MrPerfekt/Maya/Doc/Bachelorarbeit10/img/tikz/hbridgeSchematic.tex

\begin{circuitikz}
\draw
(0,0) to[battery,l=$V_{\text{}}$] ++(0,4)
++(0,0) -- ++(2,0) coordinate (LT)
%%%  H-bridge 1st leg
(LT) ++(2,-1) node [pnp,scale=1,name=igbt1] {}
++(0,-2) node [npn,scale=1,name=igbt3] {}
(igbt1.E) |- (LT)
(igbt1.C) -- (igbt3.C)
(igbt3.E) |- (0,0)
%%% H-bridge 2nd leg
(LT) ++(7,-1) node [pnp,scale=1,name=igbt2, xscale=-1] {}
++(0,-2) node [npn,scale=1,name=igbt4, xscale=-1] {}
(igbt2.E) |- (LT)
(igbt2.C) -- (igbt4.C)
(igbt4.E) |- (0,0)
%%% Output
(LT) ++(2,-2) node[circ] {} to[short,-o] ++(1.3,0) node[anchor=north] {A}
(LT) ++(7,-2) node[circ] {} to[short,-o] ++(-1.3,0) node[anchor=north] {B}
(LT) ++(3.3,-2) to [L,scale=1,name=l1] ++(2.4,0)
%%% Motor Control
(2,-0.5) rectangle (11,-1.5)
(3,-0.5) |- (igbt1.B)
(3.2,-0.5) |- (igbt3.B)
(10.2,-0.5) |- (igbt2.B)
(10,-0.5) |- (igbt4.B)
%%% Diodes
(LT) ++(2.8,-4) node[circ] {} to [Do,scale=1,name=diode0] ++(0,2) node[circ] {} to [Do,scale=1,name=diode1] ++(0,2) node[circ] {}
(LT) ++(6.2,-4) node[circ] {} to [Do,scale=1,name=diode2] ++(0,2) node[circ] {} to [Do,scale=1,name=diode2] ++(0,2) node[circ] {}
;
\node (note1) at (6,-1) {Motor Control};
\end{circuitikz}
