MrPerfekt/Maya/Doc/Bachelorarbeit10/img/tikz/schmittTriggerSchematic.tex

\center
\begin{circuitikz}
\draw (0,0) node[op amp] (opamp) {};
\draw (-4,-0.49) node[anchor=east]{In} to[resistor,o-] (-2,-0.49) -- (opamp.+) (-2.2,-0.49);
\draw (-1.5,-0.49) -- (-1.5, -2) to[resistor] (1.5,-2) -- (1.5,0);
\draw (-2,0.49) node[anchor=east]{Gnd} to[short, o-] (opamp.-) (-2.2,0.49);
\draw (1,0) to[short, -o] (2,0) -- (opamp.out) (2.1,0) node[anchor=west] {Out};
\end{circuitikz}
