MrPerfekt/Maya/Doc/Bachelorarbeit10/img/tikz/FotodiodesMeshPlotSingle.tex

%\begin{comment}
\begin{tikzpicture}[scale=1]
\begin{axis}[xlabel=x,ylabel=y]
\addplot3 [surf, mesh/ordering=y varies, restrict expr to domain={z >= 5}{1:1}] table[x index=0, y index=1, z index=4, col sep=tab] {img/DiodePositionPlot/DiodePositionPlot02.txt};
\end{axis}
\end{tikzpicture}
\begin{tikzpicture}[scale=1]
\begin{axis}[xlabel=x,ylabel=y]
\addplot3 [surf, mesh/ordering=y varies, restrict expr to domain={z >= 5}{1:1}] table[x index=0, y index=1, z index=4, col sep=tab] {img/DiodePositionPlot/DiodePositionPlot03.txt};
\end{axis}
\end{tikzpicture}
%\end{comment}
%\input{img/tikz/FotodiodesMeshPlotSingleBad}
%\input{img/tikz/FotodiodesMeshPlotSingleGood}
