MrPerfekt/Maya/Doc/Bachelorarbeit10/img/tikz/opamp.tex

\center
\begin{circuitikz}
\draw (0,0) node[op amp] (opamp) {};
\draw (-2,-0.49) to[short, o-] (opamp.+) (-2.2,-0.49) node[anchor=east] {Vin+};
\draw (-2,0.49) to[short, o-] (opamp.-) (-2.2,0.49) node[anchor=east] {Vin-};
\draw (-0.08,1.5) to[short, o-] (opamp.up) (-0.08,1.6) node[anchor=south] {+};
\draw (-0.08,-1.5) to[short, o-] (opamp.down) (-0.08,-1.6) node[anchor=north] {-};
\draw (1,0) to[short, -o] (2,0) -- (opamp.out) (2.1,0) node[anchor=west] {out};
\end{circuitikz}
