MrPerfekt/Maya/Doc/Bachelorarbeit10/img/tikz/tia.tex

\begin{circuitikz}[scale=1]
	\draw(5,.5)
	node [op amp] (opamp) {}
	%node A at ($(opamp.+)+(-0.4,0)$)
	%(0,0) node [left] {$U_{we}$}
	%to [R, l=$R_d$, o-*] (2,0)
	%to [R, l=$R_d$, *-*] (opamp.+)
	%to [C, l_=$C_{d2}$, *-] ($(opamp.+)+(0,-2)$) node [ground] {}
	(opamp.+) -| (3,-0.3) node [ground] {}
	(3,0) to [pDo, *-*] (3,1)
	%(opamp.+) [pDo] (opamp.-)
	(opamp.out) |- (5.5,2) to [R, l_=$R$, -] (3,2) |- ($(opamp.-)$)
	(5.5,2) to [short, *-] (5.5,3.2) to [C, l_=$C$, -] (3,3.2) to [short, -*] (3,2)
	(opamp.out) to [short, *-o] (7,.5) node [right] {$U_{out}$};
\end{circuitikz}
