MrPerfekt/Maya/Doc/Folien/Notes.odt

Sehr geehrte Damen und Herren.

Es freut mich, Ihnen meine Bachelor Arbeit präsentieren zu dürfen.

Das Ziel dieser Arbeit war, ein neuer Prototyp für das Mikrocomputer Labor.

Wie die meisten Prototypen musste auch dieser, etwas anspruchsvolles, spannendes und für die Studierenden motivierendes werden.

Die Vorgabe für diesen Prototypen war, das eine Laserablenkeinheit vorhanden ist.

Das Ziel welches anvisiert werden muss, soll beweglich sein und detektieren können ob es getroffen worden ist.

Die erste Überlegung war ein Pendel mit Fotodioden.

Auf dem Pendel ist eine Encoder-Scheibe montiert, welche von Lichtschranken abgegriffen wird.

Damit ist auch der Winkel des Pendels und der Fotodioden bekannt.

Mit verschiedenen Prototypen entwickelte sich das ursprüngliche Pendel zu einer Scheibe.

Die beiden zentralen Objekte sind die Vier-Quadranten-Fotodioden zur Detektion des Lasers, diese ist auf unten auf der Scheibe eingezeichnet und der Laserablenkeinheit.

Auch diese besitzt wieder eine Encoder-Scheibe.

Dies ist nötig, damit der Drehwinkel der Quadranten-Fotodiode bekannt ist.

Theoretisch ist auch eine Steuerung möglich, welche nur mit den Werten des Drehencoders gespeist wird.

Dafür stellen allerding die Fertigungabweichungen der Spiegelhalterungen eine zu große Unbekannte dar, welche nur unzureichend ermittelt werden kann.

Für die Positionierung der Spiegel werden Getriebe-Schrittmotoren benötigt, welche eine Schrittweite von einem Zehntel Grad besitzen.

Die Laserablenkeinheit ist aufgebaut aus zwei Schrittmotoren, einen für jede Achse, auf welchen ein Spiegel montiert ist.

Zur Überprüfung, ob die Zielposition des Lasers in einem ungefährlichen Bereich ist, sind auch Positionsmarken auf den Spiegel angebracht.

Ein Ungefährlicher Bereich ist jede Position auf der Rückplatte.

Diese Positionsmarken werden von Lichtschranken überprüft und im Fall einer ungültigen Position wird der Laser sofort abgeschaltet.

Der Prinzipielle Hardware-Aufbau dieses Prototypen unterteilt sich in die Sensoren und Aktuatoren, das Arduino Entwicklungsboard mit einem SAM3X von Atmel und das Nucleo Board mit dem STM32F3 von ST.

Die Aufgabe des SAM ist es, die Hardware zu verwalten und die Kommunikation mit dem STM.

Auf dem STM wird der Code der Laborteilnehmer ausgeführt.

Damit eventuelle Fehler in den Signalen der Laborteilnehmer erkannt und unterbunden werden können ist der STM nur mit dem SAM verbunden.

Der SAM Controller überprüft alle Steuerbefehle und gibt diese an die Hardware weiter.

Als Sensoren stehen die Lichtschranken der Schrittmotoren, ein Rotationsencoder für den Drehwinkel der Scheibe, und Fotodioden zur Verfügung.

Als Aktuatoren stehen der Antriebsmotor der Scheibe zur Verfügung, für welchem nur die Geschwindigkeit gesetzt werden kann und die beiden Schrittmotoren der Spiegelablenkeinheit.

Die Aufgabe der Laborteilnehmer ist es, die Schrittmotoren zu steuern.

Als Eingabewerte stehen dafür nur die Werte der Photodioden und das Quadratursignal des Rotationsencoder zur Verfügung.

Bei dem Quadratursignal muss zusätzlich eine Zusatzmarke erkannt werden, welche einen Justierpunkt angibt.

Zusätzlich muss eine komplett asynchrone Ansteuerung der Schrittmotoren implementiert werden.

Die Steuersignale werden von dem SAM nur durchgeschleift.

In Summe ist dies eine sehr herausfordernde Aufgabenstellung.

Nun möchte ich das Interessanteste Thema dieser Arbeit etwas näher erläutern - die Regelung der Spiegelablenkeinheit.

Der Regler ist ein 3-Punktregler und arbeitet mit den von den Fotodioden gemessenen Intensitäten.

In diesem 3-Dimenionalen Bild sehen sie den Verlauf des Ausgangssignals einer Fotodiode, wenn diese mit dem Laser abgetastet wird.

Der Abstand zweier Punkte ist ein Halbschritt des Schrittmotors und die Höhe gibt den Wert der Eingangsdaten an welcher auf 1000 Normiert ist.

In diesem Bild ist sehr deutlich sichtbar, dass die Fotodiode bereits in der Sättigung ist.

Mit Eingangsdaten, welche sättigen können, ist natürlich keine Regelung implementierbar.

Werden nun allerdings alle 4 Dioden in einem Bild dargestellt, sieht man, dass kein Bereich existiert, bei dem alle 4 Dioden sättigen.

Dadurch ist wieder eine Regelung möglich und man würde wichtige Informationen verlieren, wenn die Verstärkung reduziert werden würde.

Nun müssen diese Eingangsdaten so aufbereitet werden, dass diese von der Regelung verwendet werden können.

Schließlich werden nur 2 Eingangswerte benötigt und nicht 4.

2 Deshalb, weil wir für jede Achse einen Regler benötigen.

Eine gute Möglichkeit, die Daten für den ersten Regler zu verarbeiten ist es die Maximalwerte der linken und Rechten Dioden voneinander zu subtrahieren.

Dies ist in Folgendem Bild dargestellt.

Hier gibt jeder Punkt an, ob der Laser zu weit links oder zu weit rechts gewesen ist.

Die roten und die blauen Punkte erfordern nun eine Interaktion des Reglers.

Wenn nun die Interaktionen des Reglers berechnet worden sind, müssen diese noch Koordinatentransformiert werden.

Die Koordinatentransformation basiert auf den Eingangsdaten des Rotationsencoders.

Dabei werden die Ausgangssignale so gedreht, dass dieser mit dem Aktuellen Winkel der Dioden übereinstimmt.

Die Abweichung zu dem Korrekten Winkel ist dabei relativ unkritisch.

Wichtig ist dabei dass dieser nicht mehr als +/- 45° abweicht, da dadurch der Horizontale und der Vertikale Regler vertauscht werden würde.

Dies ist in diesem Bild dargestellt.

In diesem 3D-Modell sehen Sie nun die Endversion des Prototypen.

Nun möchte ich Ihnen den Prototypen demonstrieren.

Ich hoffe, dass ich Ihnen einen Einblick in meine Arbeit geben konnte und dass es Ihnen gefallen hat.

Sollten bei dieser Präsentation noch offene Fragen geblieben sein, werde ich diese gerne Beantworten.

Danke für Ihre Aufmerksamkeit.

Freud mich Präsentieren

Ziel Prototyp Labor

Prototypen spannend, anspruchsvoll motivierend

Vorgabe Laserablenkeinheit

Ziel beweglich, detektieren

Pendel Fotodioden

Encoder-Scheibe Lichtschranken

Winkel Pendels

Scheibe

4-Diode Laserablenkeinheit

Encoder-Scheibe

Drehwinkel 4-Diode

Steuerung Drehencoders

Spiegelhalterungen Unbekannte dar

Spiegel Getriebe-Schrittmotoren 1/10 Grad

Laserablenkeinheit Schrittmotoren Achse Spiegel

Ungefährlichen Positionsmarken

Rückplatte

Positionsmarken Lichtschranken Laser abgeschalten

Hardware-Aufbau Sensoren Aktuatoren, Arduino SAM3X Atmel, Nucleo Board STM32F3 ST

SAM Hardware Kommunikation

STM Laborteilnehmer

Fehler Signalen Laborteilnehmer STM SAM

SAM überprüft

Sensoren Lichtschranken

Aktuatoren Antriebsmotor Schrittmotoren

Interessanteste Thema Regelung

3-Punktregler Fotodioden

abgetastet

Halbschritt 1000

Sättigung

Keine implementierbar

Alle Bereich Position sättigen

Informationen Verstärkung

Aufbereitet verwendet

2 benötigt 4

Achse Regler

Möglichkeit Maximalwerte subtrahieren

dargestellt

Punkt links rechts

Roten Blau Interaktion

Punkte Interaktion

Wahl Schwellwerte

Hoch => maximale Radius => Laserpunkt verloren.

Niedrig => stabile klein

Problem Größenordnung Zielbereichs Spiegelablenkeinheit

Bereich verkleinert stabilen Zielpunkt

3D Endversion

Demonstrieren

Einblick gefallen

offene Fragen gerne Beantworten

Aufmerksamkeit
