MrPerfekt/Maya/Doc/Bachelorarbeit10/img/tikz/fsmStepperVollschritt.tex

\begin{tikzpicture}[->,>=stealth',shorten >=1pt,auto,node distance=3cm,
thick,main node/.style={circle,fill=blue!20,draw,font=\sffamily\Large\bfseries}]

\node[main node] (1) {1 1};
\node[main node] (2) [below left of=1] {-1 1};
\node[main node] (3) [below right of=2] {-1 -1};
\node[main node] (4) [below right of=1] {1 -1};

\path[every node/.style={font=\sffamily\small}]
(1) edge 				node [left] 	{F} (4)
(1) edge [bend right] 	node[left] 	{B} (2)
(2) edge 				node [right] 	{F} (1)
(2) edge [bend right] 	node[left] 	{B} (3)
(3) edge 				node [right]	{F} (2)
(3) edge [bend right] 	node[right] 	{B} (4)
(4) edge 				node [left]	{F} (3)
(4) edge [bend right] 	node[right] 	{B} (1);
\end{tikzpicture}
