MrPerfekt/Maya/Doc/Bachelorarbeit10/img/tikz/schmittTriggerDiagram.tex

\pgfmathsetmacro{\pos}{0.2}
\pgfmathsetmacro{\sinFactor}{0.2}
\begin{tikzpicture}
	\begin{scope}[xscale=3, yscale=3]
	 	%Draw grid
		%\draw [color=gray!50]  [step=1] (0,0) grid (15,3);
		%Draw axles
		\draw[->,thick] (0,0) -- (5,0) node[right] {$x$};
		\draw[->,thick] (0,0) -- (0,1.5) node[above] {$y$};
		\draw (0,0)[color=green,line width=1.5pt] plot [const plot] coordinates{(0,0) (0+\pos,0) (0+\pos,1) (1+\pos,1) (1+\pos,0) (2+\pos,0) (2+\pos,1) (3+\pos,1) (3+\pos,0) (4+\pos,0) (4+\pos,1) (4.5,1)};
		%Draw Sin
		\draw (0,0)[color=blue] plot[domain=0:4.5,samples=200] (\x ,{ sin(\x*pi*115 / 2) / 2+0.5 });
		\draw(0,0)[-,thick,color=red] (0,{sin(\pos*pi*115 / 2) / 2+0.5}) --+(4.5,0);
		\draw(0,0)[-,thick,color=red] (0,{-sin(\pos*pi*115 / 2) / 2+0.5}) --+(4.5,0);
		%\draw[gray,->] (-0.3,0) -- (pi+0.3,0);
	\end{scope}
\end{tikzpicture}
