MrPerfekt/Maya/Doc/Folien/Folien.pdf

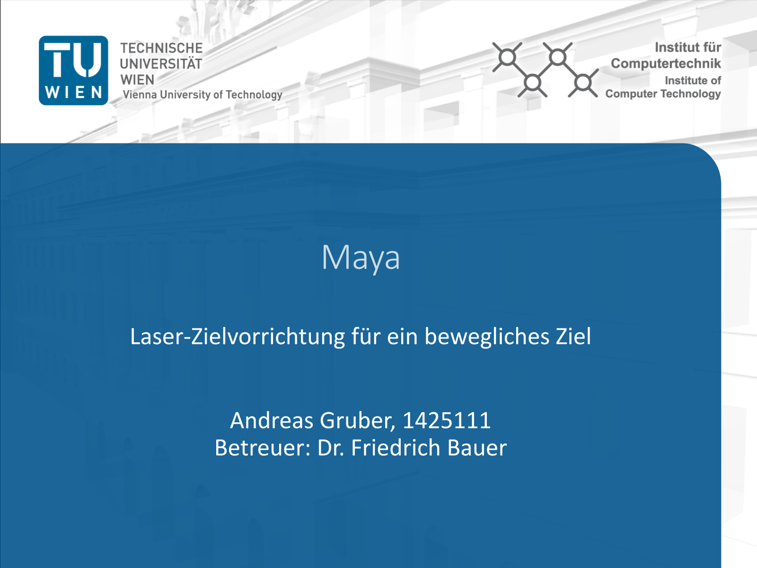
[picture p34: page 1]

Institute of
Computer Technology | /9

# Maya

# Laser-Zielvorrichtung für ein bewegliches Ziel

# Andreas Gruber, 1425111 Betreuer: Dr. Friedrich Bauer

# Aufgabenstellung

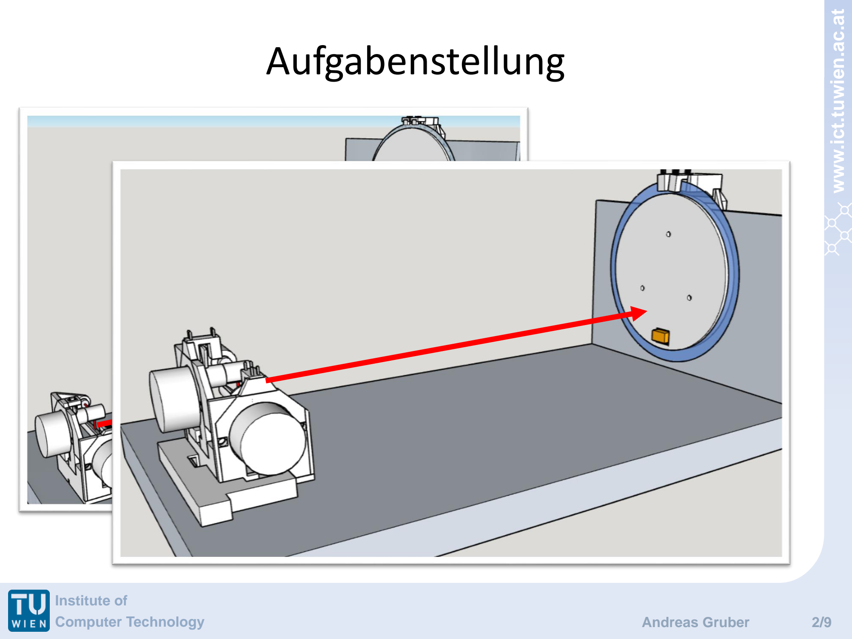
[picture p35: page 2]

## www.ict.tuwien.ac.at

Andreas Gruber | 2

## www.ict.tuwien.ac.at

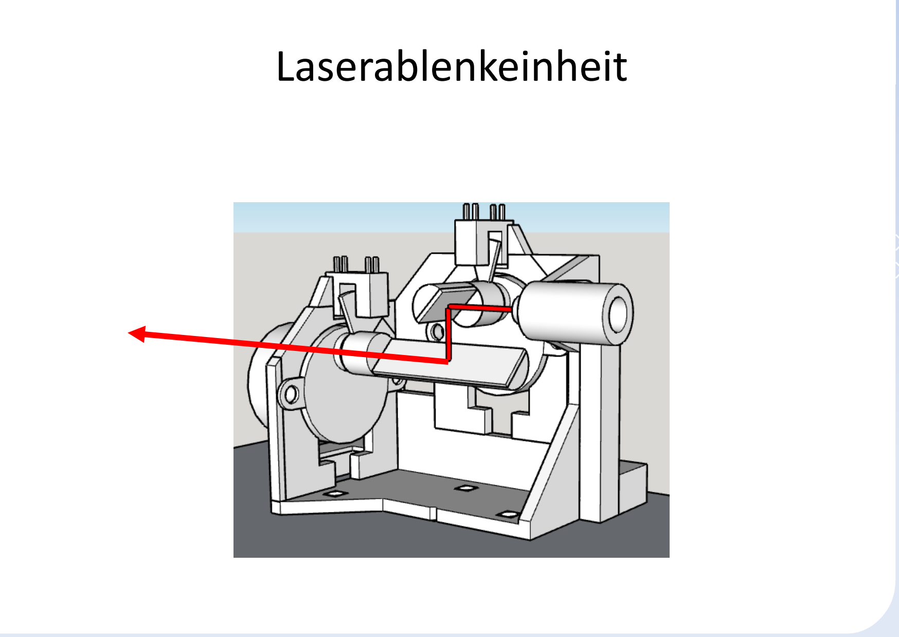
[picture p36: figure]
Laserablenkeinheit

Andreas Gruber | 3

## www.ict.tuwien.ac.at

# Hardware-Aufbau

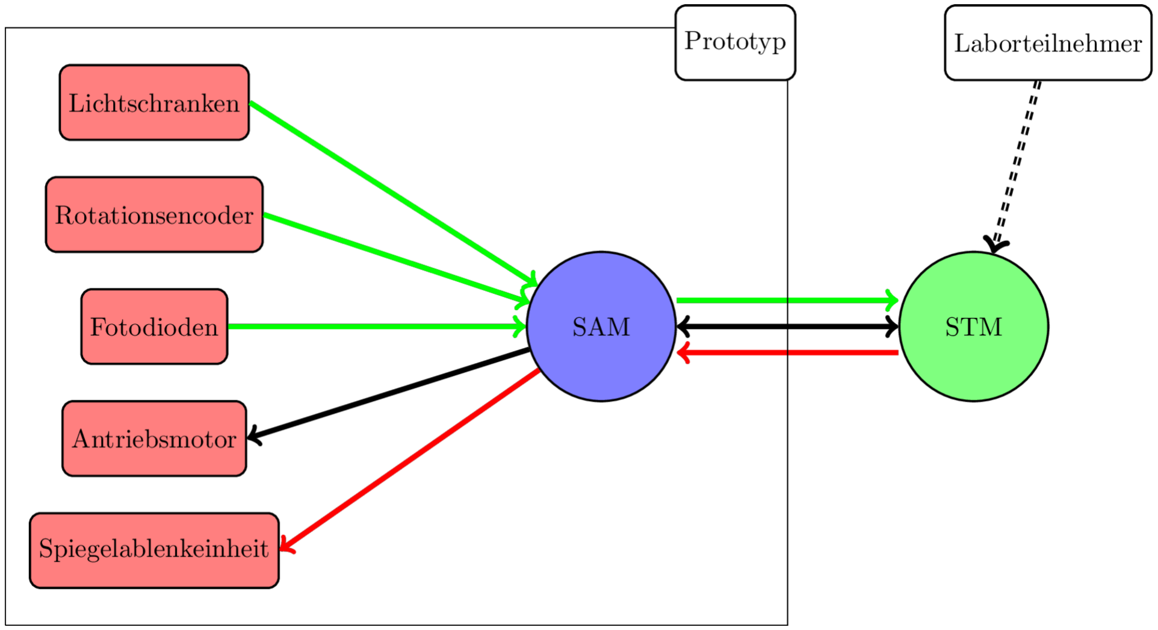
[picture p37: figure]

Andreas Gruber | 4

## www.ict.tuwien.ac.at

# Ausgabe einer Fotodiode

# Intensität (norm. auf 1000) vs. Halbschritte

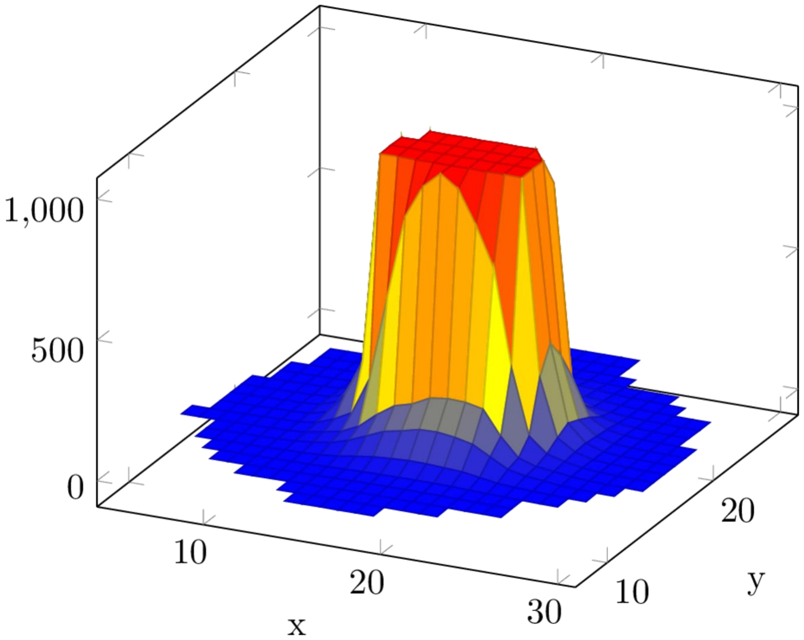
[picture p38: figure]

Andreas Gruber | 5

## www.ict.tuwien.ac.at

# Ausgabe aller Fotodioden

# Intensität (norm. auf 1000) vs. Halbschritte

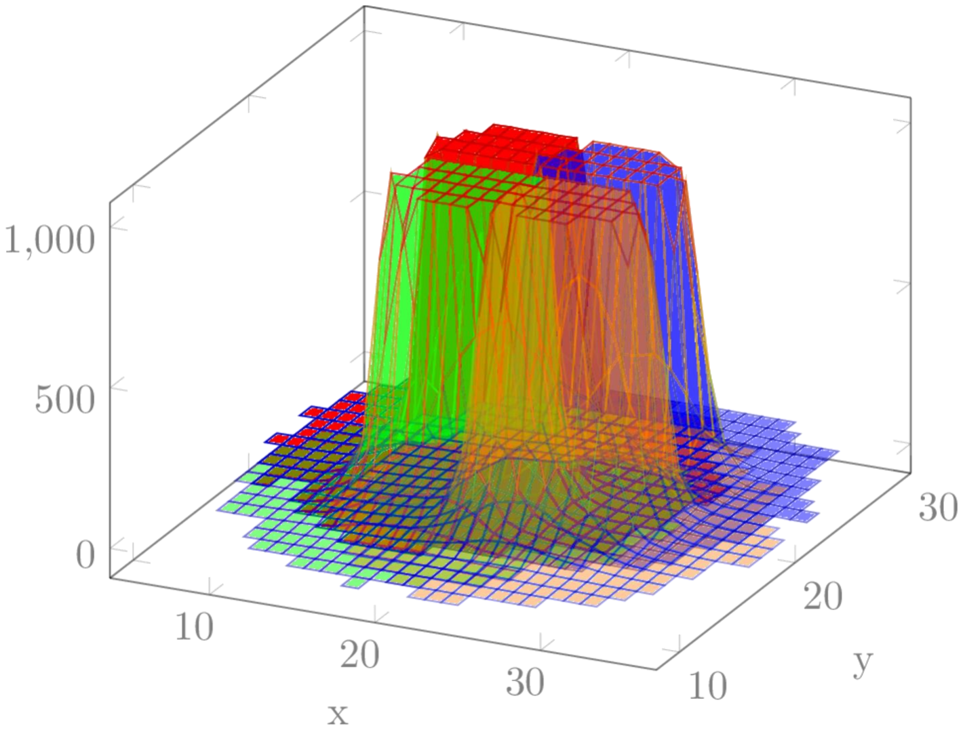
[picture p39: figure]

Andreas Gruber | 6

## www.ict.tuwien.ac.at

# Eingangsdaten des Dreipunktreglers

# Intensität (norm. auf 1000) vs. Halbschritte

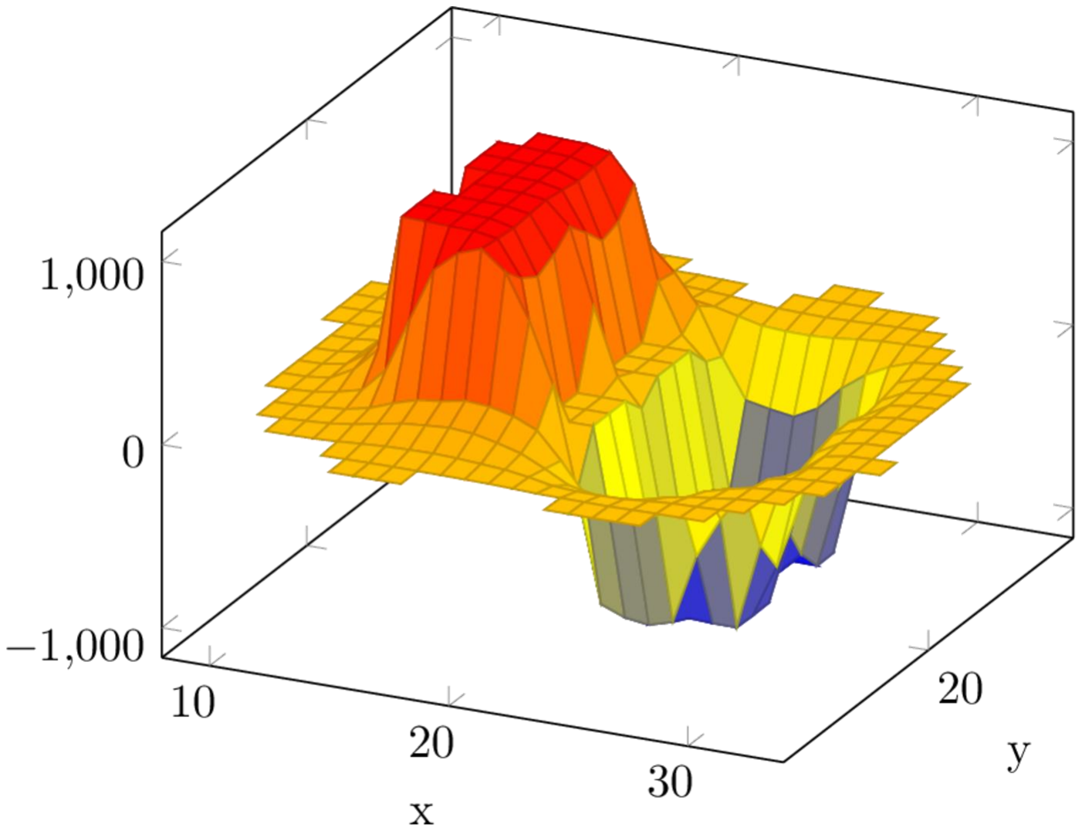
[picture p40: figure]

Andreas Gruber | 7

# Koordinatentransformation

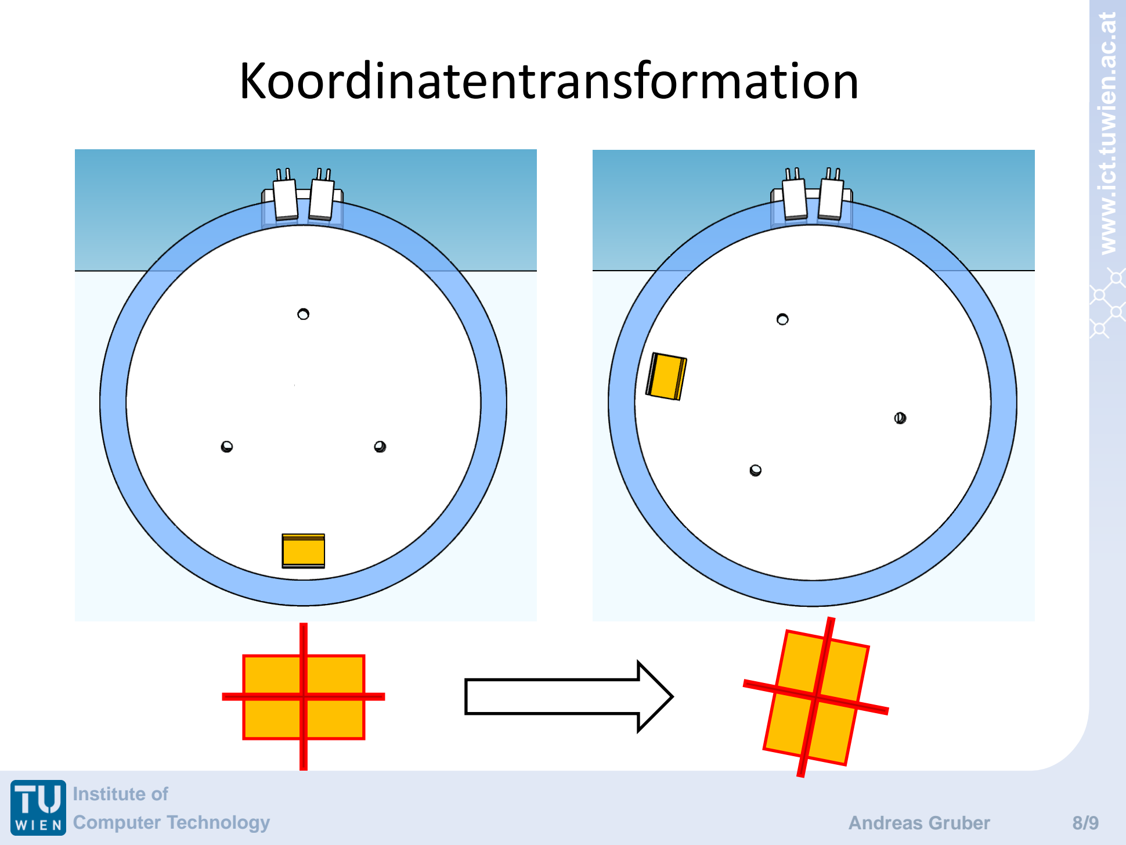
[picture p41: page 8]

## www.ict.tuwien.ac.at

Andreas Gruber | 8

# Finale Version

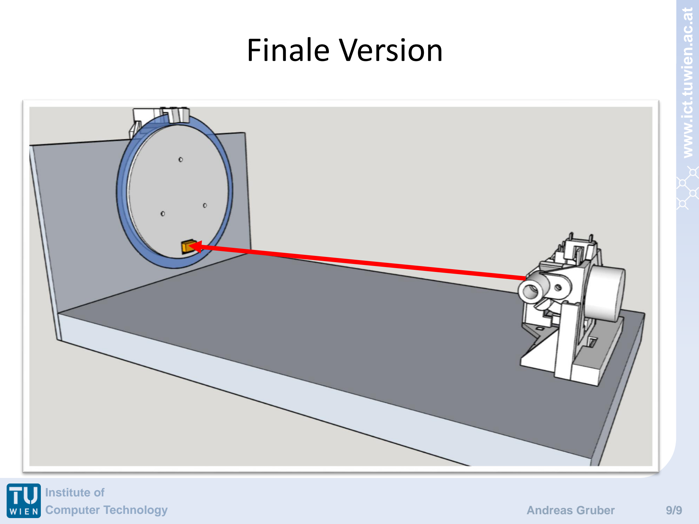
[picture p42: page 9]

## www.ict.tuwien.ac.at

Andreas Gruber | 9

## www.ict.tuwien.ac.at

# Demo

Andreas Gruber | 10

## www.ict.tuwien.ac.at

# Vielen Dank für Ihre Aufmerksamkeit!

Andreas Gruber | 11
