MrPerfekt/Maya/Doc/Bachelorarbeit10/FotodiodesMeshPlotAddAllStandalone.png

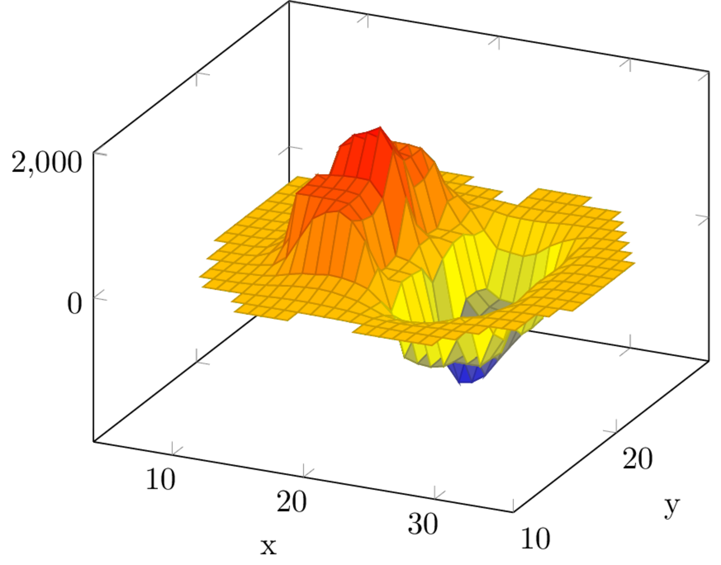
Doc/Bachelorarbeit10/FotodiodesMeshPlotAddAllStandalone.png
