MrPerfekt/Maya/Doc/Bachelorarbeit10/FotodiodesMeshPlotMaxControllerStandalone.png

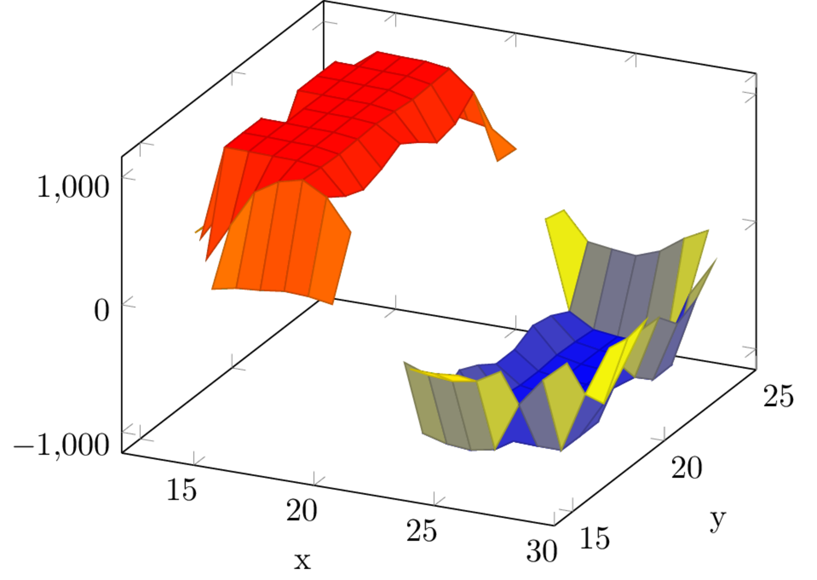
Doc/Bachelorarbeit10/FotodiodesMeshPlotMaxControllerStandalone.png
