MrPerfekt/Maya/Doc/Bachelorarbeit10/img/Eagle/TIA00.png

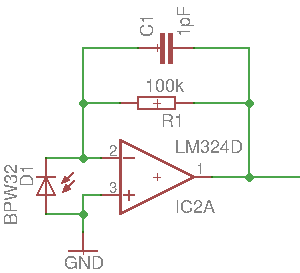
Doc/Bachelorarbeit10/img/Eagle/TIA00.png
