MrPerfekt/Maya/Doc/Bachelorarbeit10/img/Eagle/TIA02.png

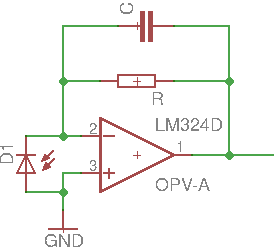
Doc/Bachelorarbeit10/img/Eagle/TIA02.png
