MrPerfekt/Maya/Doc/Bachelorarbeit10/img/Images/20160326_142137.jpg

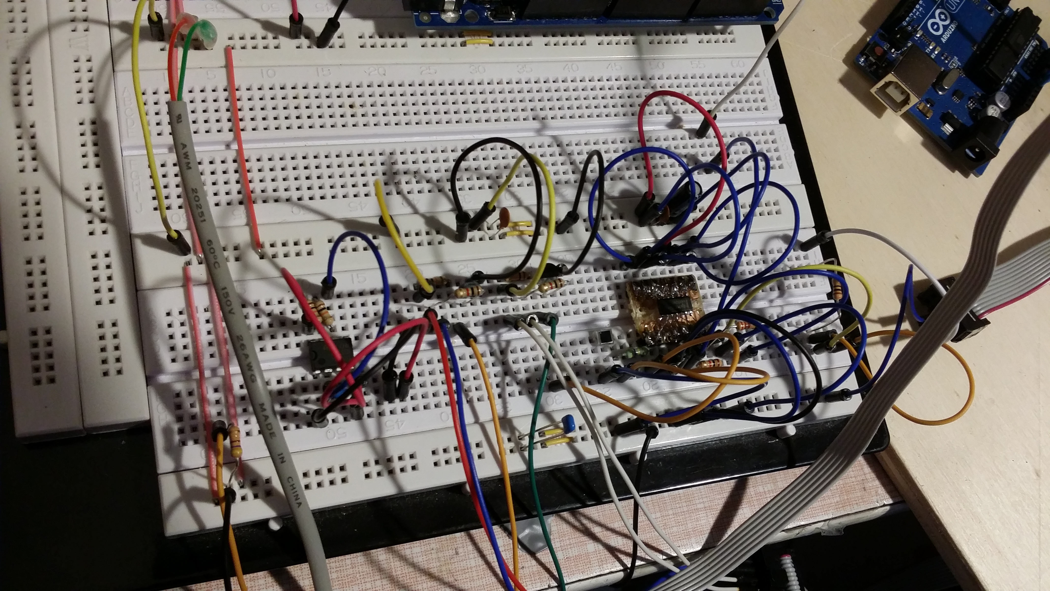
Doc/Bachelorarbeit10/img/Images/20160326_142137.jpg
