MrPerfekt/Maya/Doc/Bachelorarbeit10/img/Images/20160326_142140.jpg

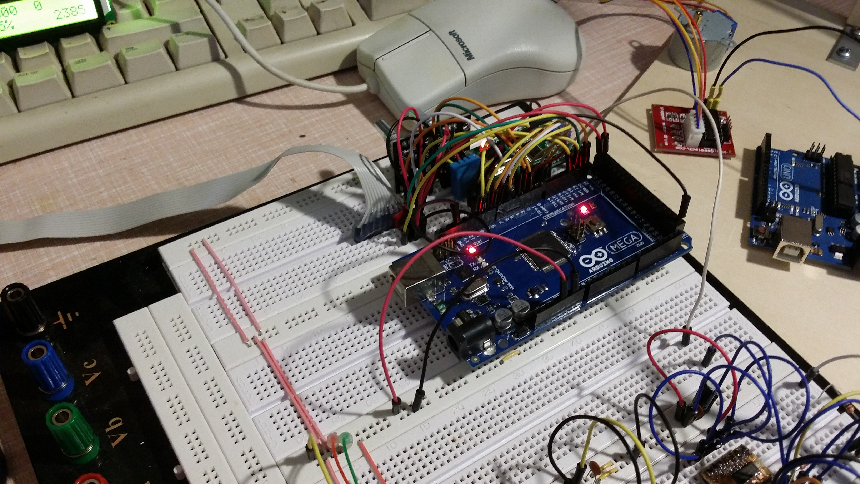
Doc/Bachelorarbeit10/img/Images/20160326_142140.jpg
