MrPerfekt/Maya/Doc/Bachelorarbeit10/img/Images/20160326_144615.jpg

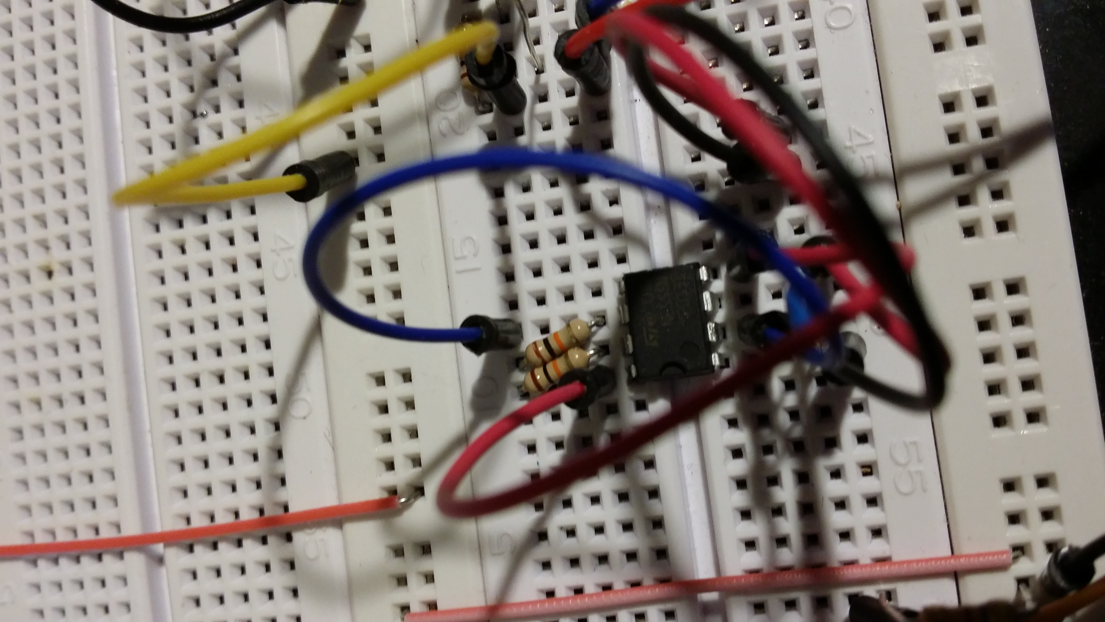
Doc/Bachelorarbeit10/img/Images/20160326_144615.jpg
