MrPerfekt/Maya/Doc/Bachelorarbeit10/img/Images/20160402_081752.jpg

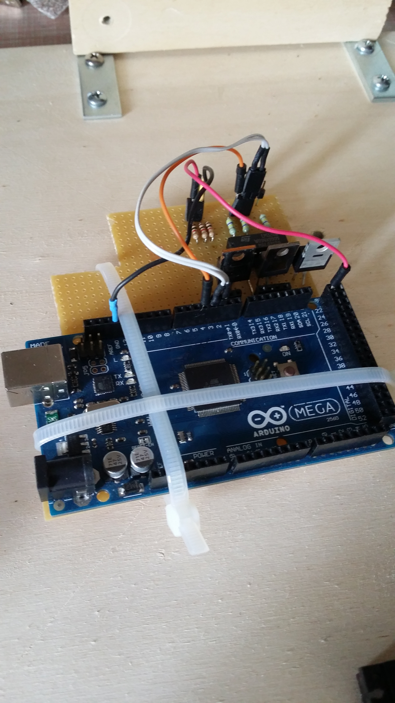
Doc/Bachelorarbeit10/img/Images/20160402_081752.jpg
