MrPerfekt/Maya/Doc/Bachelorarbeit10/img/Images/20160402_134538.jpg

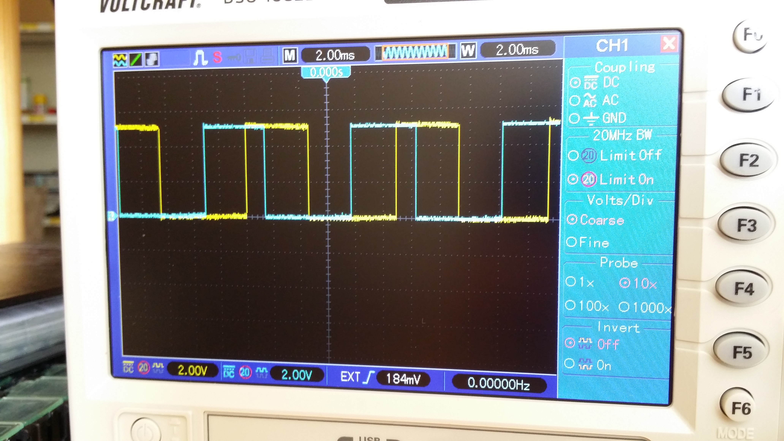
Doc/Bachelorarbeit10/img/Images/20160402_134538.jpg
