MrPerfekt/Maya/Doc/Bachelorarbeit10/img/Images/20160402_145206.jpg

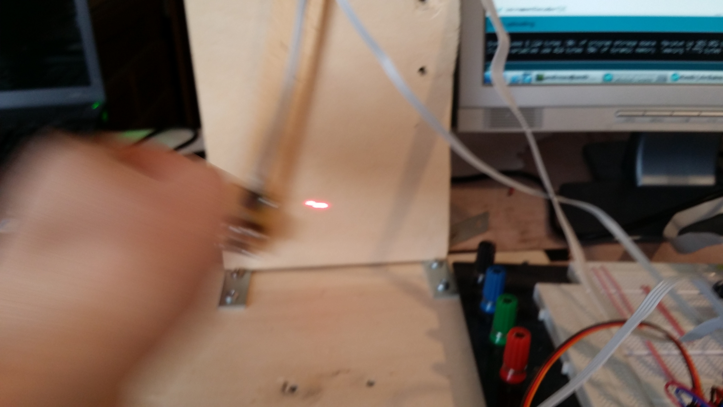
Doc/Bachelorarbeit10/img/Images/20160402_145206.jpg
