MrPerfekt/Maya/Doc/Bachelorarbeit10/img/Images/20160423_182816.jpg

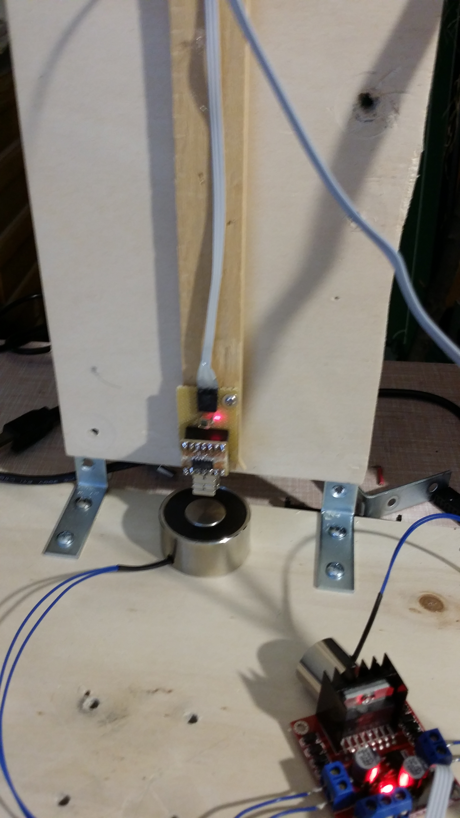
Doc/Bachelorarbeit10/img/Images/20160423_182816.jpg
