MrPerfekt/Maya/Doc/Bachelorarbeit10/img/Images/20160423_190528.jpg

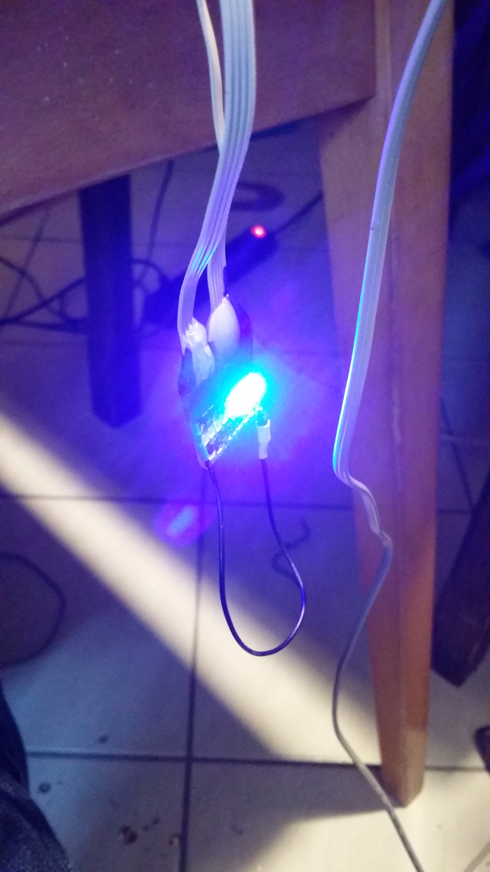
Doc/Bachelorarbeit10/img/Images/20160423_190528.jpg
