MrPerfekt/Maya/Doc/Bachelorarbeit10/img/Images/20160423_233413.jpg

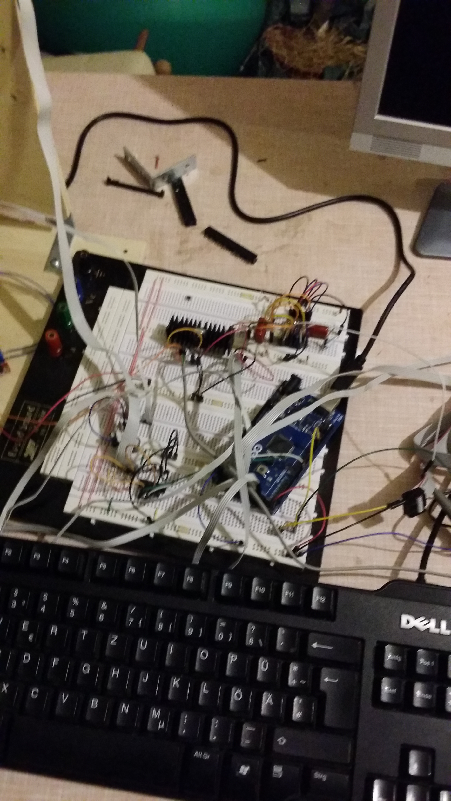
Doc/Bachelorarbeit10/img/Images/20160423_233413.jpg
