MrPerfekt/Maya/Doc/Bachelorarbeit10/img/Images/20160423_233416.jpg

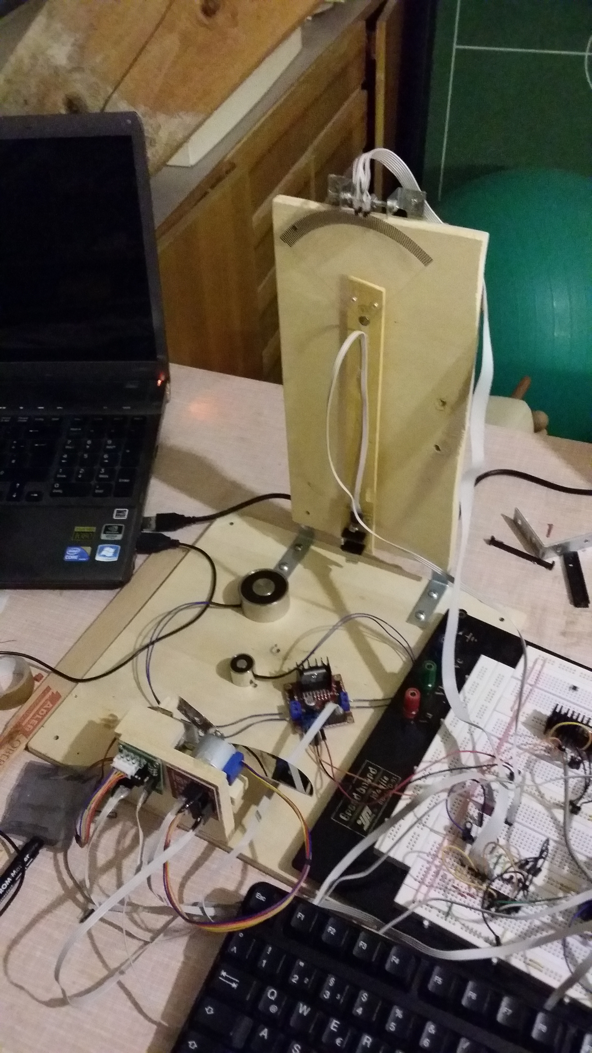
Doc/Bachelorarbeit10/img/Images/20160423_233416.jpg
