MrPerfekt/Maya/Doc/Bachelorarbeit10/img/Images/20160424_133001.jpg

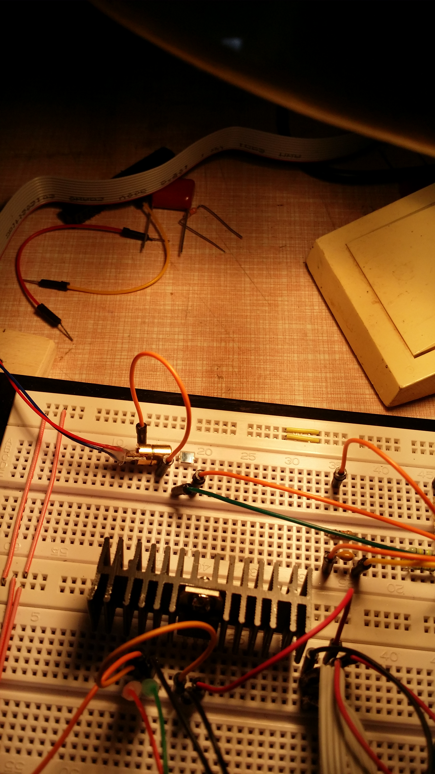
Doc/Bachelorarbeit10/img/Images/20160424_133001.jpg
