MrPerfekt/Maya/Doc/Bachelorarbeit10/img/Images/20160506_072428.jpg

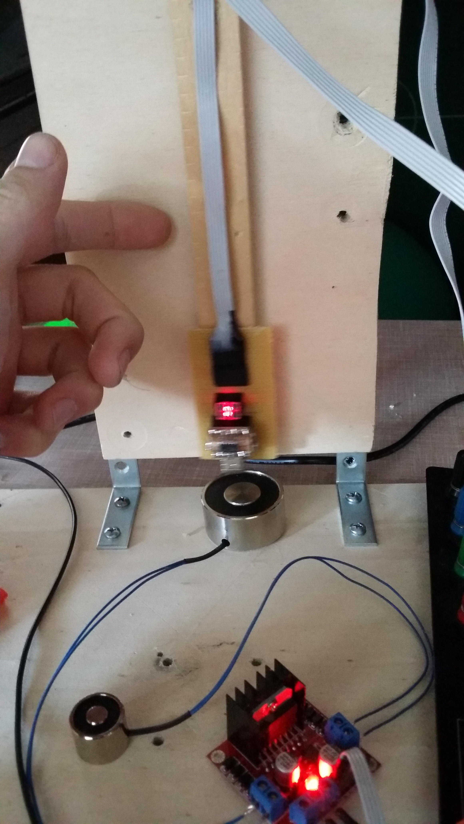
Doc/Bachelorarbeit10/img/Images/20160506_072428.jpg
