MrPerfekt/Maya/Doc/Bachelorarbeit10/img/Images/20160506_073121 (1).jpg

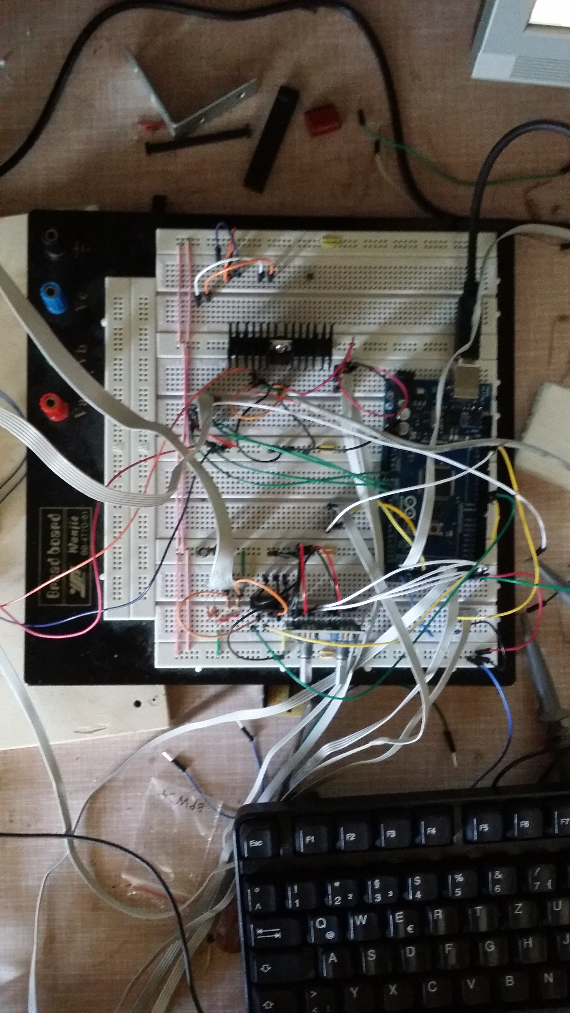
Doc/Bachelorarbeit10/img/Images/20160506_073121 (1).jpg
