MrPerfekt/Maya/Doc/Bachelorarbeit10/img/Images/20160506_073135.jpg

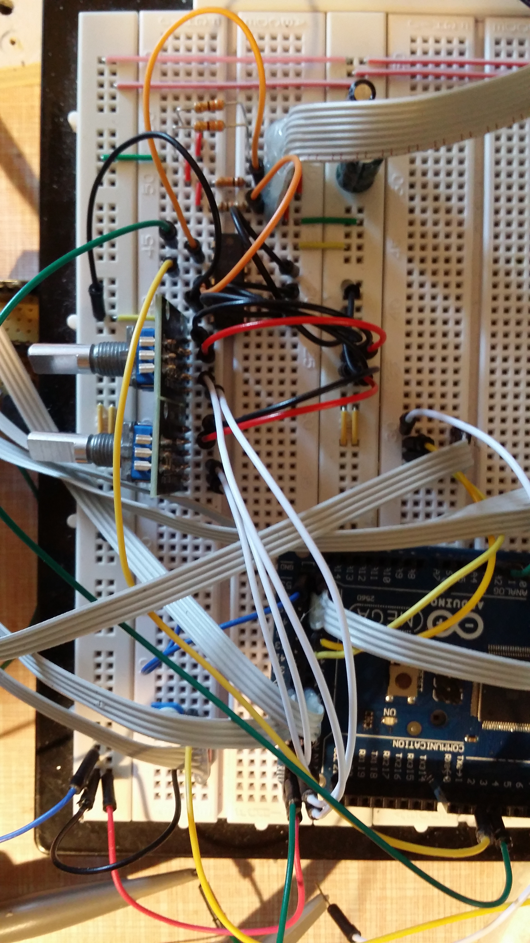
Doc/Bachelorarbeit10/img/Images/20160506_073135.jpg
