MrPerfekt/Maya/Doc/Bachelorarbeit10/img/Images/20160507_151211.jpg

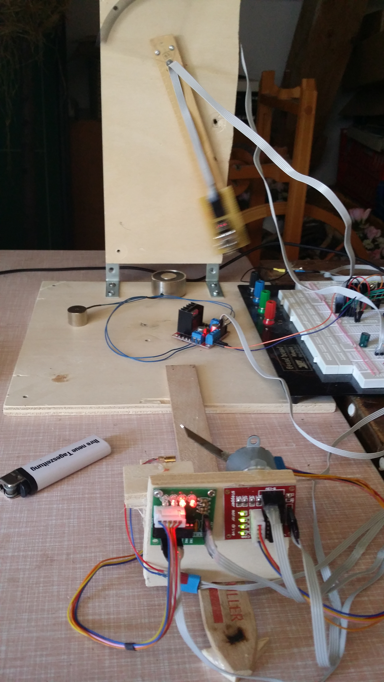
Doc/Bachelorarbeit10/img/Images/20160507_151211.jpg
