MrPerfekt/Maya/Doc/Bachelorarbeit10/img/Images/20160507_152133.jpg

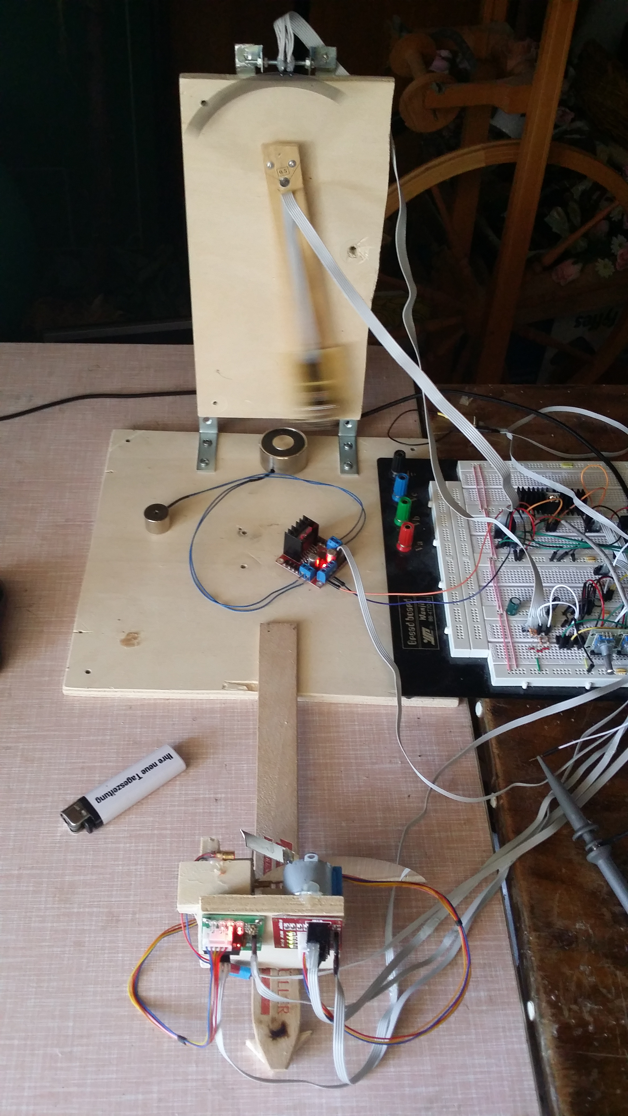
Doc/Bachelorarbeit10/img/Images/20160507_152133.jpg
