MrPerfekt/Maya/Doc/Bachelorarbeit10/img/Images/20160520_165632(0).jpg

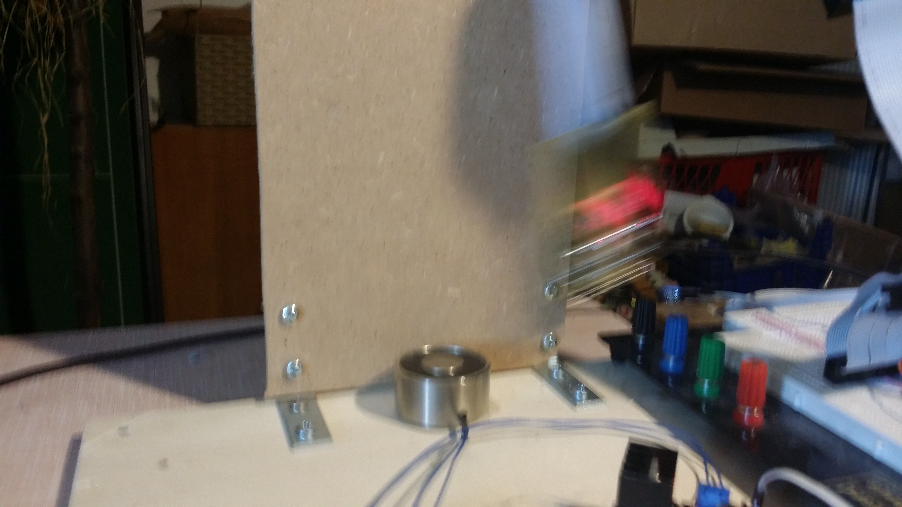
Doc/Bachelorarbeit10/img/Images/20160520_165632(0).jpg
