MrPerfekt/Maya/Doc/Bachelorarbeit10/img/Images/20160522_073745.jpg

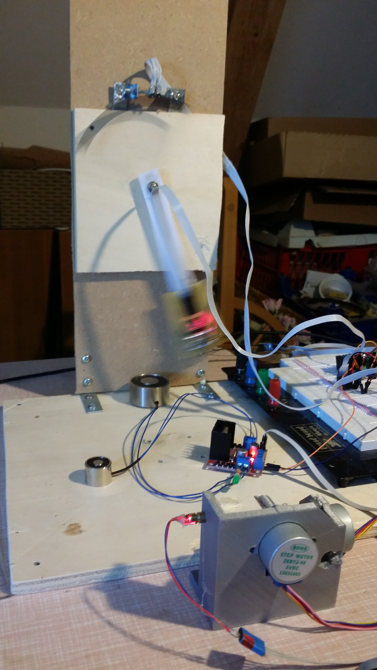
Doc/Bachelorarbeit10/img/Images/20160522_073745.jpg
