MrPerfekt/Maya/Doc/Bachelorarbeit10/img/Images/20170116_180935.jpg

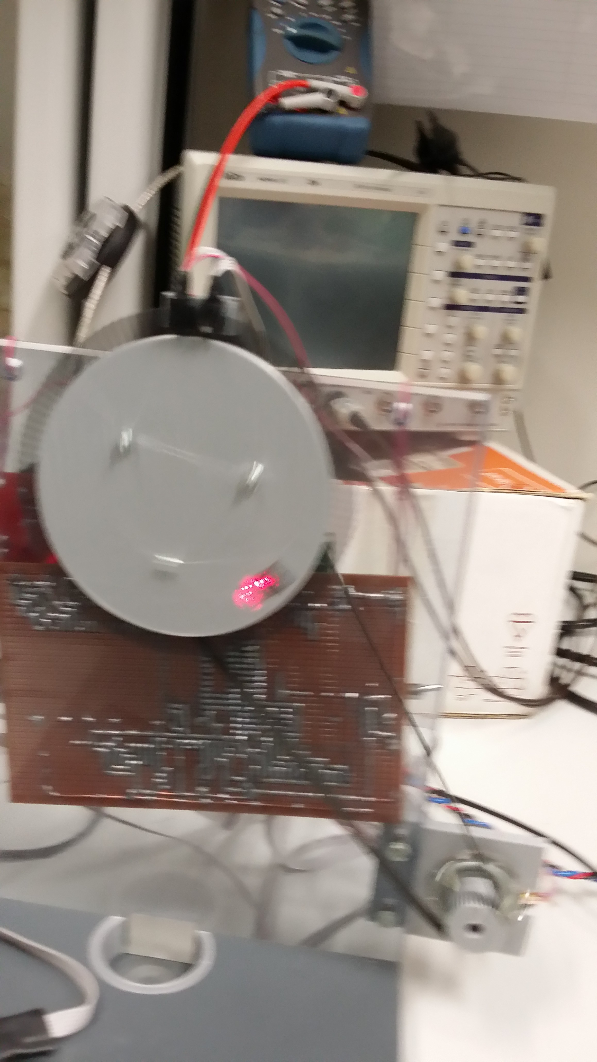
Doc/Bachelorarbeit10/img/Images/20170116_180935.jpg
