MrPerfekt/Maya/Doc/Bachelorarbeit10/img/Images/20170116_181656.jpg

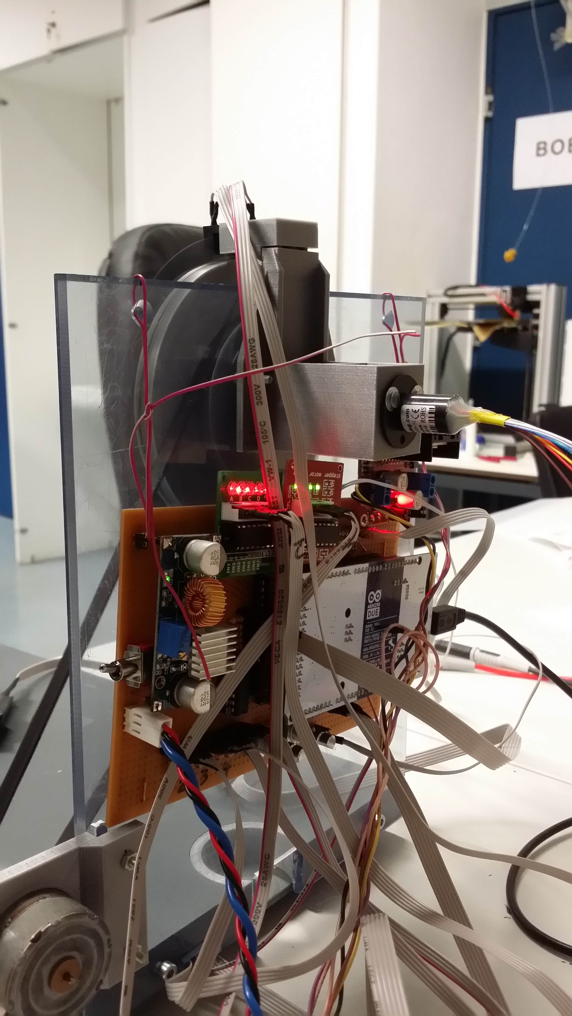
Doc/Bachelorarbeit10/img/Images/20170116_181656.jpg
