MrPerfekt/Maya/Doc/Bachelorarbeit10/img/Images/20170116_181659.jpg

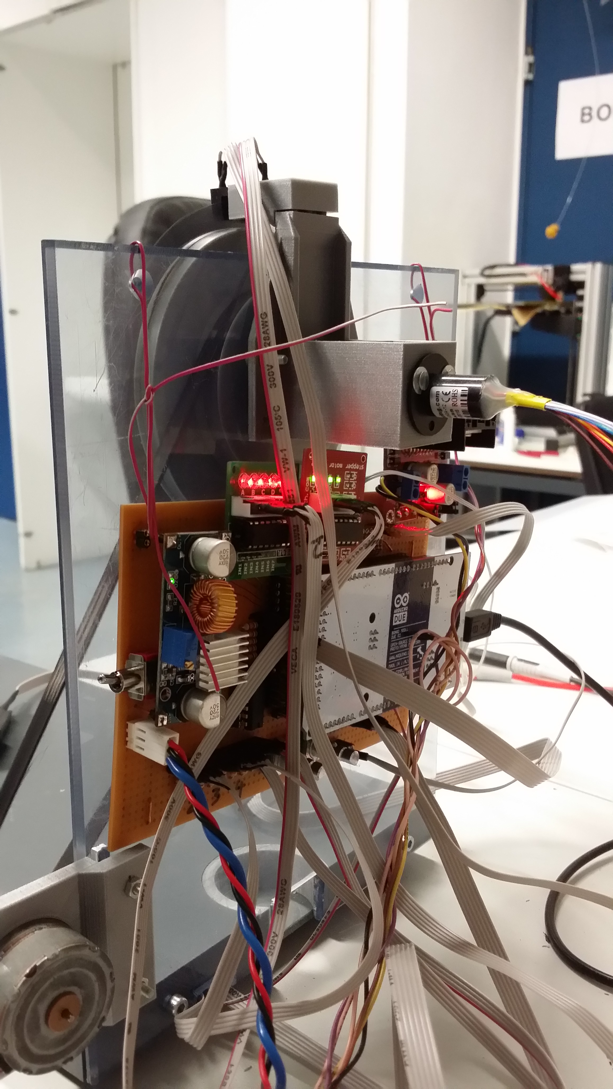
Doc/Bachelorarbeit10/img/Images/20170116_181659.jpg
