MrPerfekt/Maya/Doc/Bachelorarbeit10/img/Images/IMG_20160319_072830.jpg

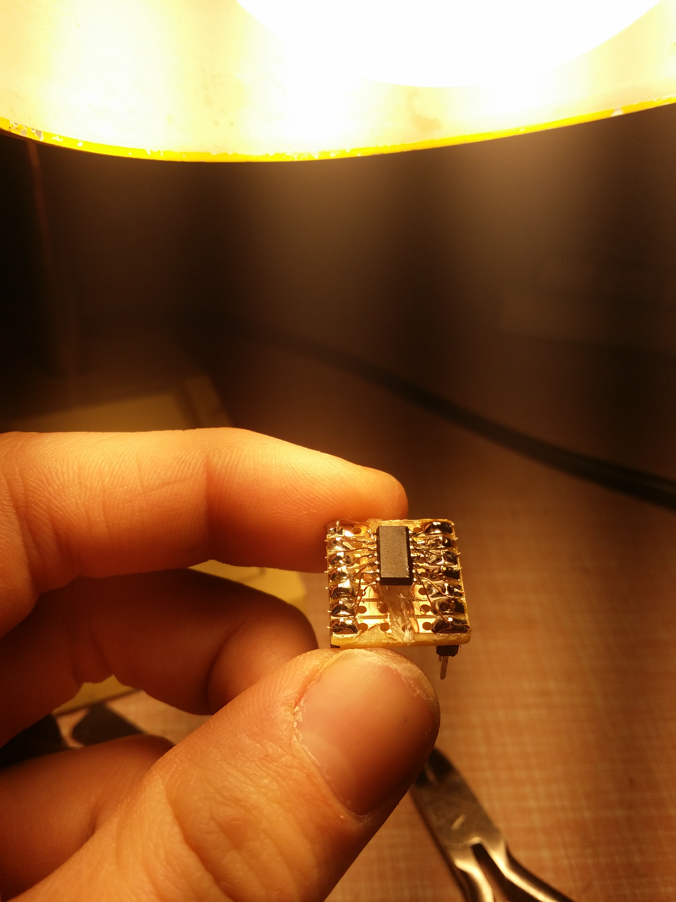
Doc/Bachelorarbeit10/img/Images/IMG_20160319_072830.jpg
