MrPerfekt/Maya/Doc/Bachelorarbeit10/img/PicturesPlots/Encoder/Normal/COPY/CONVERT/SCRN0116_Cutted.jpg

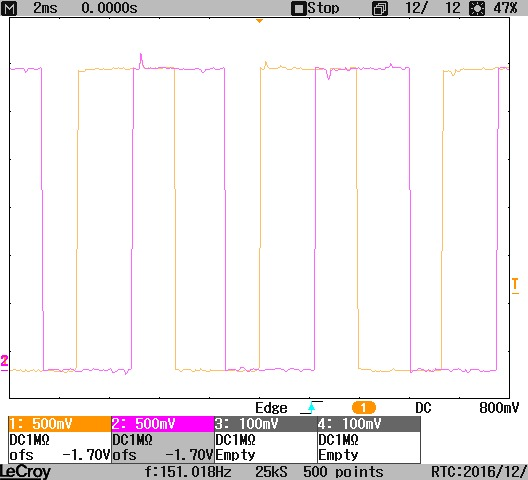
Doc/Bachelorarbeit10/img/PicturesPlots/Encoder/Normal/COPY/CONVERT/SCRN0116_Cutted.jpg
