MrPerfekt/Maya/Doc/Bachelorarbeit10/img/PicturesPlots/Encoder/Normal/COPY/CONVERT/SCRN0116_StrongCutted.jpg

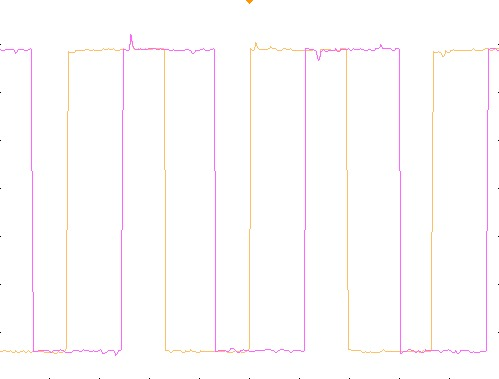
Doc/Bachelorarbeit10/img/PicturesPlots/Encoder/Normal/COPY/CONVERT/SCRN0116_StrongCutted.jpg
