MrPerfekt/Maya/Doc/Bachelorarbeit10/img/PicturesPlots/Encoder/Normal/COPY/CONVERT/SCRN0117_StrongCutted.jpg

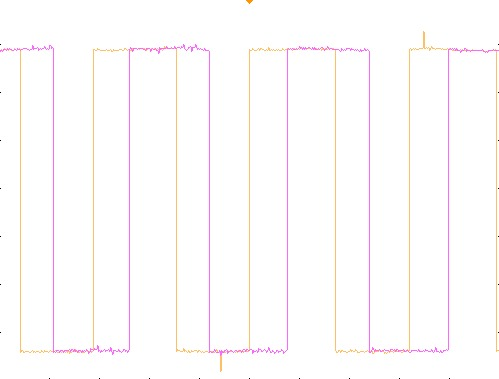
Doc/Bachelorarbeit10/img/PicturesPlots/Encoder/Normal/COPY/CONVERT/SCRN0117_StrongCutted.jpg
