MrPerfekt/Maya/Doc/Bachelorarbeit10/img/PicturesPlots/Encoder/Normal/COPY/CONVERT/SCRN0119_Cutted.jpg

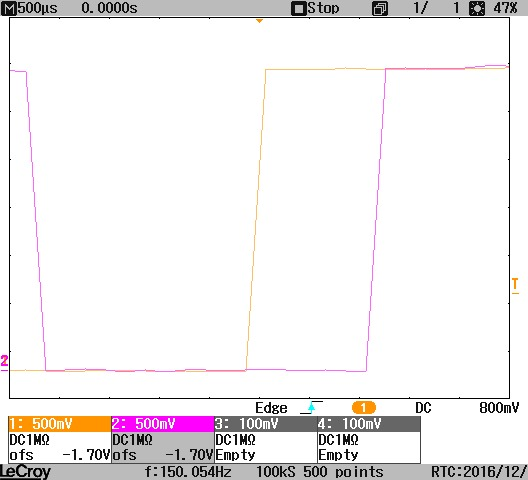
Doc/Bachelorarbeit10/img/PicturesPlots/Encoder/Normal/COPY/CONVERT/SCRN0119_Cutted.jpg
