MrPerfekt/Maya/Doc/Bachelorarbeit10/img/PicturesPlots/Encoder/Normal/COPY/SCRN0116.BMP

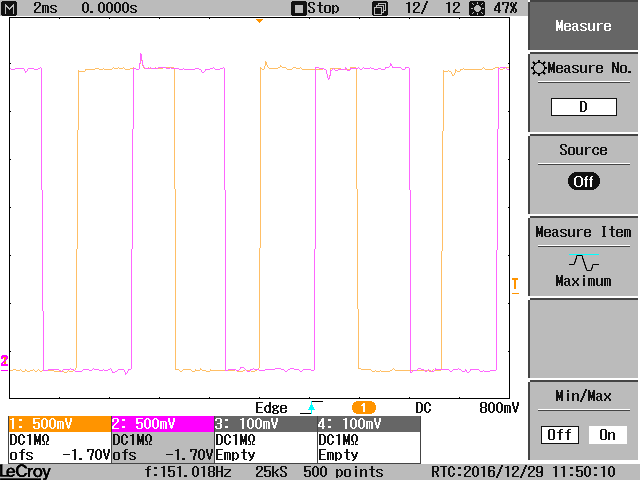
Doc/Bachelorarbeit10/img/PicturesPlots/Encoder/Normal/COPY/SCRN0116.BMP
