MrPerfekt/Maya/Doc/Bachelorarbeit10/img/PicturesPlots/Encoder/Normal/COPY/SCRN0118.BMP

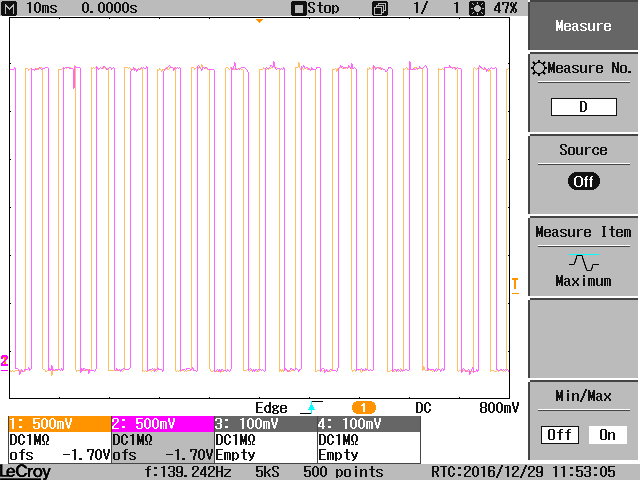
Doc/Bachelorarbeit10/img/PicturesPlots/Encoder/Normal/COPY/SCRN0118.BMP
