MrPerfekt/Maya/Doc/Bachelorarbeit10/img/PicturesPlots/Encoder/Normal/COPY/SCRN0121.BMP

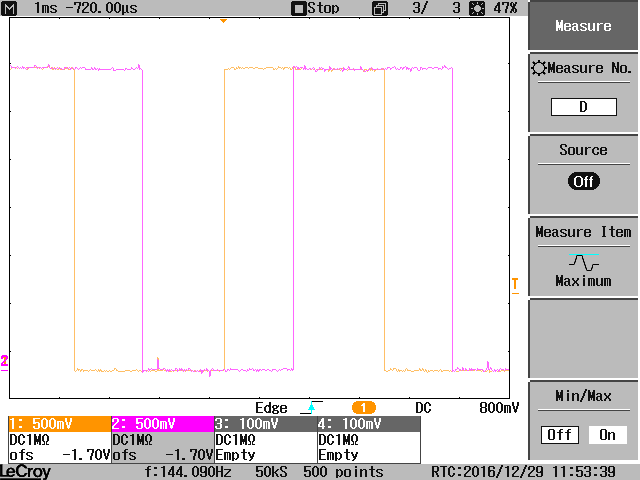
Doc/Bachelorarbeit10/img/PicturesPlots/Encoder/Normal/COPY/SCRN0121.BMP
