MrPerfekt/Maya/Doc/Bachelorarbeit10/img/PicturesPlots/Fotodiodes/LaserMaximal/Fallend/COPY/CONVERT/SCRN0142_StrongCutted.jpg

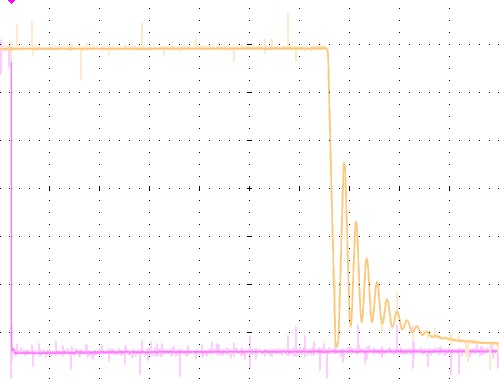
Doc/Bachelorarbeit10/img/PicturesPlots/Fotodiodes/LaserMaximal/Fallend/COPY/CONVERT/SCRN0142_StrongCutted.jpg
