MrPerfekt/Maya/Doc/Bachelorarbeit10/img/PicturesPlots/Fotodiodes/LaserMaximal/Fallend/COPY/CONVERT/SCRN0143_Cutted.jpg

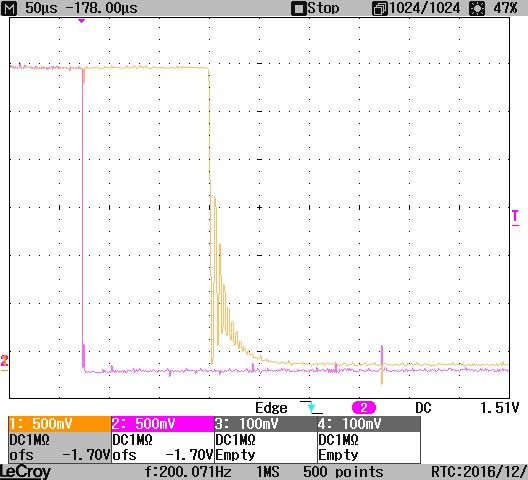
Doc/Bachelorarbeit10/img/PicturesPlots/Fotodiodes/LaserMaximal/Fallend/COPY/CONVERT/SCRN0143_Cutted.jpg
