MrPerfekt/Maya/Doc/Bachelorarbeit10/img/PicturesPlots/Fotodiodes/LaserMaximal/Fallend/WrongSettings/COPY/CONVERT/SCRN0092_Cutted.jpg

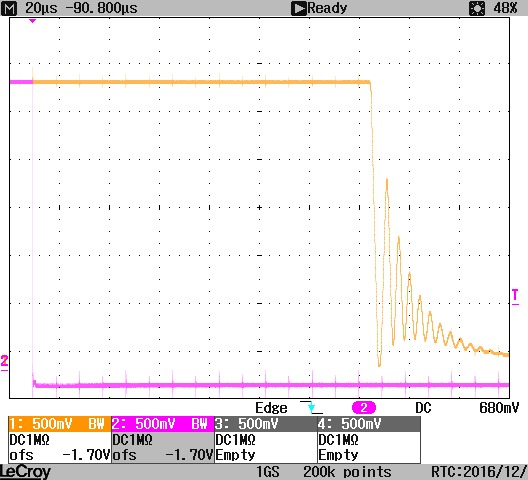
Doc/Bachelorarbeit10/img/PicturesPlots/Fotodiodes/LaserMaximal/Fallend/WrongSettings/COPY/CONVERT/SCRN0092_Cutted.jpg
