MrPerfekt/Maya/Doc/Bachelorarbeit10/img/PicturesPlots/Fotodiodes/LaserMaximal/Fallend/WrongSettings/COPY/CONVERT/SCRN0092_StrongCutted.jpg

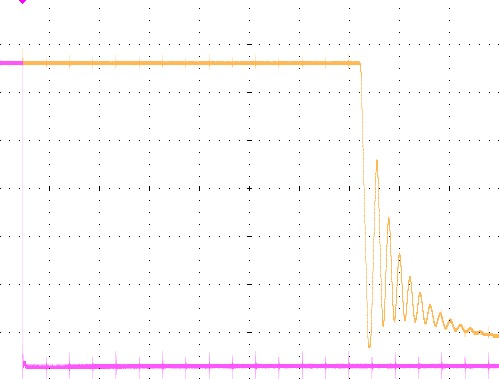
Doc/Bachelorarbeit10/img/PicturesPlots/Fotodiodes/LaserMaximal/Fallend/WrongSettings/COPY/CONVERT/SCRN0092_StrongCutted.jpg
