MrPerfekt/Maya/Doc/Bachelorarbeit10/img/PicturesPlots/Fotodiodes/LaserMaximal/Fallend/WrongSettings/COPY/CONVERT/SCRN0093_Cutted.jpg

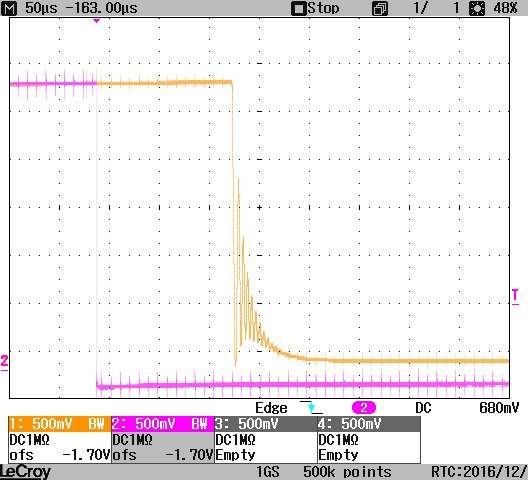
Doc/Bachelorarbeit10/img/PicturesPlots/Fotodiodes/LaserMaximal/Fallend/WrongSettings/COPY/CONVERT/SCRN0093_Cutted.jpg
