MrPerfekt/Maya/Doc/Bachelorarbeit10/img/PicturesPlots/Fotodiodes/LaserMaximal/Uebersicht/COPY/CONVERT/SCRN0141_Cutted.jpg

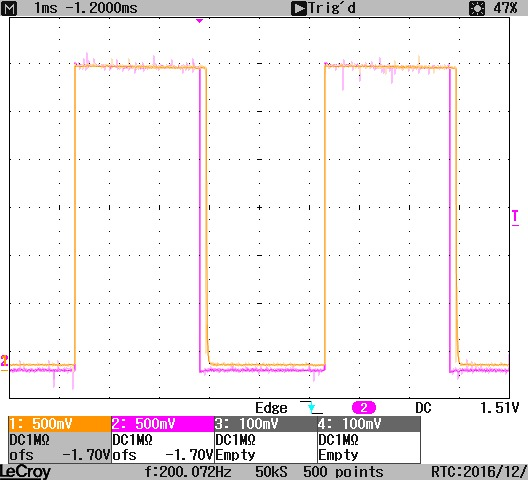
Doc/Bachelorarbeit10/img/PicturesPlots/Fotodiodes/LaserMaximal/Uebersicht/COPY/CONVERT/SCRN0141_Cutted.jpg
