MrPerfekt/Maya/Doc/Bachelorarbeit10/img/PicturesPlots/Fotodiodes/LaserMaximal/Uebersicht/COPY/CONVERT/SCRN0141_StrongCutted.jpg

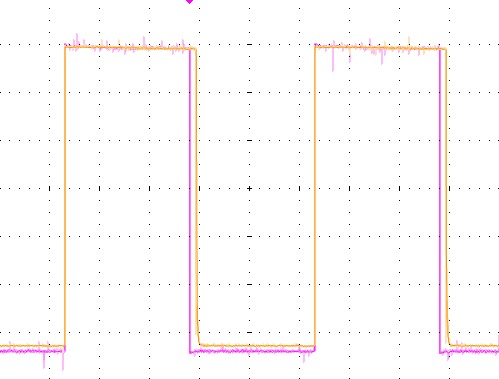
Doc/Bachelorarbeit10/img/PicturesPlots/Fotodiodes/LaserMaximal/Uebersicht/COPY/CONVERT/SCRN0141_StrongCutted.jpg
