MrPerfekt/Maya/Doc/Bachelorarbeit10/img/PicturesPlots/Fotodiodes/LaserMaximal/Uebersicht/COPY/SCRN0141.BMP

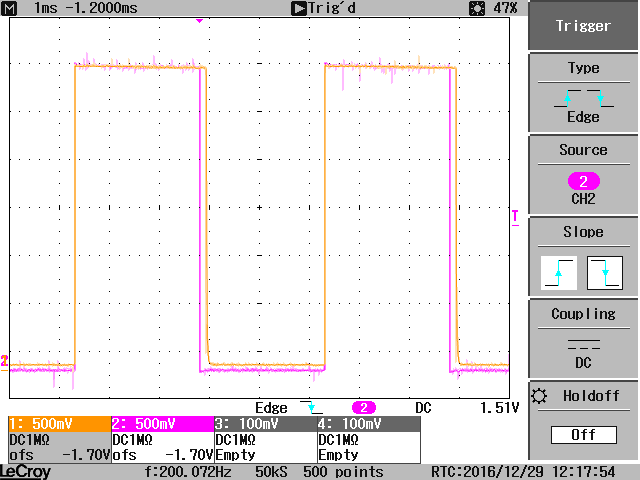
Doc/Bachelorarbeit10/img/PicturesPlots/Fotodiodes/LaserMaximal/Uebersicht/COPY/SCRN0141.BMP
