MrPerfekt/Maya/Doc/Bachelorarbeit10/img/PicturesPlots/Fotodiodes/LaserMaximal/Uebersicht/WrongSettings/COPY/CONVERT/SCRN0103_StrongCutted.jpg

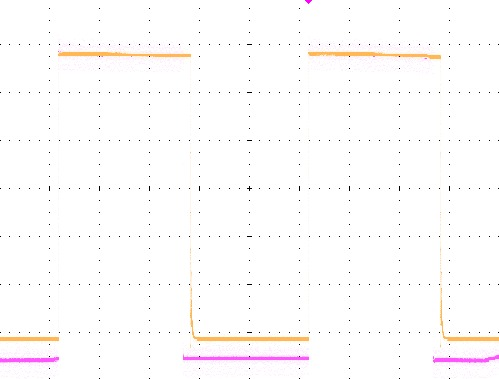
Doc/Bachelorarbeit10/img/PicturesPlots/Fotodiodes/LaserMaximal/Uebersicht/WrongSettings/COPY/CONVERT/SCRN0103_StrongCutted.jpg
