MrPerfekt/Maya/Doc/Bachelorarbeit10/img/PicturesPlots/Fotodiodes/LaserSchwach/Fallend/COPY/CONVERT/SCRN0134_Original.jpg

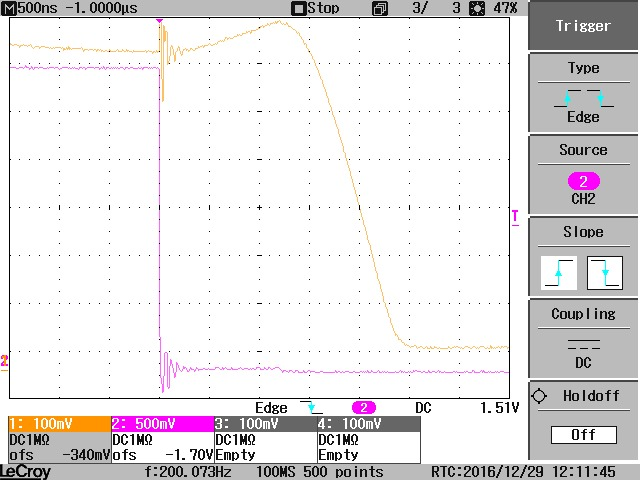
Doc/Bachelorarbeit10/img/PicturesPlots/Fotodiodes/LaserSchwach/Fallend/COPY/CONVERT/SCRN0134_Original.jpg
