MrPerfekt/Maya/Doc/Bachelorarbeit10/img/PicturesPlots/Fotodiodes/LaserSchwach/Fallend/COPY/SCRN0135.BMP

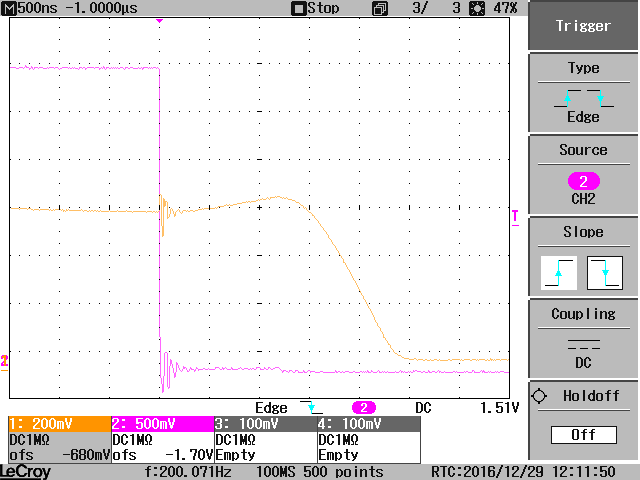
Doc/Bachelorarbeit10/img/PicturesPlots/Fotodiodes/LaserSchwach/Fallend/COPY/SCRN0135.BMP
