MrPerfekt/Maya/Doc/Bachelorarbeit10/img/PicturesPlots/Fotodiodes/LaserSchwach/Fallend/WrongSettings/COPY/CONVERT/SCRN0101_Cutted.jpg

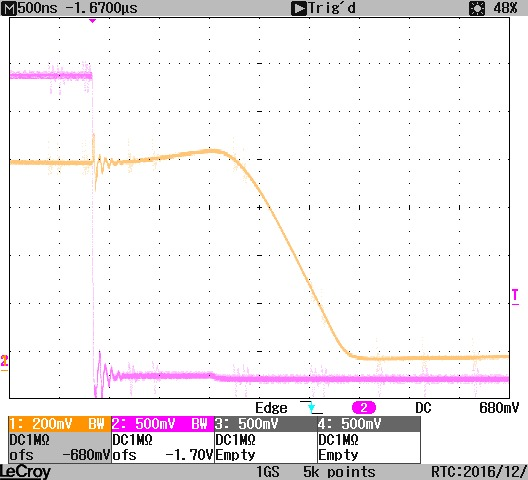
Doc/Bachelorarbeit10/img/PicturesPlots/Fotodiodes/LaserSchwach/Fallend/WrongSettings/COPY/CONVERT/SCRN0101_Cutted.jpg
