MrPerfekt/Maya/Doc/Bachelorarbeit10/img/PicturesPlots/Fotodiodes/LaserSchwach/Steigend/COPY/CONVERT/SCRN0130_Original.jpg

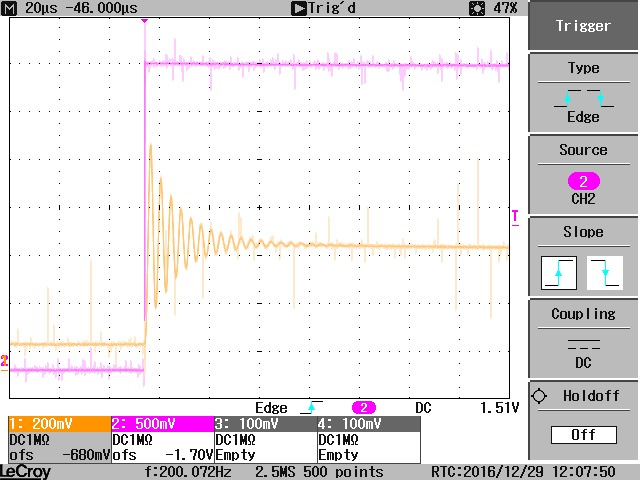
Doc/Bachelorarbeit10/img/PicturesPlots/Fotodiodes/LaserSchwach/Steigend/COPY/CONVERT/SCRN0130_Original.jpg
