MrPerfekt/Maya/Doc/Bachelorarbeit10/img/PicturesPlots/Fotodiodes/LaserSchwach/Steigend/COPY/CONVERT/SCRN0130_StrongCutted.jpg

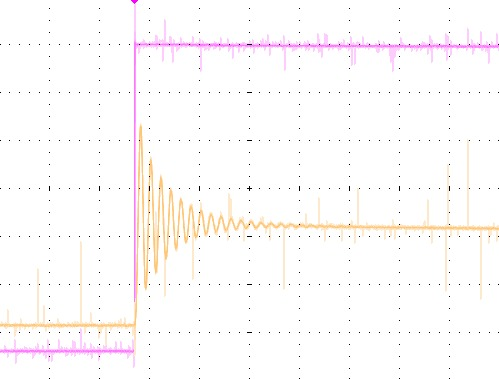
Doc/Bachelorarbeit10/img/PicturesPlots/Fotodiodes/LaserSchwach/Steigend/COPY/CONVERT/SCRN0130_StrongCutted.jpg
