MrPerfekt/Maya/Doc/Bachelorarbeit10/img/PicturesPlots/Fotodiodes/LaserSchwach/Steigend/WrongSettings00/COPY/CONVERT/SCRN0102_Original.jpg

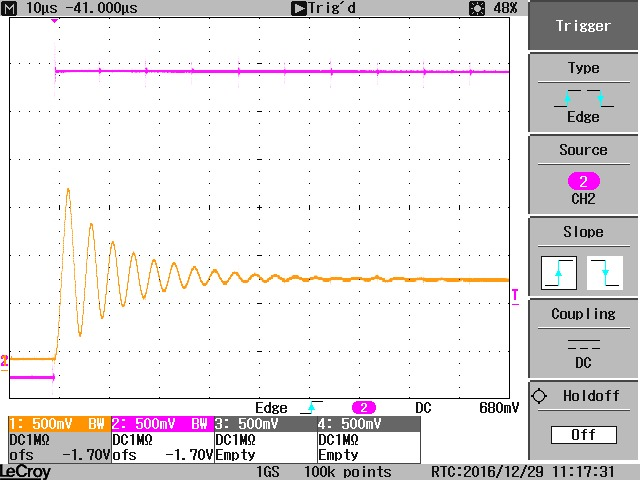
Doc/Bachelorarbeit10/img/PicturesPlots/Fotodiodes/LaserSchwach/Steigend/WrongSettings00/COPY/CONVERT/SCRN0102_Original.jpg
