MrPerfekt/Maya/Doc/Bachelorarbeit10/img/PicturesPlots/Fotodiodes/LaserSchwach/Steigend/WrongSettings00/COPY/CONVERT/SCRN0102_StrongCutted.jpg

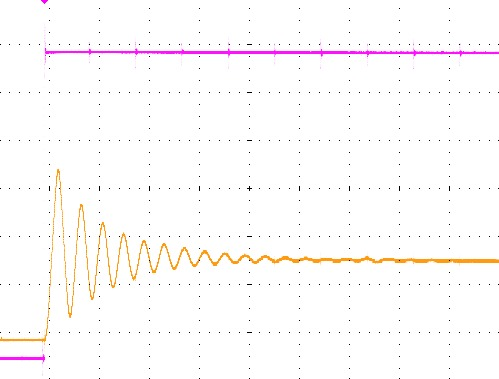
Doc/Bachelorarbeit10/img/PicturesPlots/Fotodiodes/LaserSchwach/Steigend/WrongSettings00/COPY/CONVERT/SCRN0102_StrongCutted.jpg
