MrPerfekt/Maya/Doc/Bachelorarbeit10/img/PicturesPlots/Fotodiodes/LaserSchwach/Steigend/WrongSettings01/COPY/CONVERT/SCRN0128_Cutted.jpg

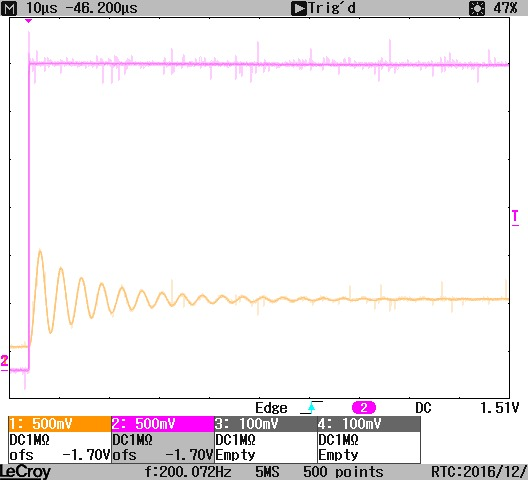
Doc/Bachelorarbeit10/img/PicturesPlots/Fotodiodes/LaserSchwach/Steigend/WrongSettings01/COPY/CONVERT/SCRN0128_Cutted.jpg
