MrPerfekt/Maya/Doc/Bachelorarbeit10/img/PicturesPlots/Fotodiodes/LaserSchwach/Uebersicht/COPY/CONVERT/SCRN0136_Original.jpg

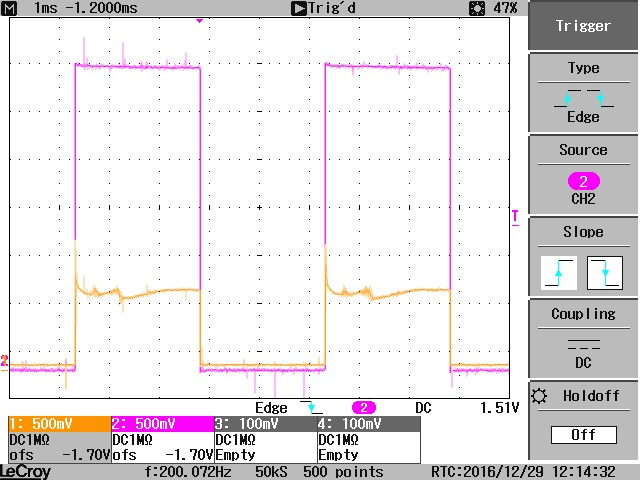
Doc/Bachelorarbeit10/img/PicturesPlots/Fotodiodes/LaserSchwach/Uebersicht/COPY/CONVERT/SCRN0136_Original.jpg
