MrPerfekt/Maya/Doc/Bachelorarbeit10/img/PicturesPlots/Fotodiodes/LaserSchwach/Uebersicht/COPY/CONVERT/SCRN0139_Cutted.jpg

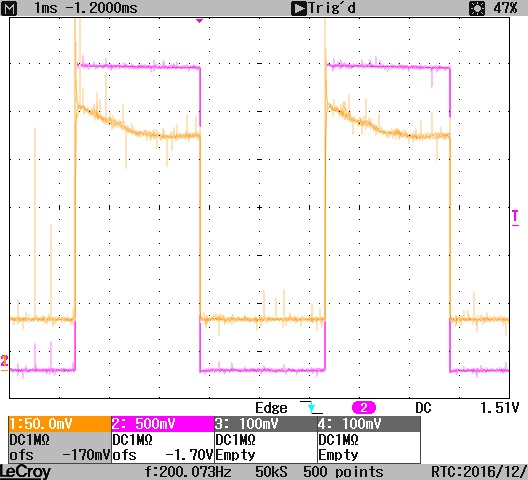
Doc/Bachelorarbeit10/img/PicturesPlots/Fotodiodes/LaserSchwach/Uebersicht/COPY/CONVERT/SCRN0139_Cutted.jpg
