MrPerfekt/Maya/Doc/Bachelorarbeit10/img/PicturesPlots/Fotodiodes/LaserSchwach/Uebersicht/WrongSettings/COPY/CONVERT/SCRN0100_Cutted.jpg

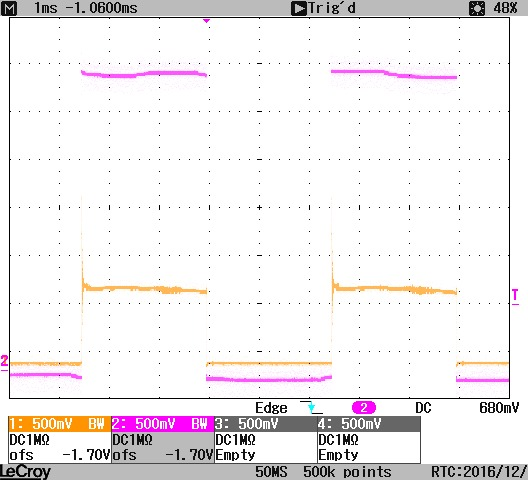
Doc/Bachelorarbeit10/img/PicturesPlots/Fotodiodes/LaserSchwach/Uebersicht/WrongSettings/COPY/CONVERT/SCRN0100_Cutted.jpg
