MrPerfekt/Maya/Doc/Bachelorarbeit10/img/PicturesPlots/Fotodiodes/LaserSchwach/Uebersicht/WrongSettings/COPY/CONVERT/SCRN0100_Original.jpg

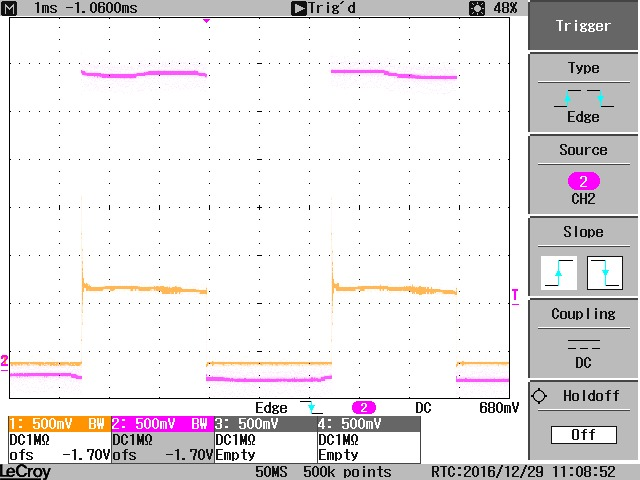
Doc/Bachelorarbeit10/img/PicturesPlots/Fotodiodes/LaserSchwach/Uebersicht/WrongSettings/COPY/CONVERT/SCRN0100_Original.jpg
