MrPerfekt/Maya/Doc/Bachelorarbeit10/img/PicturesPlots/Fotodiodes/LaserSchwach/Uebersicht/WrongSettings/COPY/CONVERT/SCRN0100_StrongCutted.jpg

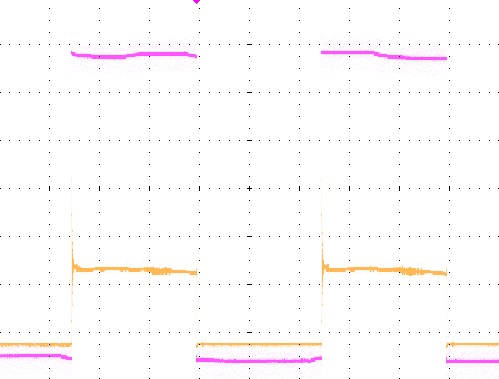
Doc/Bachelorarbeit10/img/PicturesPlots/Fotodiodes/LaserSchwach/Uebersicht/WrongSettings/COPY/CONVERT/SCRN0100_StrongCutted.jpg
