MrPerfekt/Maya/Doc/Bachelorarbeit10/img/PicturesPlots/Regler/COPY/CONVERT/SCRN0104_Cutted.jpg

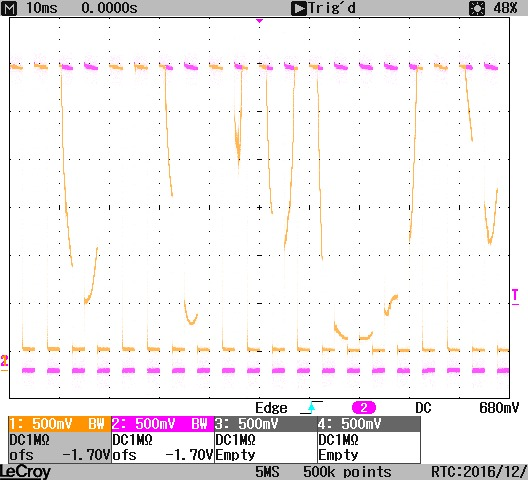
Doc/Bachelorarbeit10/img/PicturesPlots/Regler/COPY/CONVERT/SCRN0104_Cutted.jpg
