MrPerfekt/Maya/Doc/Bachelorarbeit10/img/PicturesPlots/Regler/COPY/SCRN0104.BMP

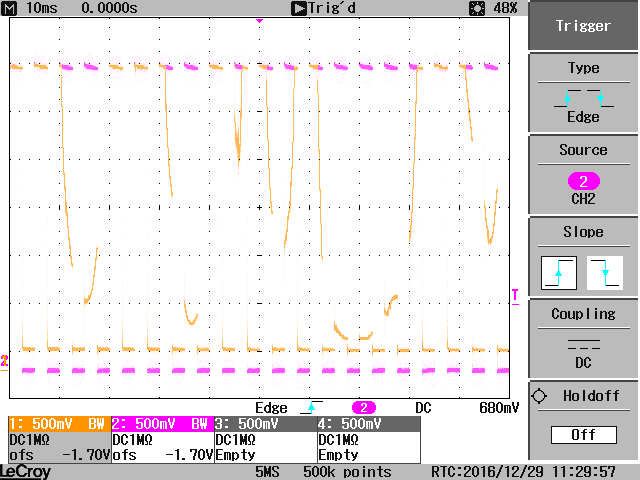
Doc/Bachelorarbeit10/img/PicturesPlots/Regler/COPY/SCRN0104.BMP
