MrPerfekt/Maya/Doc/Bachelorarbeit10/img/PicturesPlots/SchmittTrigger/COPY/CONVERT/SCRN0122_StrongCutted.jpg

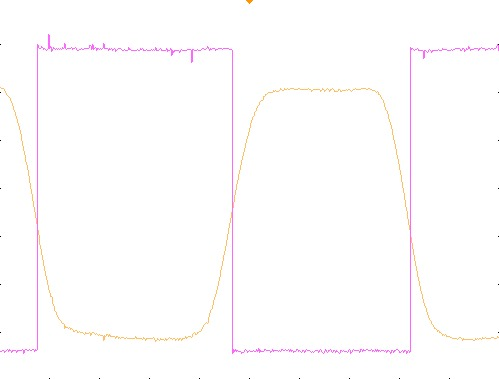
Doc/Bachelorarbeit10/img/PicturesPlots/SchmittTrigger/COPY/CONVERT/SCRN0122_StrongCutted.jpg
