MrPerfekt/Maya/Doc/Bachelorarbeit10/img/PicturesPlots/SchmittTrigger/COPY/SCRN0126.BMP

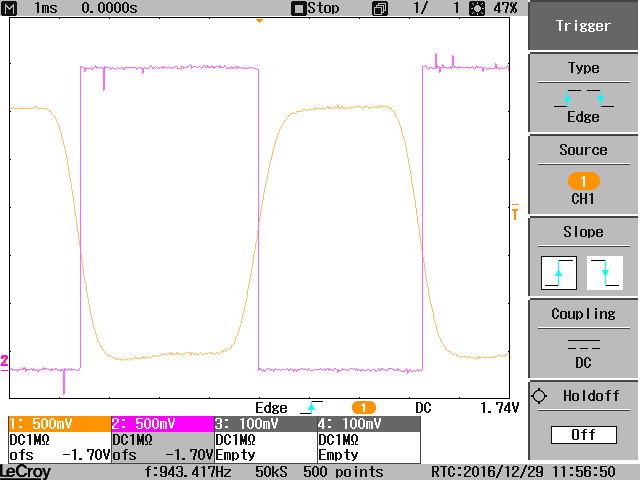
Doc/Bachelorarbeit10/img/PicturesPlots/SchmittTrigger/COPY/SCRN0126.BMP
