MrPerfekt/Maya/Doc/Bachelorarbeit10/img/PicturesPlots/SchmittTrigger/WrongSettings/COPY/CONVERT/SCRN0106_Original.jpg

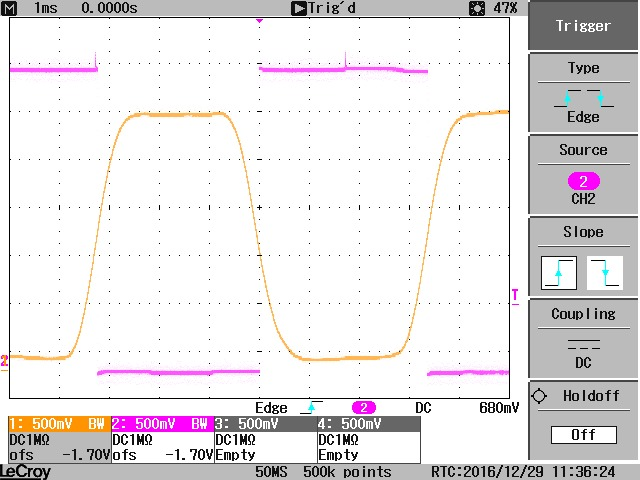
Doc/Bachelorarbeit10/img/PicturesPlots/SchmittTrigger/WrongSettings/COPY/CONVERT/SCRN0106_Original.jpg
