MrPerfekt/Maya/Doc/Bachelorarbeit10/img/PicturesPlots/SchmittTrigger/WrongSettings/COPY/CONVERT/SCRN0106_StrongCutted.jpg

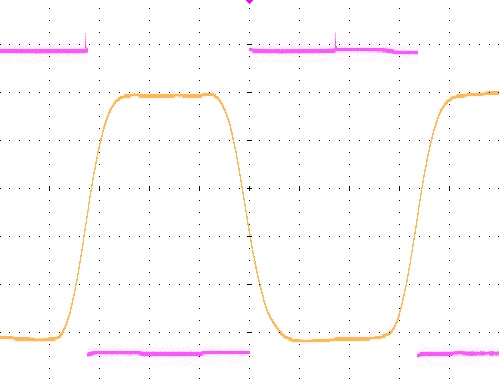
Doc/Bachelorarbeit10/img/PicturesPlots/SchmittTrigger/WrongSettings/COPY/CONVERT/SCRN0106_StrongCutted.jpg
