MrPerfekt/Maya/Doc/Bachelorarbeit10/img/PicturesPlots/SchmittTrigger/WrongSettings/COPY/CONVERT/SCRN0107_Original.jpg

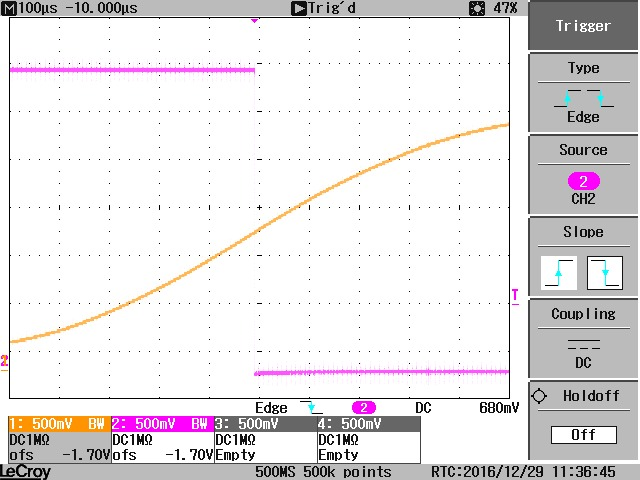
Doc/Bachelorarbeit10/img/PicturesPlots/SchmittTrigger/WrongSettings/COPY/CONVERT/SCRN0107_Original.jpg
