MrPerfekt/Maya/Doc/Bachelorarbeit10/img/PicturesPlots/Schrittmotor/Ansteuerung/COPY/CONVERT/SCRN0145_Original.jpg

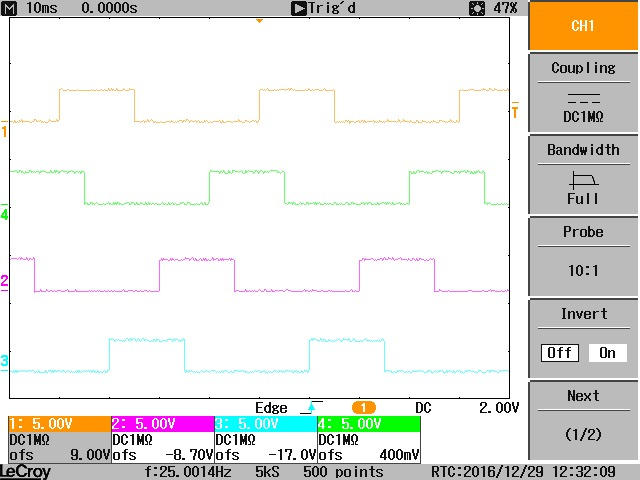
Doc/Bachelorarbeit10/img/PicturesPlots/Schrittmotor/Ansteuerung/COPY/CONVERT/SCRN0145_Original.jpg
