MrPerfekt/Maya/Doc/Bachelorarbeit10/img/PicturesPlots/Schrittmotor/Ansteuerung/COPY/CONVERT/SCRN0147_StrongCutted.jpg

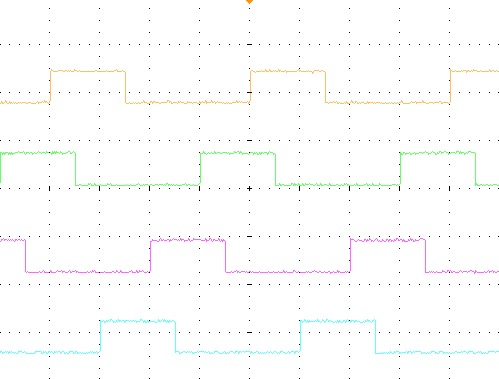
Doc/Bachelorarbeit10/img/PicturesPlots/Schrittmotor/Ansteuerung/COPY/CONVERT/SCRN0147_StrongCutted.jpg
