MrPerfekt/Maya/Doc/Bachelorarbeit10/img/PicturesPlots/Schrittmotor/Ansteuerung/COPY/CONVERT/SCRN0148_Cutted.jpg

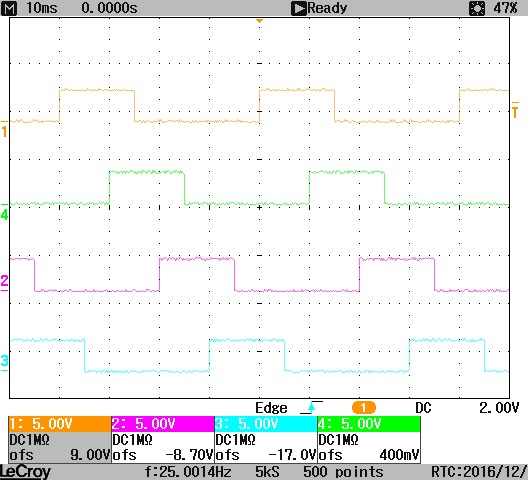
Doc/Bachelorarbeit10/img/PicturesPlots/Schrittmotor/Ansteuerung/COPY/CONVERT/SCRN0148_Cutted.jpg
