MrPerfekt/Maya/Doc/Bachelorarbeit10/img/PicturesPlots/Schrittmotor/Treiber/COPY/CONVERT/SCRN0150_Original.jpg

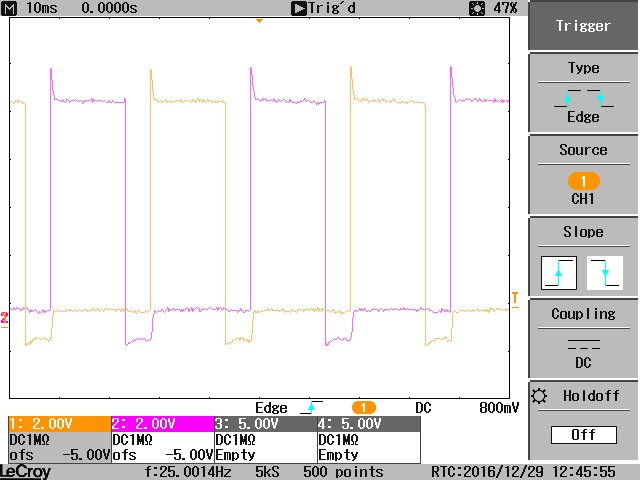
Doc/Bachelorarbeit10/img/PicturesPlots/Schrittmotor/Treiber/COPY/CONVERT/SCRN0150_Original.jpg
