MrPerfekt/Maya/Doc/Bachelorarbeit10/img/PicturesPlots/Timing/DiodesLaser/COPY/CONVERT/SCRN0160_Original.jpg

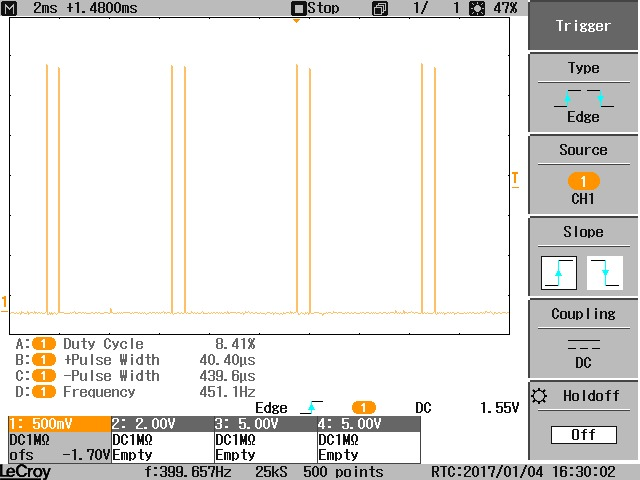
Doc/Bachelorarbeit10/img/PicturesPlots/Timing/DiodesLaser/COPY/CONVERT/SCRN0160_Original.jpg
