MrPerfekt/Maya/Doc/Bachelorarbeit10/img/PicturesPlots/Timing/DiodesLaser/COPY/CONVERT/SCRN0161_Original.jpg

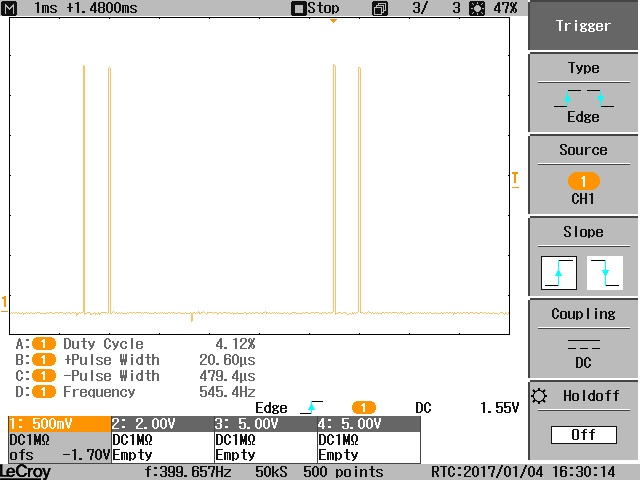
Doc/Bachelorarbeit10/img/PicturesPlots/Timing/DiodesLaser/COPY/CONVERT/SCRN0161_Original.jpg
