MrPerfekt/Maya/Doc/Bachelorarbeit10/img/PicturesPlots/Timing/DiodesLaser/COPY/CONVERT/SCRN0162_Cutted.jpg

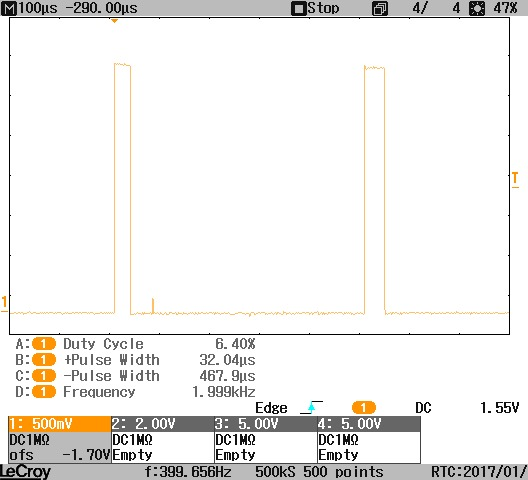
Doc/Bachelorarbeit10/img/PicturesPlots/Timing/DiodesLaser/COPY/CONVERT/SCRN0162_Cutted.jpg
