MrPerfekt/Maya/Doc/Bachelorarbeit10/img/PicturesPlots/Timing/StepperDisc/COPY/CONVERT/SCRN0157_Original.jpg

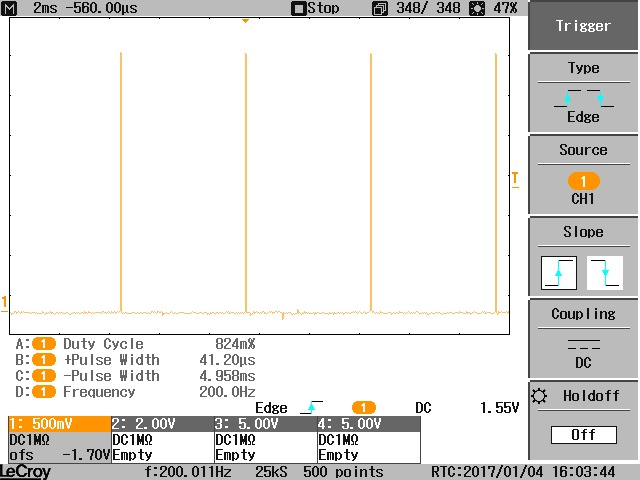
Doc/Bachelorarbeit10/img/PicturesPlots/Timing/StepperDisc/COPY/CONVERT/SCRN0157_Original.jpg
