MrPerfekt/Maya/Doc/Bachelorarbeit10/img/PicturesPlots/Timing/StepperDisc/COPY/CONVERT/SCRN0158_Original.jpg

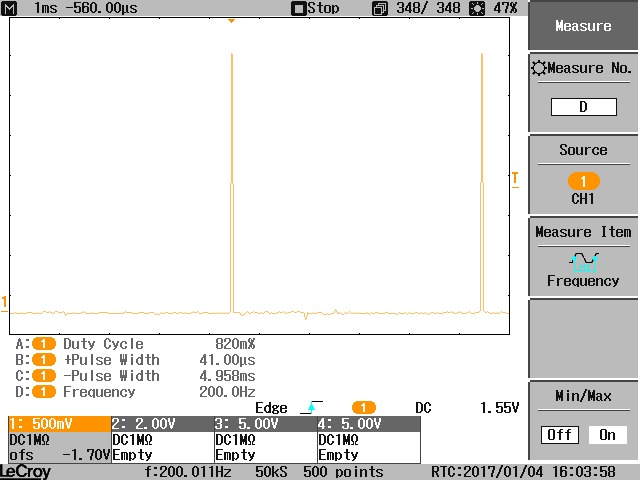
Doc/Bachelorarbeit10/img/PicturesPlots/Timing/StepperDisc/COPY/CONVERT/SCRN0158_Original.jpg
