MrPerfekt/Maya/Doc/Bachelorarbeit10/img/PicturesPlots/Timing/StepperDisc/COPY/CONVERT/SCRN0158_StrongCutted.jpg

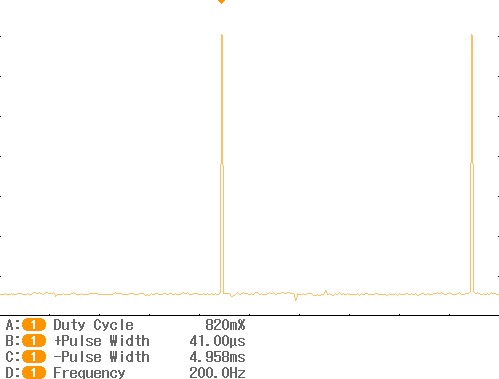
Doc/Bachelorarbeit10/img/PicturesPlots/Timing/StepperDisc/COPY/CONVERT/SCRN0158_StrongCutted.jpg
