MrPerfekt/Maya/Doc/Bachelorarbeit10/img/PicturesPlots/Timing/StepperLaserPositioner/COPY/CONVERT/SCRN0151_Original.jpg

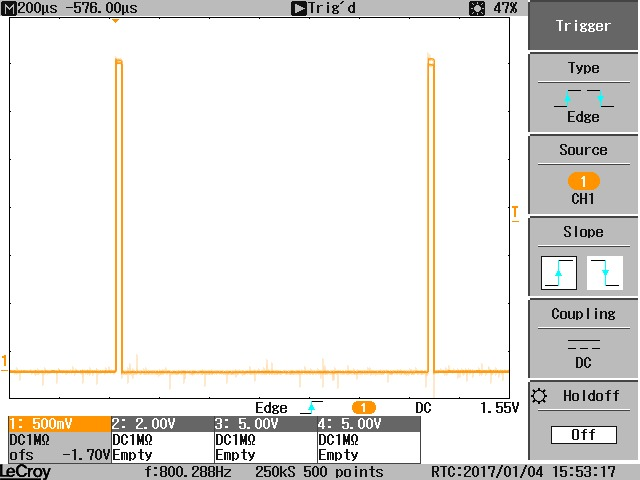
Doc/Bachelorarbeit10/img/PicturesPlots/Timing/StepperLaserPositioner/COPY/CONVERT/SCRN0151_Original.jpg
