MrPerfekt/Maya/Doc/Bachelorarbeit10/img/PicturesPlots/Timing/StepperLaserPositioner/COPY/CONVERT/SCRN0152_Cutted.jpg

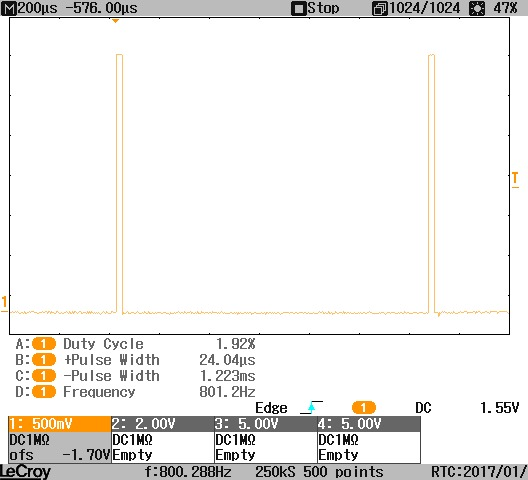
Doc/Bachelorarbeit10/img/PicturesPlots/Timing/StepperLaserPositioner/COPY/CONVERT/SCRN0152_Cutted.jpg
