MrPerfekt/Maya/Doc/Bachelorarbeit10/img/Sketchup/DiscBig01.PNG

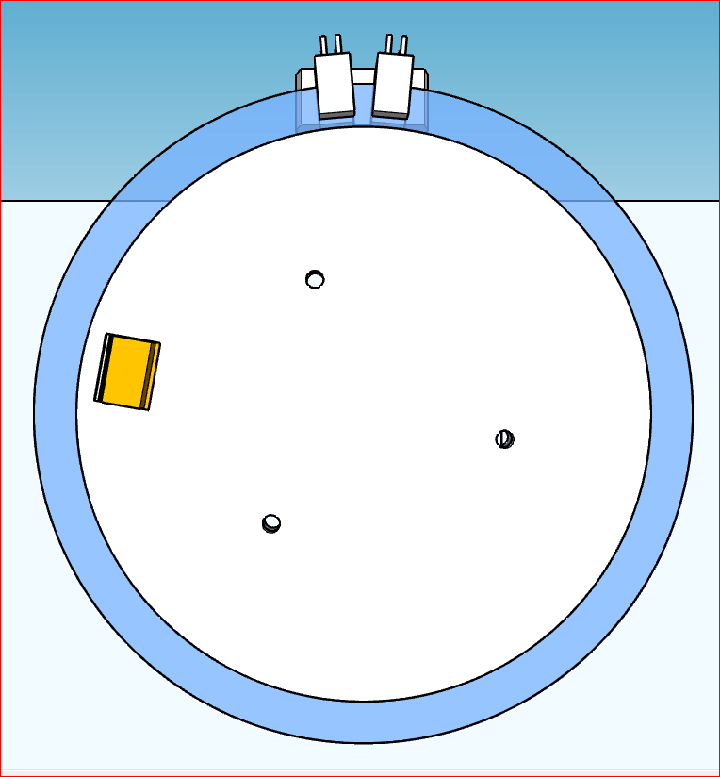
Doc/Bachelorarbeit10/img/Sketchup/DiscBig01.PNG
