MrPerfekt/Maya/Doc/Bachelorarbeit10/img/Sketchup/DiscBig02.PNG

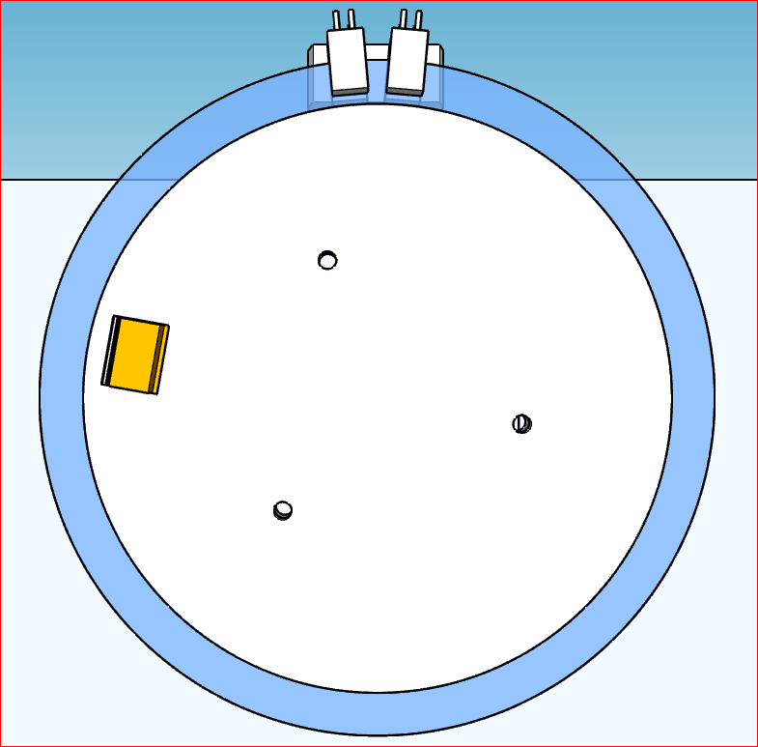
Doc/Bachelorarbeit10/img/Sketchup/DiscBig02.PNG
