MrPerfekt/Maya/Doc/Bachelorarbeit10/img/Sketchup/DiscBig04.PNG

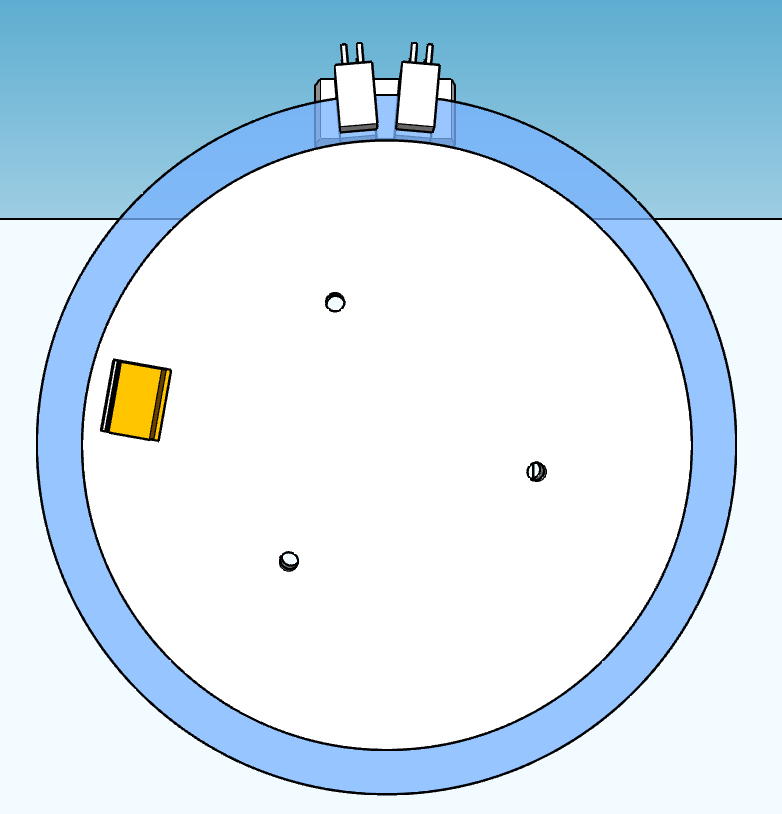
Doc/Bachelorarbeit10/img/Sketchup/DiscBig04.PNG
