MrPerfekt/Maya/Doc/Bachelorarbeit10/img/Sketchup/Lasercontroll02.PNG

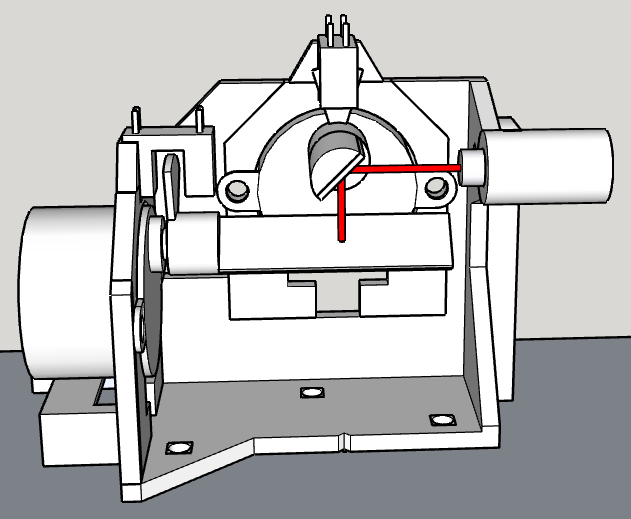
Doc/Bachelorarbeit10/img/Sketchup/Lasercontroll02.PNG
