MrPerfekt/Maya/Doc/Bachelorarbeit10/img/Sketchup/Pendel00.PNG

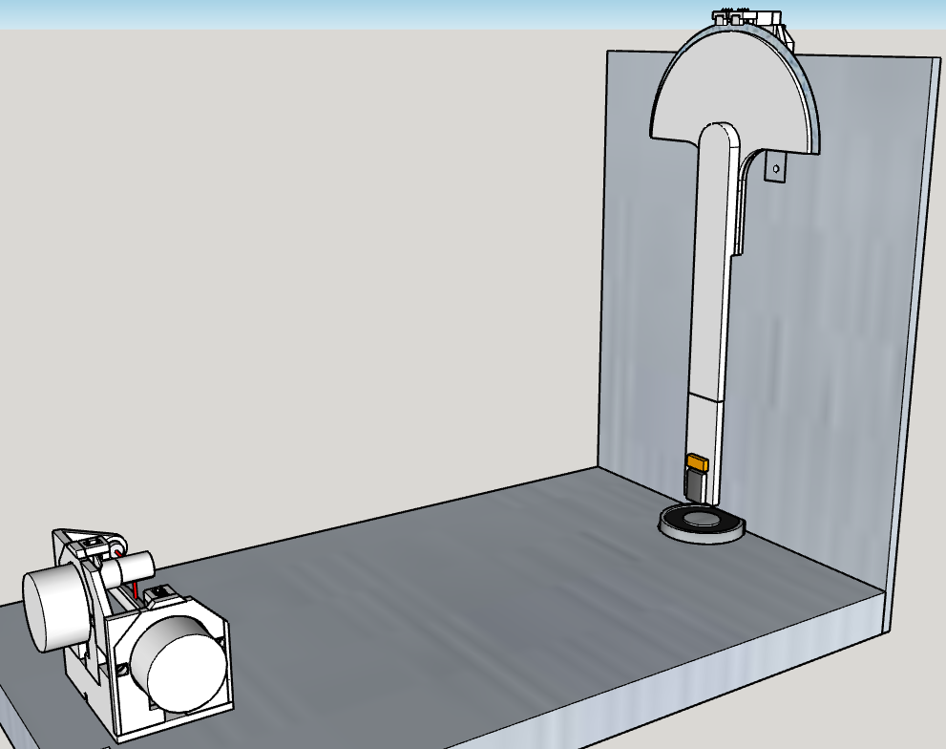
Doc/Bachelorarbeit10/img/Sketchup/Pendel00.PNG
