MrPerfekt/Maya/Doc/Bachelorarbeit10/img/Sketchup/Pendel01.PNG

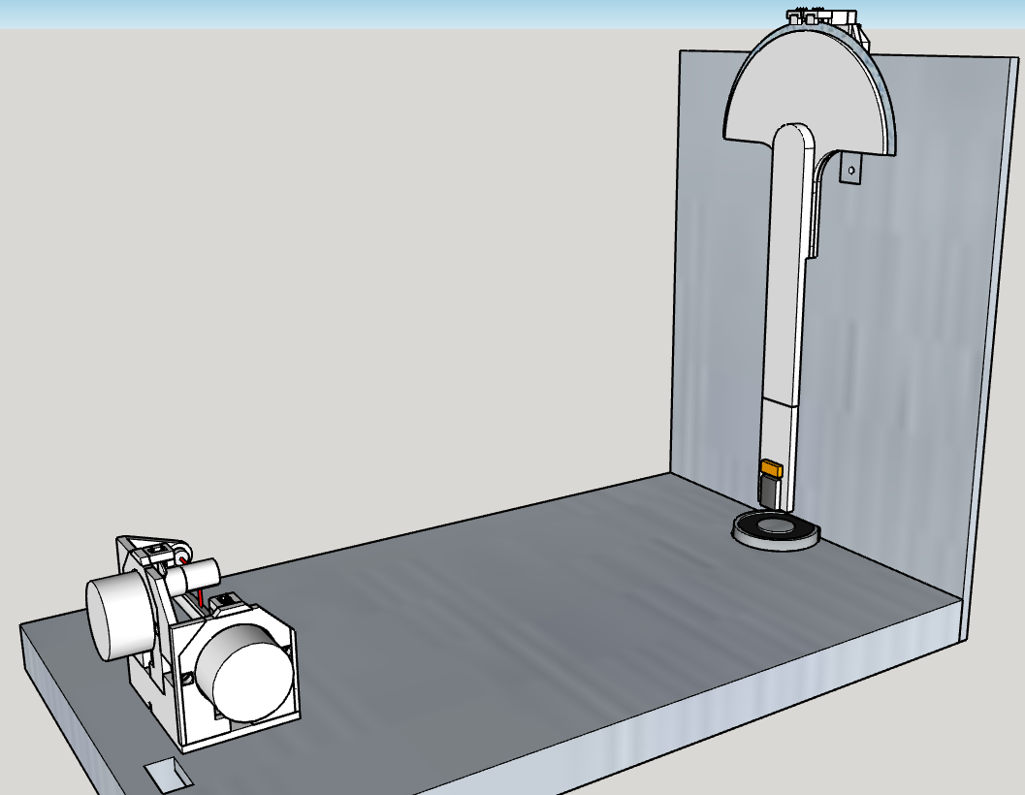
Doc/Bachelorarbeit10/img/Sketchup/Pendel01.PNG
