MrPerfekt/Maya/Doc/Bachelorarbeit10/img/Sketchup/Pendel02.PNG

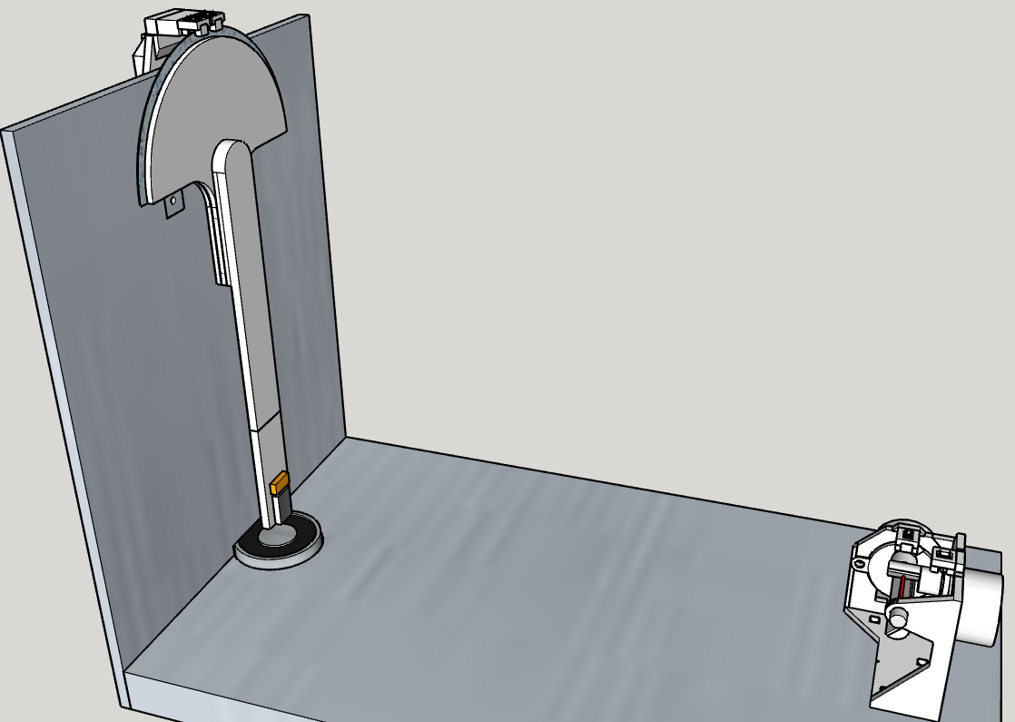
Doc/Bachelorarbeit10/img/Sketchup/Pendel02.PNG
