MrPerfekt/Maya/Doc/Bachelorarbeit10/img/Wikipedia/TIA01.png

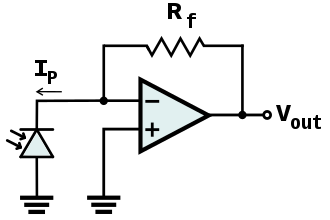
Doc/Bachelorarbeit10/img/Wikipedia/TIA01.png
