MrPerfekt/Maya/Doc/Bachelorarbeit10/img/Wikipedia/Transimpedanzverstaerker.jpg

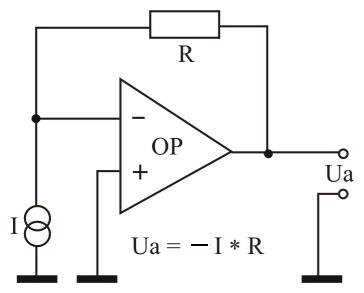
Doc/Bachelorarbeit10/img/Wikipedia/Transimpedanzverstaerker.jpg
