MrPerfekt/Maya/Doc/Folien/Disc01.PNG

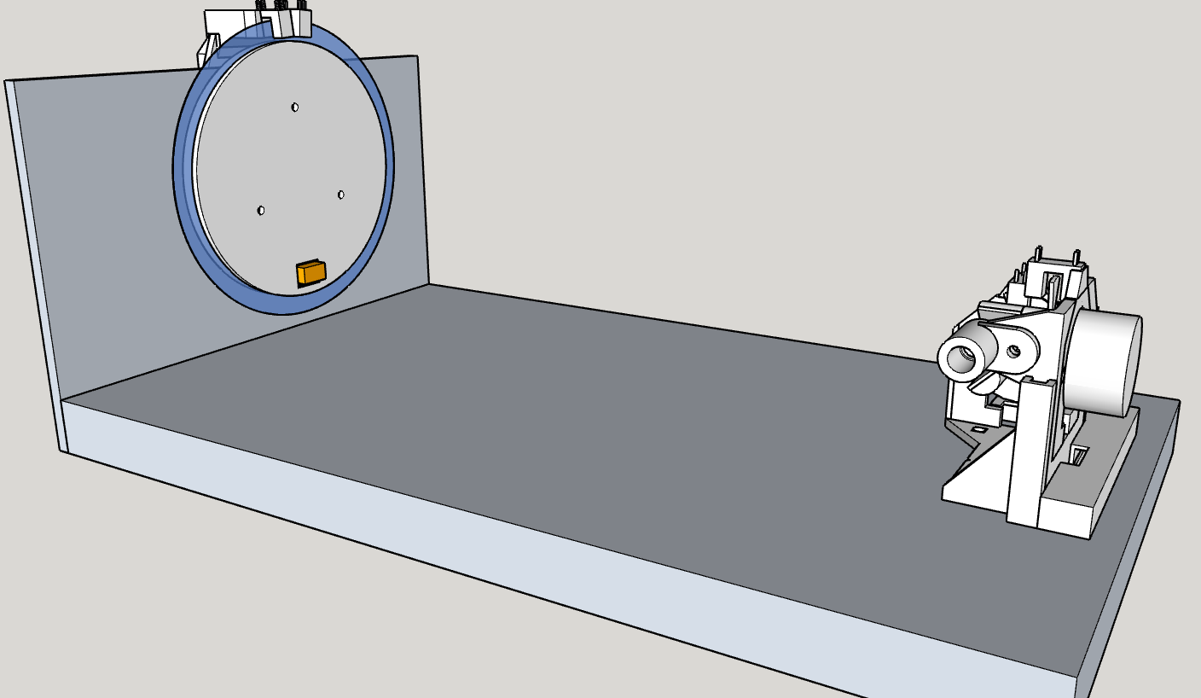
Doc/Folien/Disc01.PNG
