MrPerfekt/Maya/Doc/Folien/Disc02.PNG

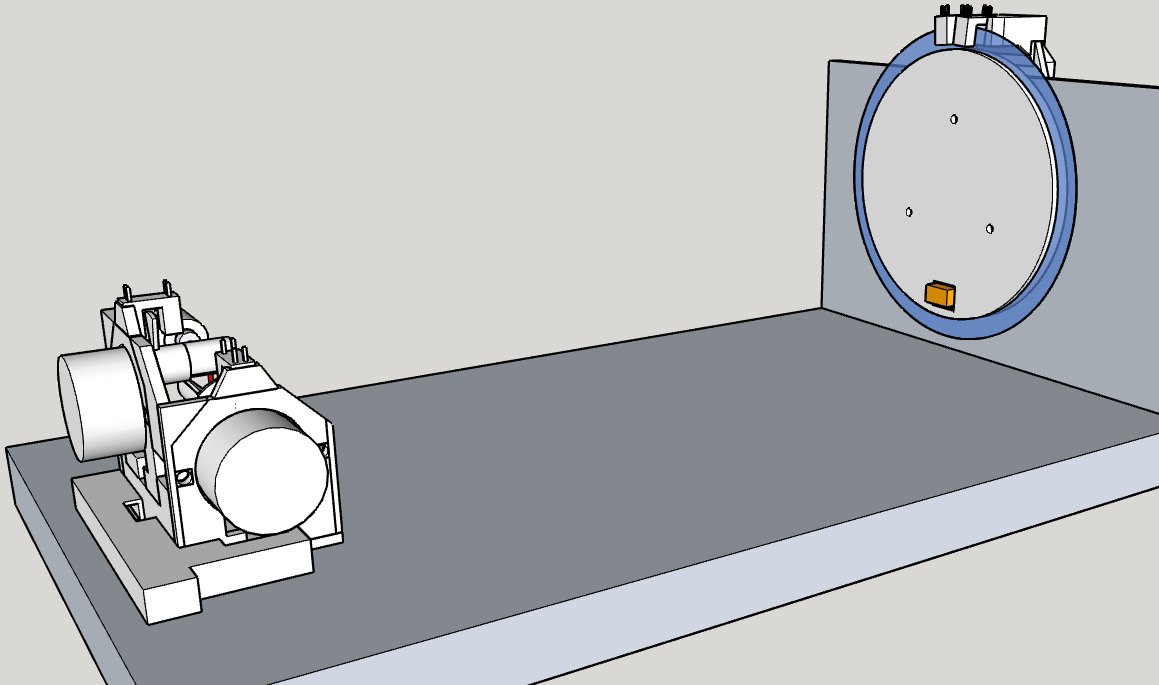
Doc/Folien/Disc02.PNG
