MrPerfekt/Maya/Doc/Folien/DiscBig00.PNG

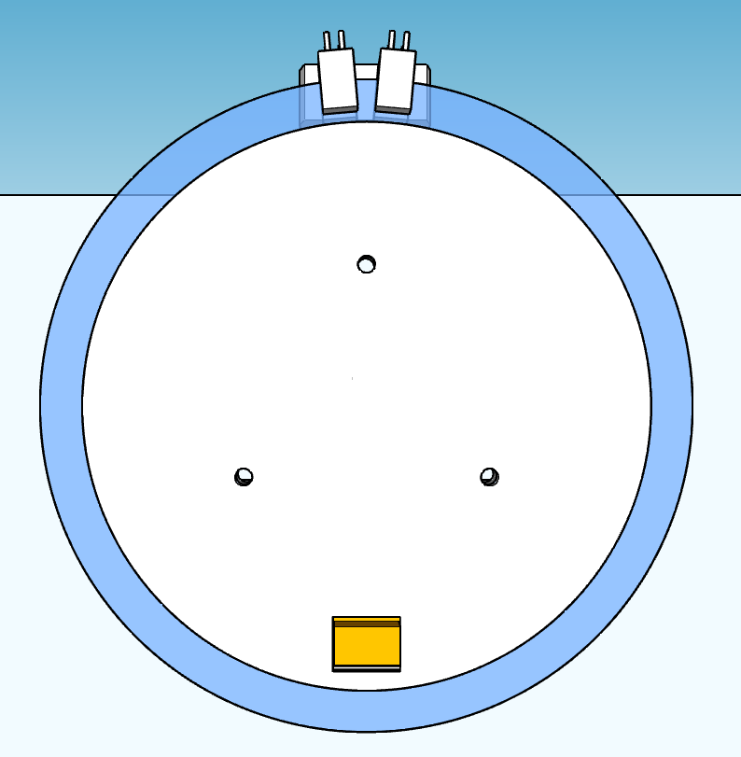
Doc/Folien/DiscBig00.PNG
