MrPerfekt/Maya/Doc/Folien/DiscBig03.PNG

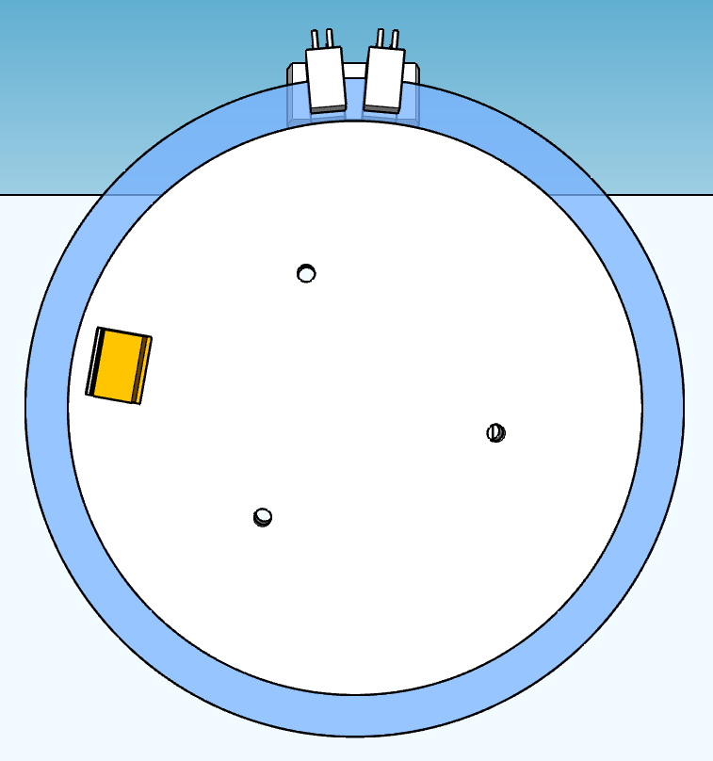
Doc/Folien/DiscBig03.PNG
