MrPerfekt/Maya/Doc/Folien/FotodiodesMeshPlotAddControllerStandalone.png

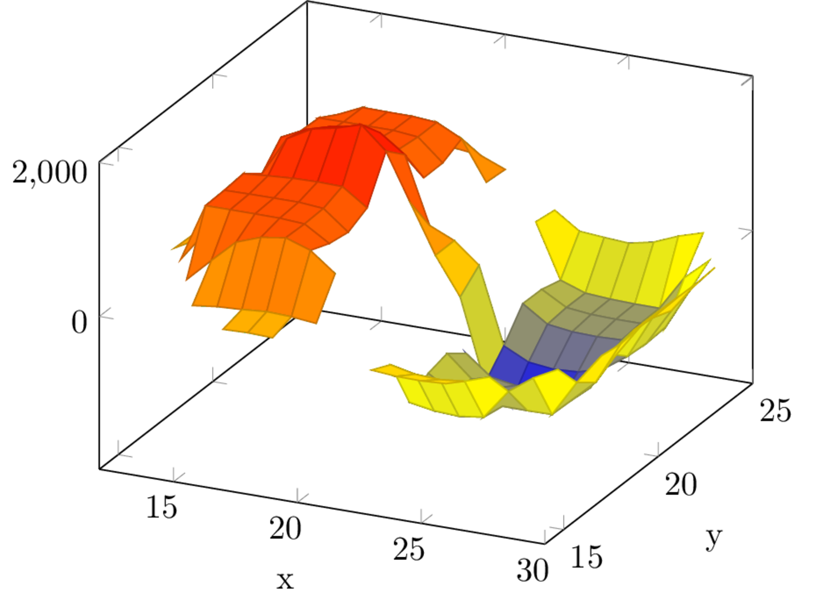
Doc/Folien/FotodiodesMeshPlotAddControllerStandalone.png
