MrPerfekt/Maya/Doc/Folien/FotodiodesMeshPlotBigStandalone.png

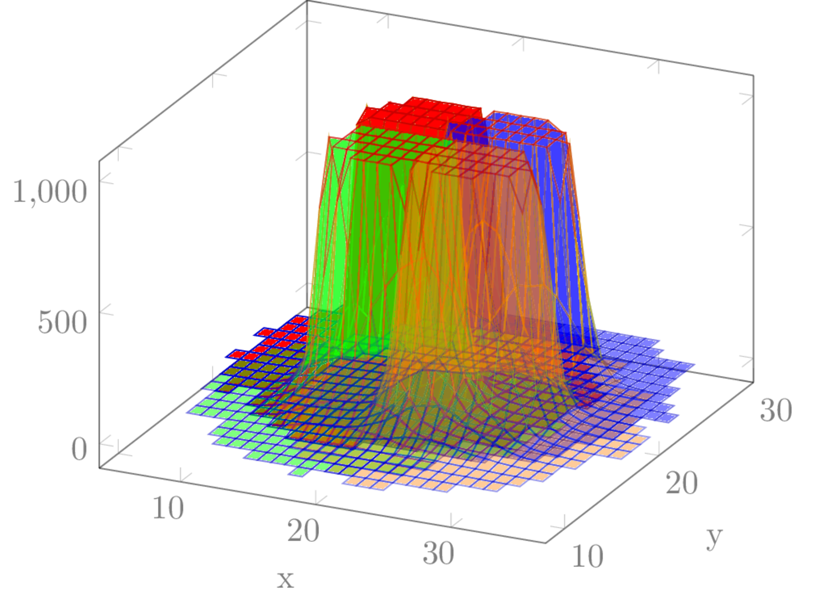
Doc/Folien/FotodiodesMeshPlotBigStandalone.png
