MrPerfekt/Maya/Doc/Folien/Lasercontroll01.PNG

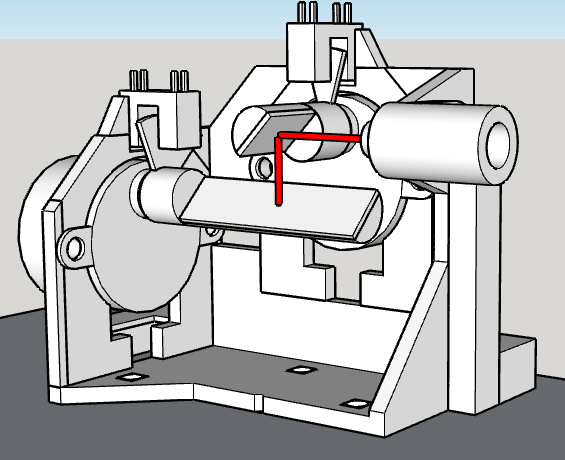
Doc/Folien/Lasercontroll01.PNG
