MrPerfekt/Maya/SketchUp/Version07/MainLightBarrierHolder62.stl

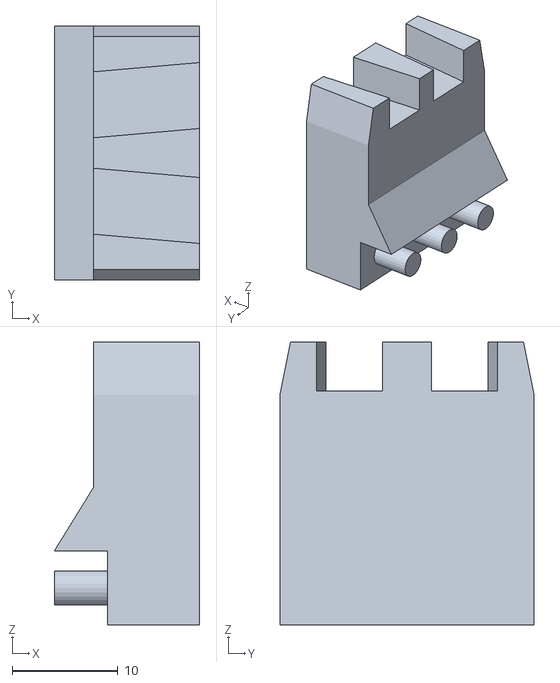
[picture p230: CAD file, 2017-01-21, an earlier design]
SketchUp/Version07/MainLightBarrierHolder62.stl
13.7 x 24.0 x 26.7
