MrPerfekt/Maya/SketchUp/Version00/Calibrater/Calibrater.amf

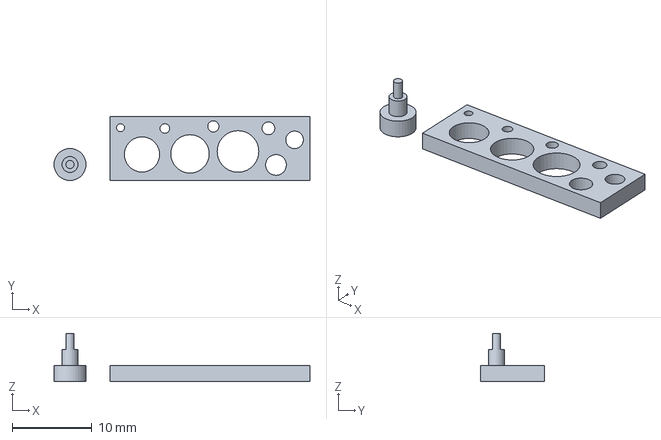
[picture p231: CAD file, 2017-01-21, an earlier design]
SketchUp/Version00/Calibrater/Calibrater.amf
32.0 x 8.00 x 6.00 mm
