MrPerfekt/Maya/SketchUp/Version08/EncoderPlateHolderBack.stl

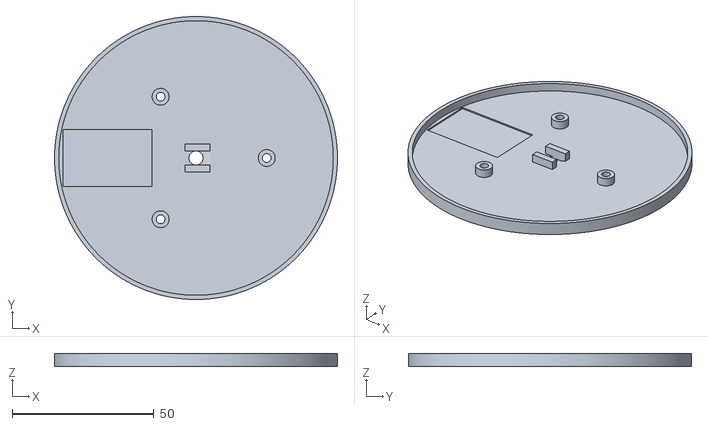
[picture p232: CAD file, 2017-01-21, an earlier design]
SketchUp/Version08/EncoderPlateHolderBack.stl
100.0 x 100.0 x 4.50
