MrPerfekt/Maya/SketchUp/Version07/rotorCapLong.stl

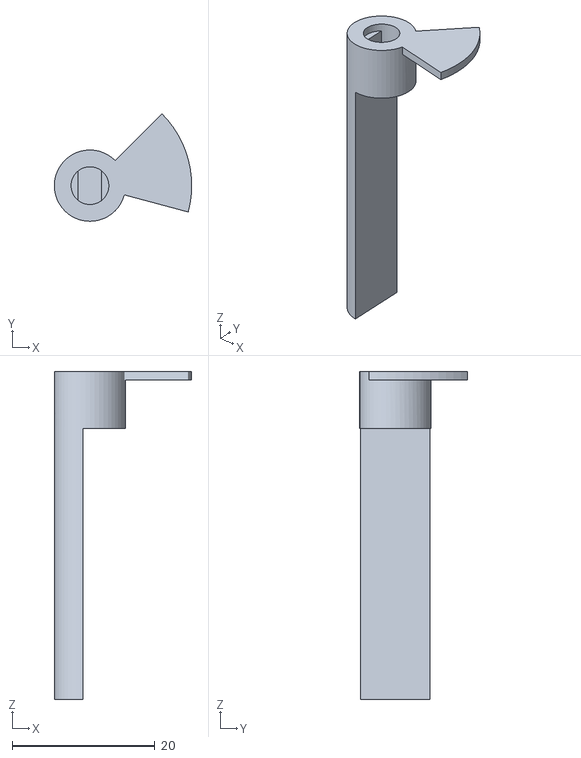
[picture p233: CAD file, 2017-01-21, an earlier design]
SketchUp/Version07/rotorCapLong.stl
19.3 x 15.1 x 46.0
