MrPerfekt/Maya/SketchUp/Version08/rotorCapShort.stl

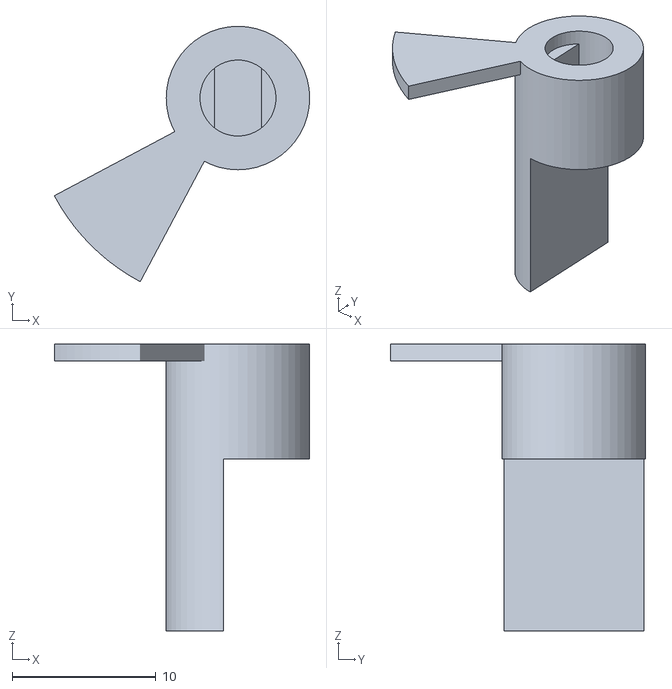
[picture p234: CAD file, 2017-01-21, an earlier design]
SketchUp/Version08/rotorCapShort.stl
17.8 x 17.8 x 20.0
