MrPerfekt/Maya/SketchUp/Version08/EncoderPlateHolderBackSmall.stl

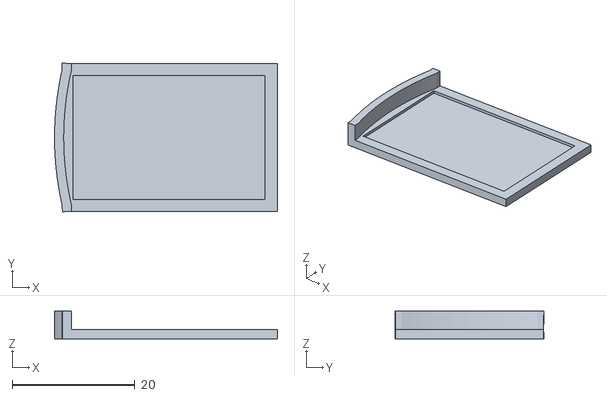
[picture p235: CAD file, 2017-01-21, an earlier design]
SketchUp/Version08/EncoderPlateHolderBackSmall.stl
36.4 x 24.3 x 4.50
