MrPerfekt/Maya/SketchUp/Version07/LaserHolder.stl

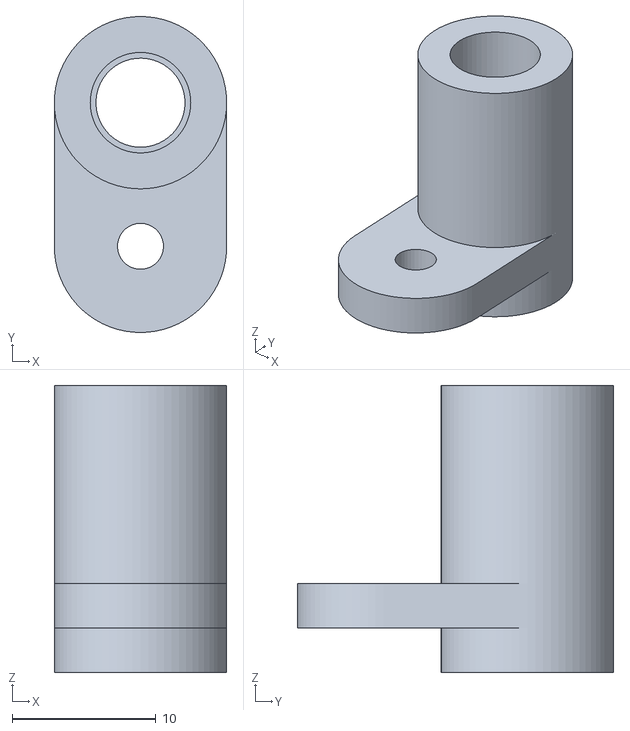
[picture p236: CAD file, 2017-01-21, an earlier design]
SketchUp/Version07/LaserHolder.stl
12.0 x 22.0 x 20.0
