MrPerfekt/Maya/SketchUp/Version08/EncoderPlateHolderFront.stl

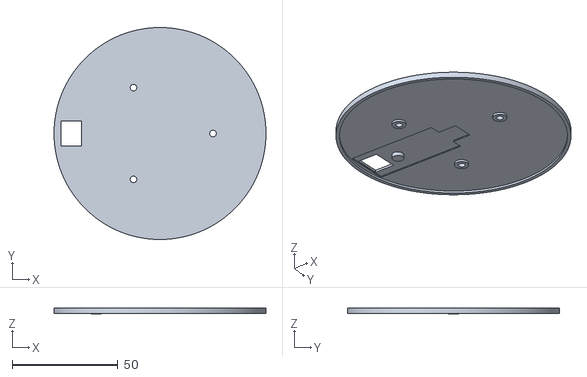
[picture p237: CAD file, 2017-01-21, an earlier design]
SketchUp/Version08/EncoderPlateHolderFront.stl
100.0 x 100.0 x 2.80
