MrPerfekt/Maya/SketchUp/Version07/Spacer.stl

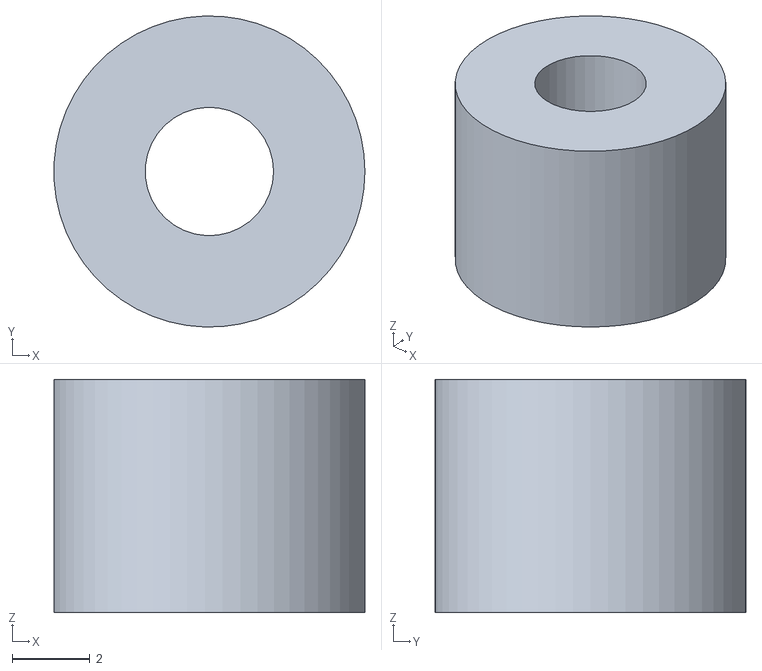
[picture p238: CAD file, 2017-01-21, an earlier design]
SketchUp/Version07/Spacer.stl
7.99 x 8.00 x 6.00
