MrPerfekt/Maya/SketchUp/Version08/EncoderPlateHolderFrontSmall.stl

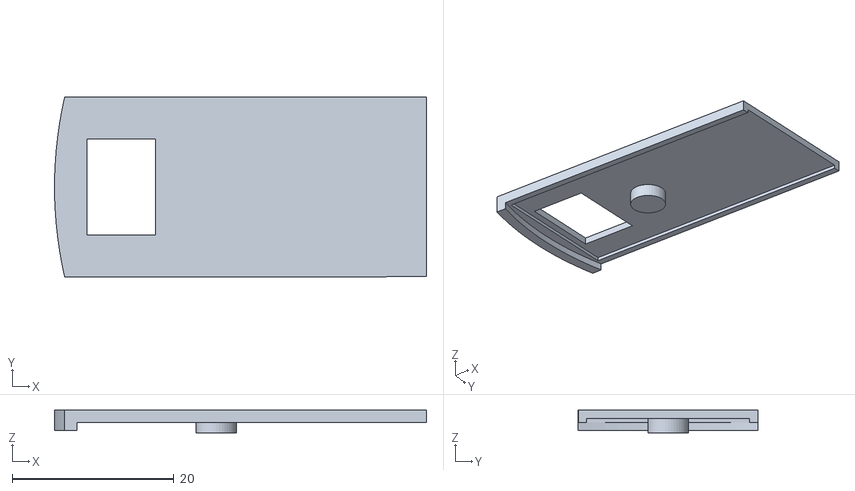
[picture p239: CAD file, 2017-01-21, an earlier design]
SketchUp/Version08/EncoderPlateHolderFrontSmall.stl
46.0 x 22.3 x 2.80
