MrPerfekt/Maya/SketchUp/Version07/MotorHolderBase.stl

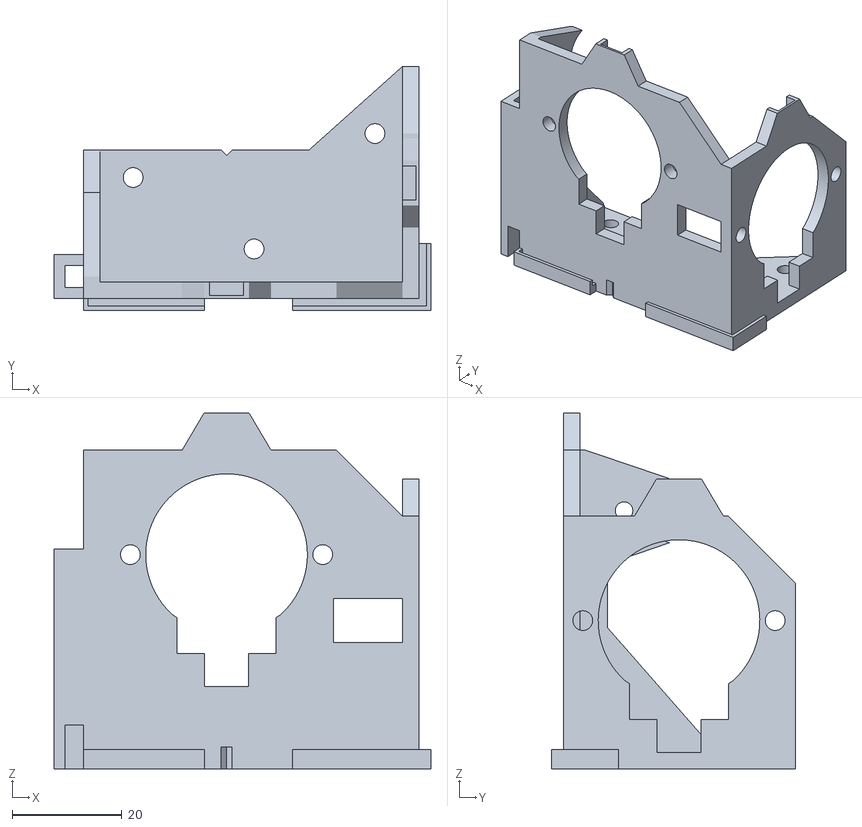
[picture p240: CAD file, 2017-01-21, an earlier design]
SketchUp/Version07/MotorHolderBase.stl
68.6 x 44.4 x 64.8
