MrPerfekt/Maya/SketchUp/Version07/Kabelkanal.stl

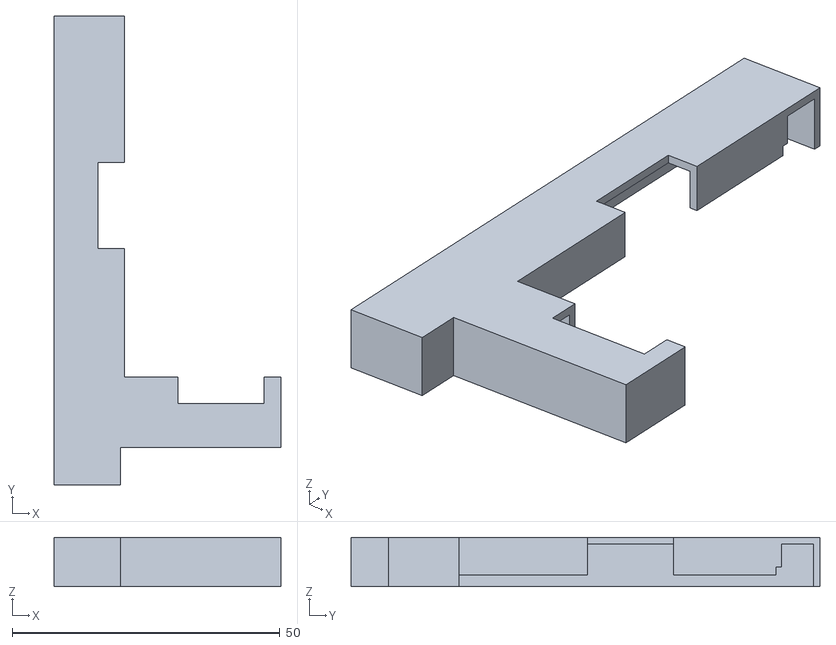
[picture p241: CAD file, 2017-01-21, an earlier design]
SketchUp/Version07/Kabelkanal.stl
42.4 x 87.6 x 9.20
