MrPerfekt/Maya/SketchUp/Version07/Huelse.stl

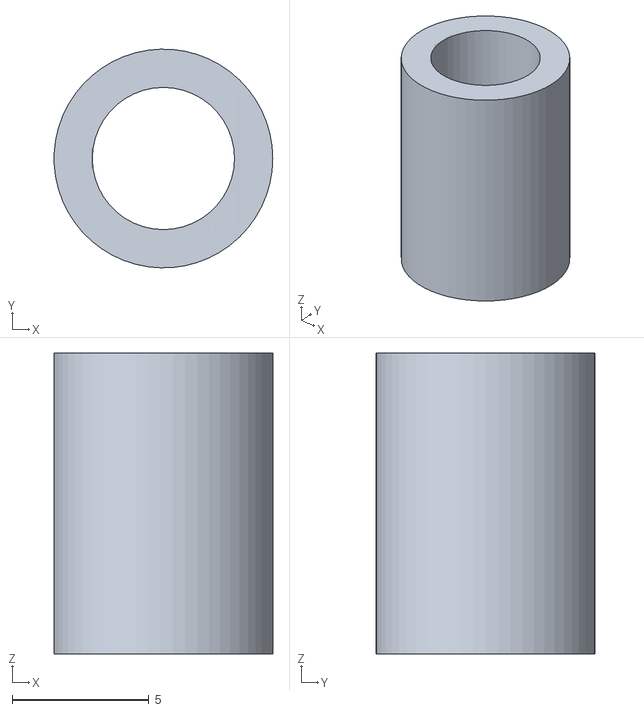
[picture p242: CAD file, 2017-01-21, an earlier design]
SketchUp/Version07/Huelse.stl
7.99 x 8.00 x 11.0
