MrPerfekt/Maya/SketchUp/Version07/rotorCapShort.stl

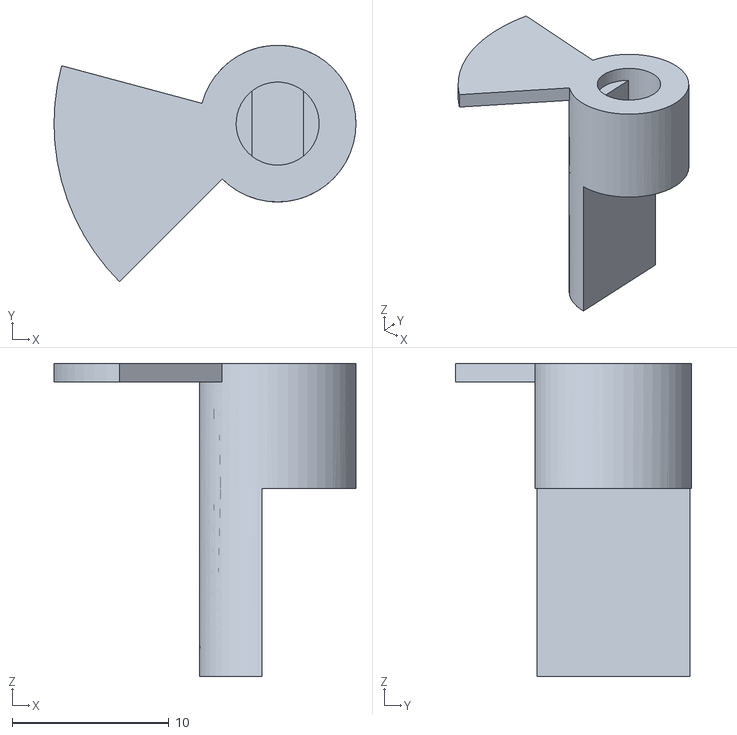
[picture p243: CAD file, 2017-01-21, an earlier design]
SketchUp/Version07/rotorCapShort.stl
19.3 x 15.1 x 20.0
