MrPerfekt/Maya/(list of files, cad)

Other CAD files:
SketchUp/Version07/MainLightBarrierHolder60.stl
SketchUp/Version07/EncoderPlateHolderBack.stl
SketchUp/Version00/BearingHolder00/BearingHolderBigEnd.skp
SketchUp/Version00/BearingHolder00/BearingHolderSmallEnd.skp
SketchUp/Version00/BearingHolder00/bearingHolder.skp
SketchUp/Version00/BearingHolder00/bearingHolderBig.skp
SketchUp/Version00/BearingHolder00/bearingHolderSmall.skp
SketchUp/Version00/Calibrater/Calibrater.skp
SketchUp/Version00/Calibrater/Calibrater_V8.skp
SketchUp/Version00/StepperHolder00/motor.skp
SketchUp/Version00/StepperHolder00/motorWithKnob.skp
SketchUp/Version00/StepperHolder00/motorWithLongCap.skp
SketchUp/Version00/StepperHolder00/motorWithLongCapAbove.skp
SketchUp/Version00/StepperHolder00/motorWithSmallCap.skp
SketchUp/Version00/StepperHolder00/motorWithSmallCapAbove.skp
SketchUp/Version00/StepperHolder00/motorWithoutKnob.skp
SketchUp/Version00/StepperHolder00/rotorCapLong.skp
SketchUp/Version00/StepperHolder00/rotorCapShort.skp
SketchUp/Version00/StepperHolder00/rotorKnobOrigin.skp
SketchUp/Version00/StepperHolder00/rotorKnobTurned.skp
SketchUp/Version00/StepperHolder00/stepperHolder.skp
SketchUp/Version00/StepperHolder00/stepperHolderWithMotors.skp
SketchUp/Version00/StepperHolder01/LightBarrierGP1S093HCZ0F.skp
SketchUp/Version00/StepperHolder01/LightBarrierHolderGP1S093HCZ0F.skp
SketchUp/Version00/StepperHolder01/LightBarrierHolderWithLightBarrierGP1S093HCZ0F.skp
SketchUp/Version00/StepperHolder01/motor.skp
SketchUp/Version00/StepperHolder01/motorWithKnob.skp
SketchUp/Version00/StepperHolder01/motorWithLongCap.skp
SketchUp/Version00/StepperHolder01/motorWithLongCapAbove.skp
SketchUp/Version00/StepperHolder01/motorWithSmallCap.skp
SketchUp/Version00/StepperHolder01/motorWithSmallCapAbove.skp
SketchUp/Version00/StepperHolder01/motorWithoutKnob.skp
SketchUp/Version00/StepperHolder01/rotorCapLong.skp
SketchUp/Version00/StepperHolder01/rotorCapShort.skp
SketchUp/Version00/StepperHolder01/rotorKnobOrigin.skp
SketchUp/Version00/StepperHolder01/rotorKnobTurned.skp
SketchUp/Version00/StepperHolder01/stepperHolder.skp
SketchUp/Version00/StepperHolder01/stepperHolderWithMotors.skp
SketchUp/Version00/StepperHolder02/LightBarrierHolderAssembled.skp
SketchUp/Version00/StepperHolder02/rotorCapLong.skp
SketchUp/Version00/StepperHolder02/rotorCapLong_V8.skp
SketchUp/Version00/StepperHolder02/rotorCapShort.skp
SketchUp/Version00/StepperHolder02/rotorCapShort_V8.skp
SketchUp/Version00/StepperHolder02/stepperHolderOptimiced.skp
SketchUp/Version00/StepperHolder02/stepperHolderOptimiced_V8.skp
SketchUp/Version00/StepperHolder02/stepperHolderWithMotorsOptimiced.skp
SketchUp/Version00/StepperHolder02/stepperHolderWithMotorsOptimiced_V8.skp
SketchUp/Version01/EncoderDiskHolder.skp
SketchUp/Version01/Pendulum.skp
SketchUp/Version01/Pendulum01.skp
SketchUp/Version01/Pendulum01_V8.skp
SketchUp/Version01/Pendulum02.skp
SketchUp/Version01/Pendulum02_V8.skp
SketchUp/Version01/Pendulum03.skp
SketchUp/Version03/BaseFrame.skp
SketchUp/Version03/BaseFrame_V8.skp
SketchUp/Version03/BearingRotaryEncoderHolder.skp
SketchUp/Version03/BearingRotaryEncoderHolder_V8.skp
SketchUp/Version03/Cantilever.skp
SketchUp/Version03/Cantilever_V8.skp
SketchUp/Version03/ConnectorMale 2.5x6.skp
SketchUp/Version03/EncoderPlateHolderBack.skp
SketchUp/Version03/EncoderPlateHolderBack_V8.skp
SketchUp/Version03/EncoderPlateHolderFront.skp
SketchUp/Version03/EncoderPlateHolderFront_V8.skp
SketchUp/Version03/LightBarrierConnectorFemale.skp
SketchUp/Version03/LightBarrierConnectorFemale_V8.skp
SketchUp/Version03/LightBarrierHolder.skp
SketchUp/Version03/LightBarrierHolderH.skp
SketchUp/Version03/LightBarrierHolderH_V8.skp
SketchUp/Version03/LightBarrierHolderV.skp
SketchUp/Version03/LightBarrierHolderV_V8.skp
SketchUp/Version03/LightBarrierHolderWithHolder.skp
SketchUp/Version03/LightBarrierHolderWithHolder_V8.skp
SketchUp/Version03/MirrorHolderSmall.skp
SketchUp/Version03/MirrorHolderSmall_V8.skp
SketchUp/Version03/Pendulum04.skp
SketchUp/Version03/Pendulum04_V8.skp
SketchUp/Version03/Pendulum05.skp
SketchUp/Version03/RotaryEncoderTopHolder.skp
SketchUp/Version03/RotaryEncoderTopHolder_V8.skp
SketchUp/Version03/SensorHolder.skp
SketchUp/Version03/SensorHolder_V8.skp
SketchUp/Version03/Test ConnectorFemale 2.5x6.skp
SketchUp/Version03/Test ConnectorFemale 2.5x6_V8.skp
SketchUp/Version03/Test ConnectorMale 2.5x6.skp
SketchUp/Version03/Test ConnectorMale 2.5x6_V8.skp
SketchUp/Version03/TestPrint.skp
SketchUp/Version03/TestPrint_V8.skp
SketchUp/Version03/rotorCapLong.skp
SketchUp/Version03/rotorCapLong_V8.skp
SketchUp/Version03/stepperHolderOptimiced.skp
SketchUp/Version03/stepperHolderOptimiced_V8.skp
SketchUp/Version04/BearingRotaryEncoderHolder.skp
SketchUp/Version04/BearingRotaryEncoderHolder_V8.skp
SketchUp/Version04/Cantilever.skp
SketchUp/Version04/Cantilever_V8.skp
SketchUp/Version04/EncoderPlateHolderBack.skp
SketchUp/Version04/EncoderPlateHolderBack_V8.skp
SketchUp/Version04/EncoderPlateHolderFront.skp
SketchUp/Version04/EncoderPlateHolderFront_V8.skp
SketchUp/Version04/LightBarrierHolder.skp
SketchUp/Version04/LightBarrierHolder_V8.skp
SketchUp/Version04/MotorHolderBase.skp
SketchUp/Version04/MotorHolderBase_V8.skp
SketchUp/Version04/Pendulum.skp
SketchUp/Version04/Pendulum_V8.skp
SketchUp/Version05/BearingRotaryEncoderHolder.skp
SketchUp/Version05/Pendulum.skp
SketchUp/Version05/Pendulum_V8.skp
SketchUp/Version06/Maya.skp
SketchUp/Version06/Maya_V8.skp
SketchUp/Version07/EncoderPlateHolderBack.skp
SketchUp/Version07/Huelse.skp
SketchUp/Version07/Huelse00.skp
SketchUp/Version07/Kabelkanal.skp
SketchUp/Version07/LaserHolder.skp
SketchUp/Version07/MainDoubleLightBarrierHolder.skp
SketchUp/Version07/MainLightBarrierHolder60.skp
SketchUp/Version07/MainLightBarrierHolder62.skp
SketchUp/Version07/MainSingleLightBarrierHolder.skp
SketchUp/Version07/Maya.skp
SketchUp/Version07/MirrorHolderSmall.skp
SketchUp/Version07/MotorHolderBase.skp
SketchUp/Version07/Motorhalter.skp
SketchUp/Version07/Spacer.skp
SketchUp/Version07/rotorCapLong.skp
SketchUp/Version07/rotorCapShort.skp
SketchUp/Version08/EncoderPlateHolderBack.skp
SketchUp/Version08/EncoderPlateHolderBackSmall.skp
SketchUp/Version08/EncoderPlateHolderFront.skp
SketchUp/Version08/EncoderPlateHolderFrontSmall.skp
SketchUp/Version08/FullRotaryEncoderDisc.skp
SketchUp/Version08/Maya.skp
SketchUp/Version08/MayaWithAdjustetRotorcapps.skp
SketchUp/Version08/rotorCapShort.skp
SketchUp/Version09/MotorMount.skp
