MrPerfekt/Maya/Doc/Bachelorarbeit10/img/PicturesPlots/Encoder/BigStep/COPY/CONVERT/SCRN0111_Cutted.jpg

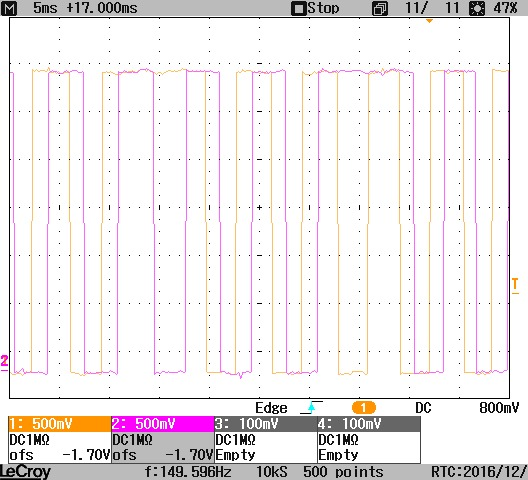
Doc/Bachelorarbeit10/img/PicturesPlots/Encoder/BigStep/COPY/CONVERT/SCRN0111_Cutted.jpg
