MrPerfekt/Maya/Doc/Bachelorarbeit10/img/PicturesPlots/Encoder/BigStep/COPY/CONVERT/SCRN0111_Original.jpg

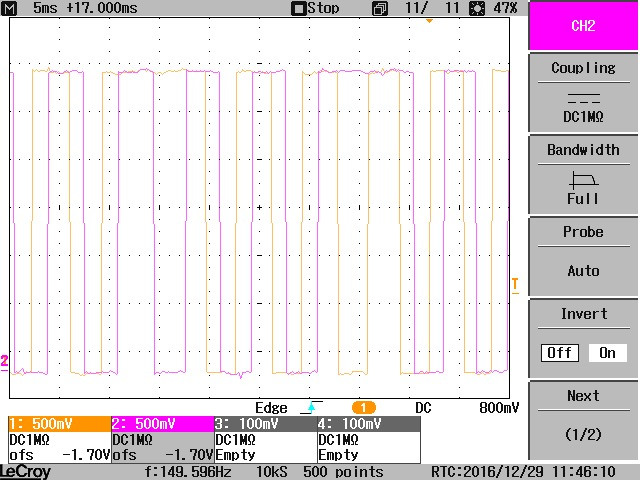
Doc/Bachelorarbeit10/img/PicturesPlots/Encoder/BigStep/COPY/CONVERT/SCRN0111_Original.jpg
