MrPerfekt/Maya/Doc/Bachelorarbeit10/img/PicturesPlots/Encoder/BigStep/COPY/SCRN0112.BMP

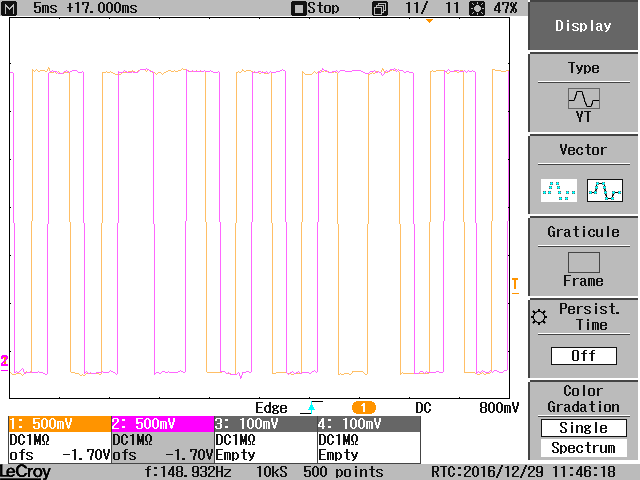
Doc/Bachelorarbeit10/img/PicturesPlots/Encoder/BigStep/COPY/SCRN0112.BMP
