MrPerfekt/Maya/Doc/Bachelorarbeit10/img/PicturesPlots/Encoder/BigStep/COPY/SCRN0114.BMP

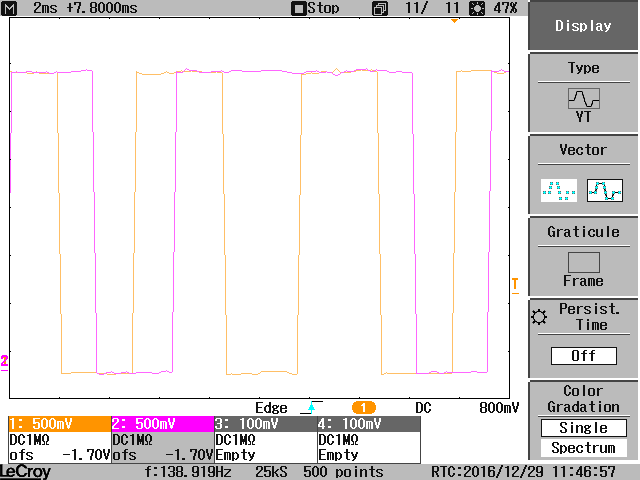
Doc/Bachelorarbeit10/img/PicturesPlots/Encoder/BigStep/COPY/SCRN0114.BMP
