MrPerfekt/Maya/eagle/pendulum00/circuitPendulumBrushes.pdf

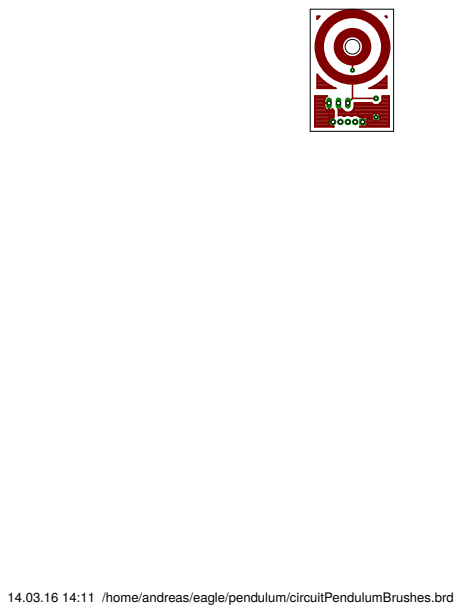
[picture p261: page 1]

14.03.16 14:11 /home/andreas/eagle/pendulum/circuitPendulumBrushes.brd
