MrPerfekt/Maya/eagle/pendulum00/circuitPendulumController.pdf

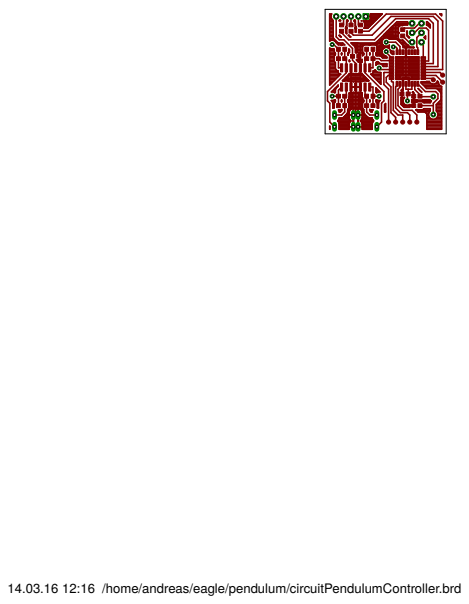
[picture p262: page 1]

14.03.16 12:16 /home/andreas/eagle/pendulum/circuitPendulumController.brd
