MrPerfekt/Maya/eagle/pendulum00/circuitPendulumController01.pdf

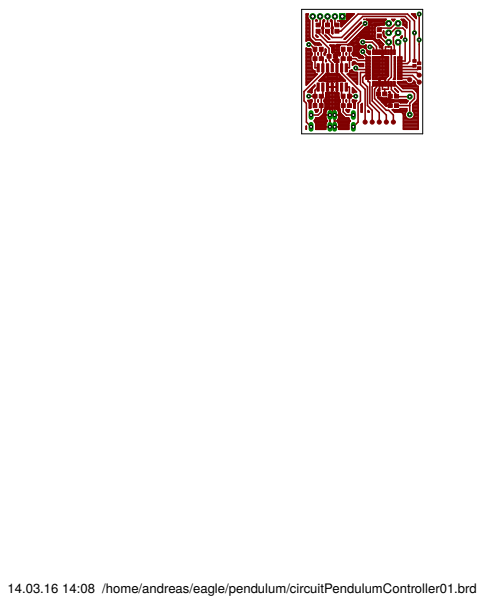
[picture p263: page 1]

14.03.16 14:08 /home/andreas/eagle/pendulum/circuitPendulumController01.brd
