MrPerfekt/Maya/eagle/pendulum00/circuitPendulumLEDs.pdf

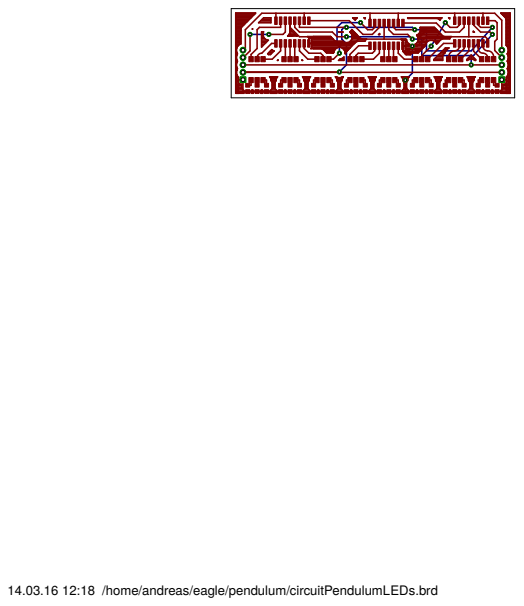
[picture p264: page 1]

14.03.16 12:18 /home/andreas/eagle/pendulum/circuitPendulumLEDs.brd
