MrPerfekt/Maya/Doc/Bachelorarbeit10/FotodiodesMeshPlotAddAllStandalone.pdf

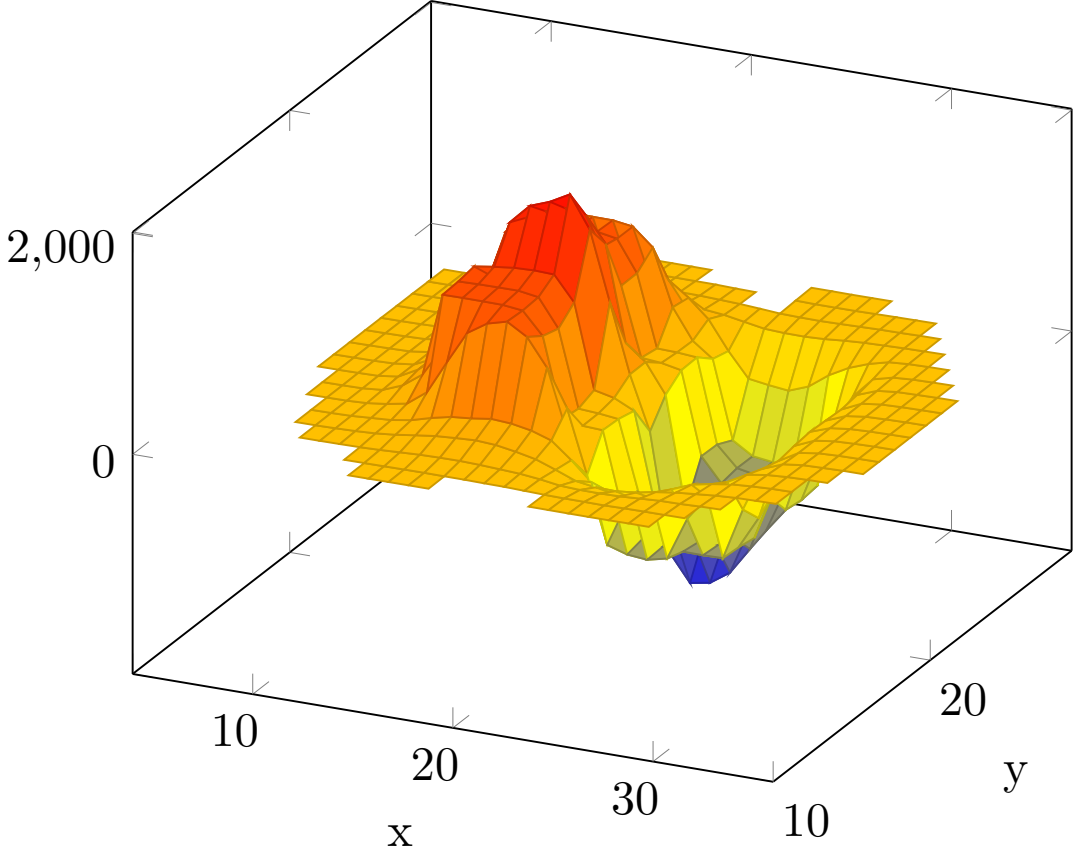
[picture p265: page 1]
