MrPerfekt/Maya/Doc/Bachelorarbeit10/FotodiodesMeshPlotAddControllerStandalone.pdf

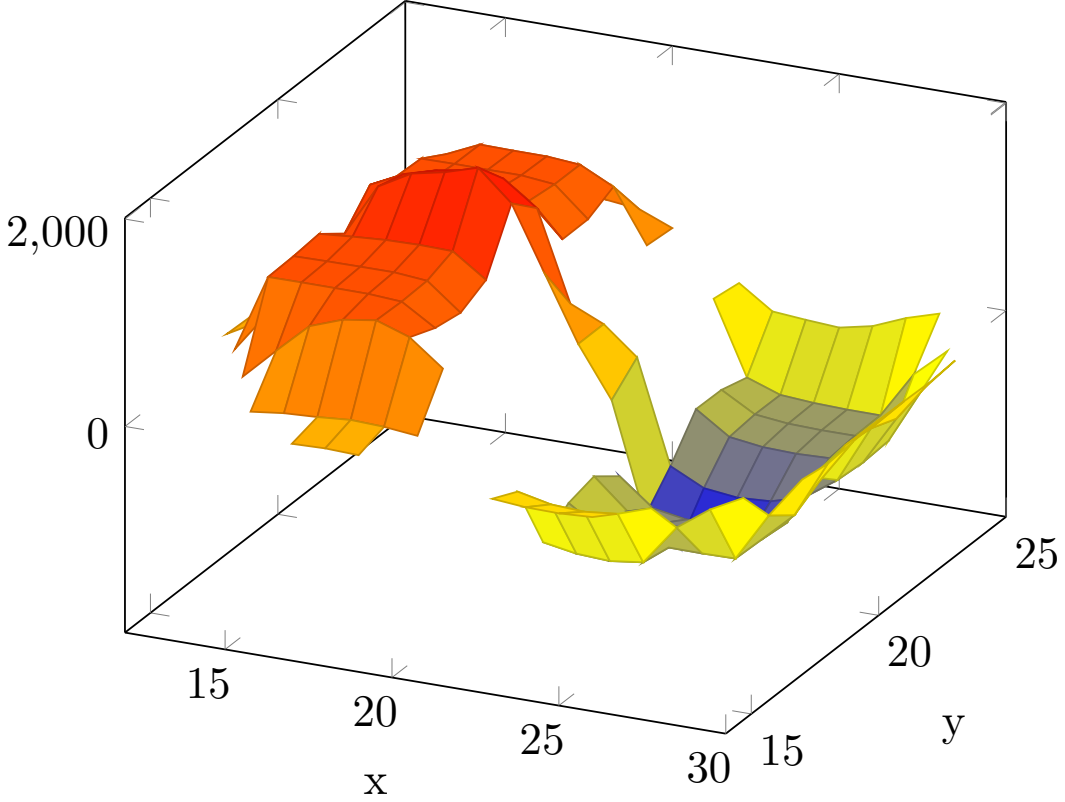
[picture p266: page 1]
