MrPerfekt/Maya/Doc/Bachelorarbeit10/FotodiodesMeshPlotBigStandalone.pdf

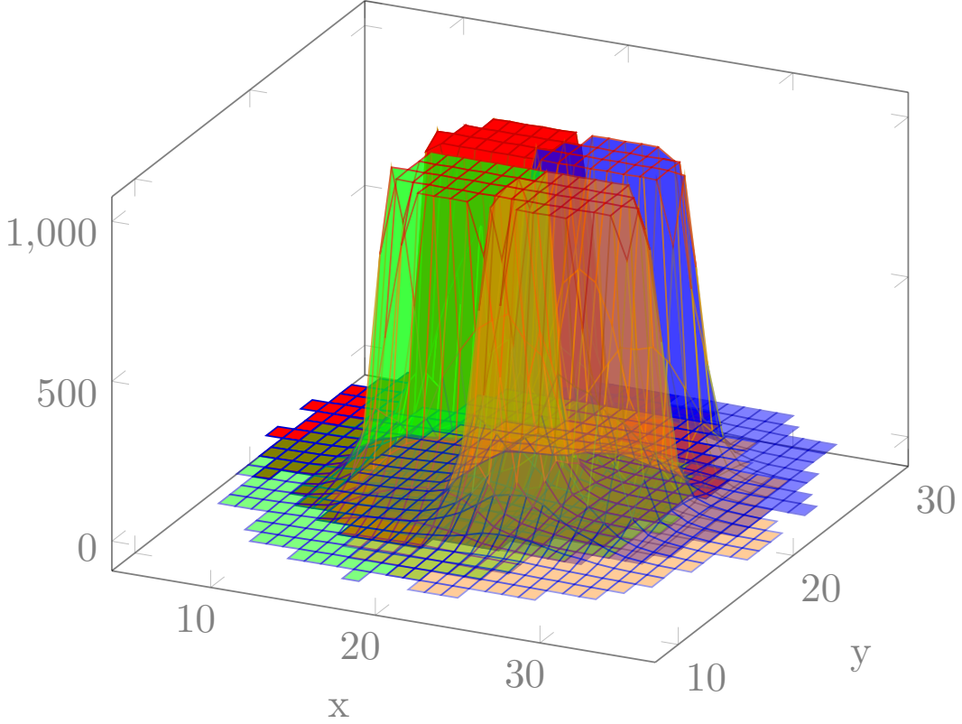
[picture p267: page 1]
