MrPerfekt/Maya/Doc/Bachelorarbeit10/FotodiodesMeshPlotMaxAllStandalone.pdf

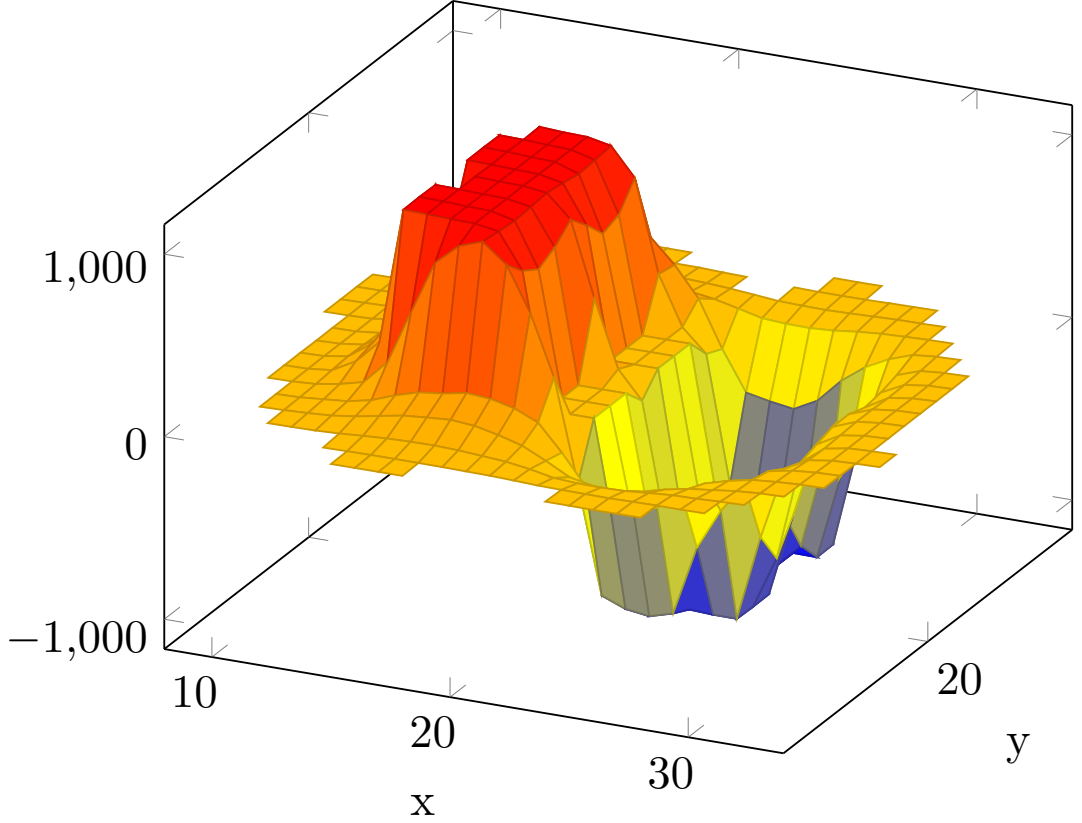
[picture p268: page 1]
