MrPerfekt/Maya/Doc/Bachelorarbeit10/FotodiodesMeshPlotMaxControllerStandalone.pdf

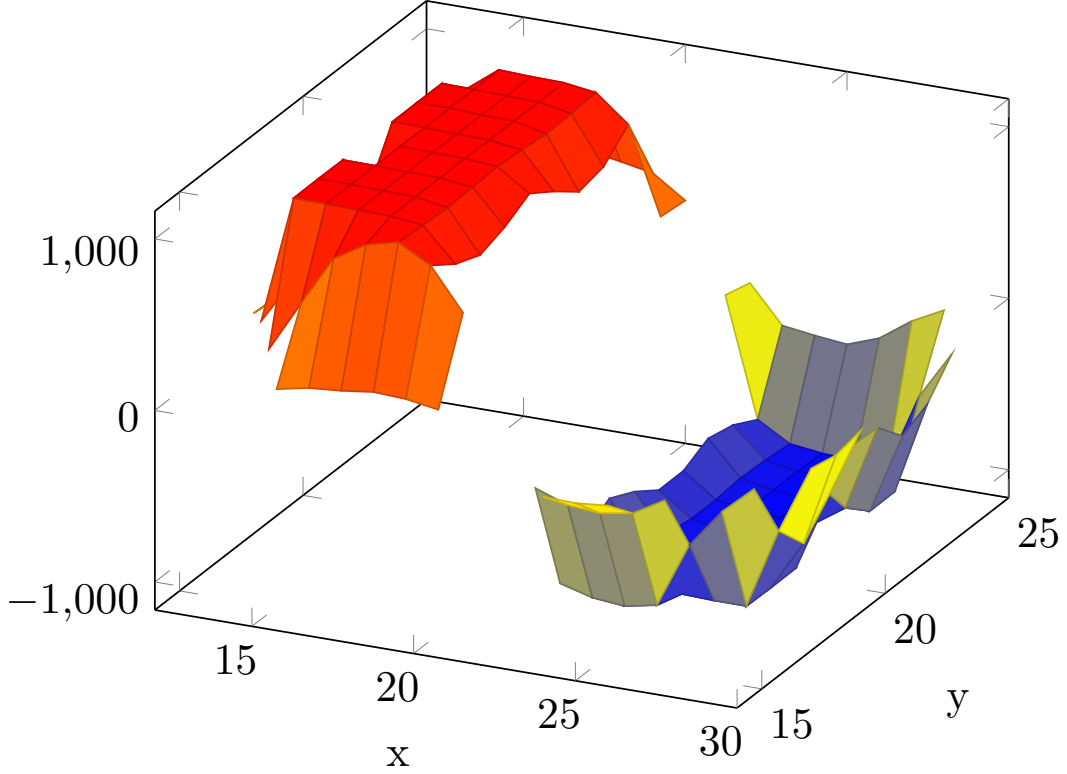
[picture p269: page 1]
