MrPerfekt/Maya/Doc/Bachelorarbeit10/FotodiodesMeshPlotSingleGoodStandalone.pdf

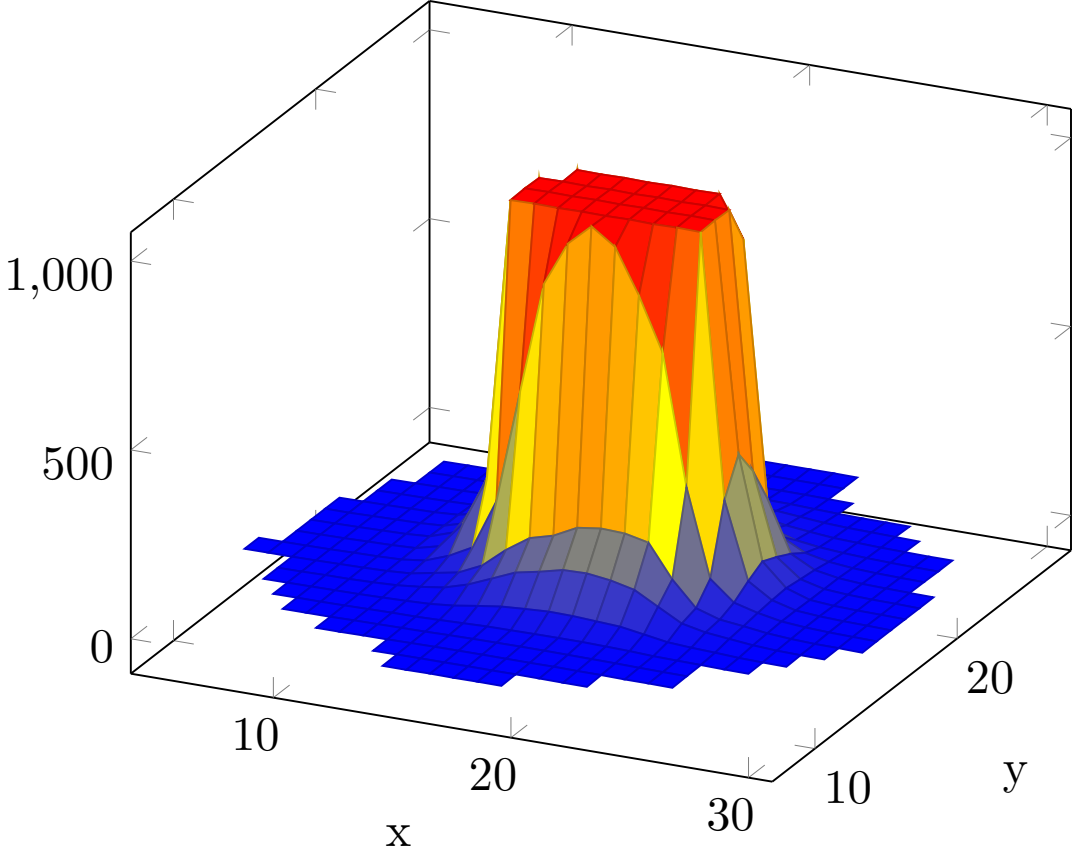
[picture p270: page 1]
