MrPerfekt/Maya/Doc/Bachelorarbeit10/samStmSensorsAktuatorsStandalone.pdf

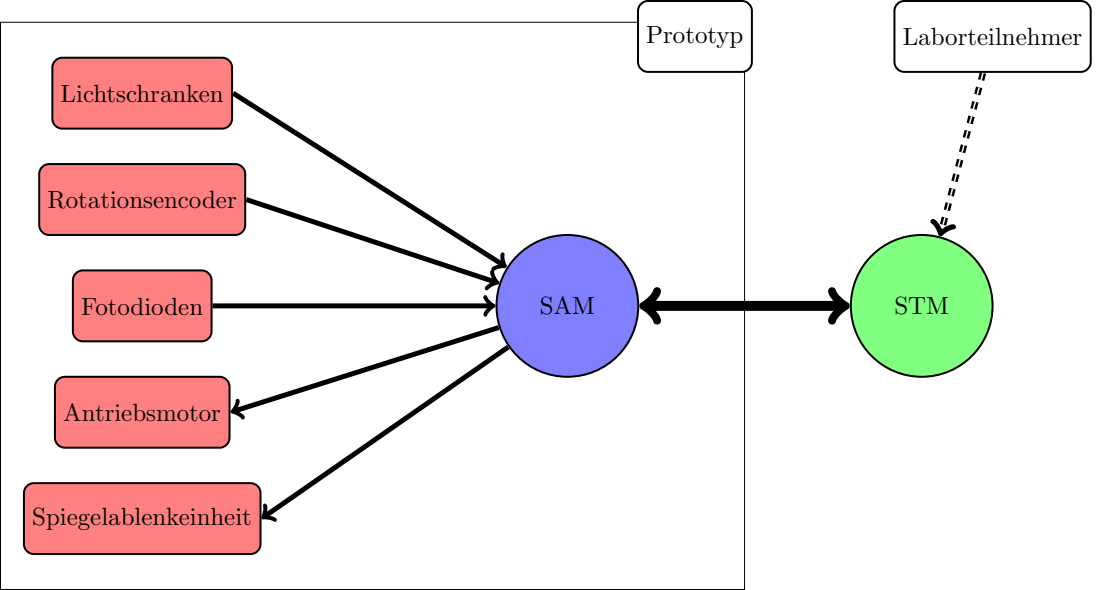
[picture p271: page 1]
SAM; STM; Laborteilnehmer; Lichtschranken; Rotationsencoder; Fotodioden; Antriebsmotor; Spiegelablenkeinheit; Prototyp
