MrPerfekt/Maya/Doc/Bachelorarbeit10/samStmSensorsAktuatorsStandalonePresentation.pdf

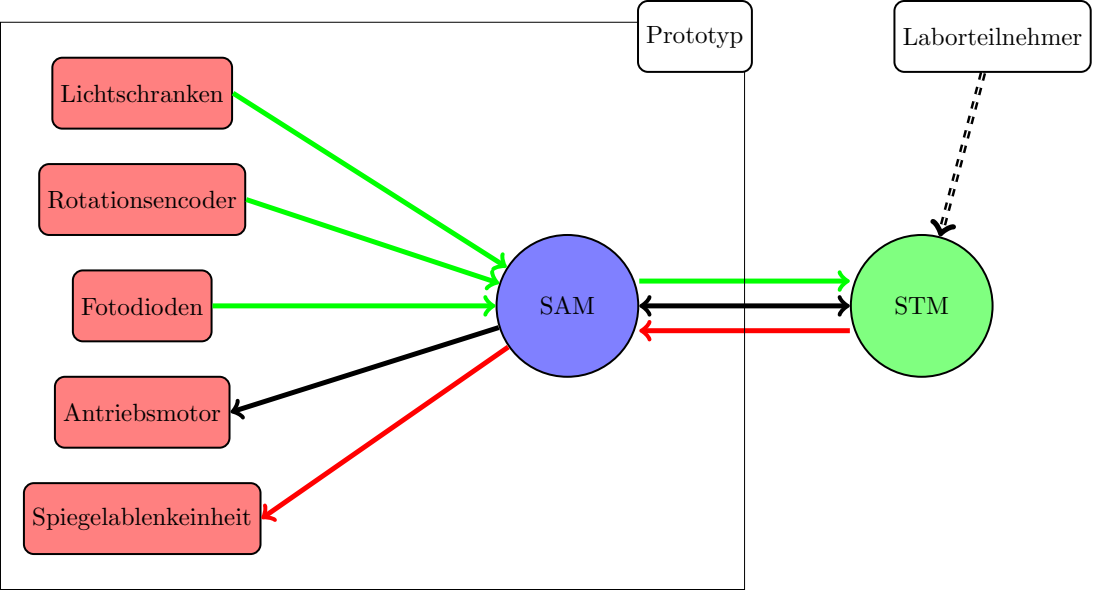
[picture p272: page 1]
SAM; STM; Laborteilnehmer; Lichtschranken; Rotationsencoder; Fotodioden; Antriebsmotor; Spiegelablenkeinheit; Prototyp
