MrPerfekt/Maya/Tikz/RotaryEncoderTikz/rotaryEncoder05.pdf

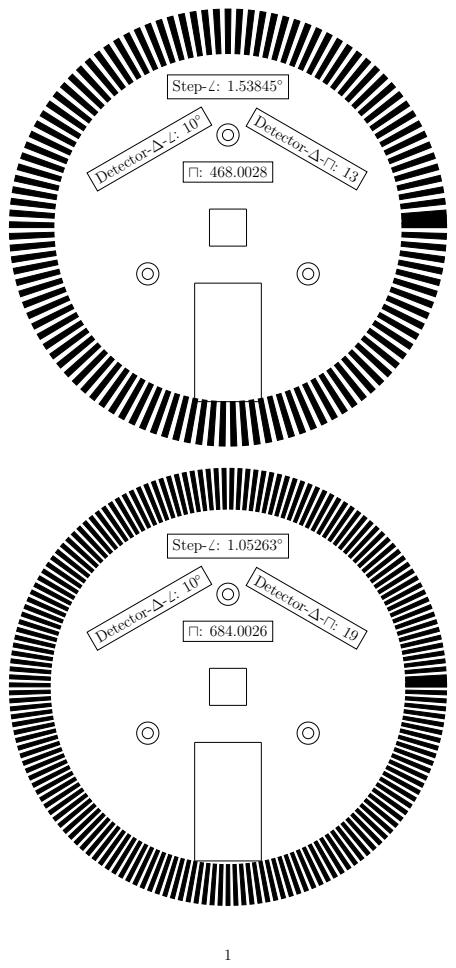
[picture p273: page 1]
Step-⁶ : 1.53845◦; Detector-∆-6 : 10; Detector-∆-u: 13; Step-⁶ : 1.05263◦; Detector-∆-u: 19
