MrPerfekt/Maya/Tikz/RotaryEncoderTikz/rotaryEncoder05detector1u3.pdf

1

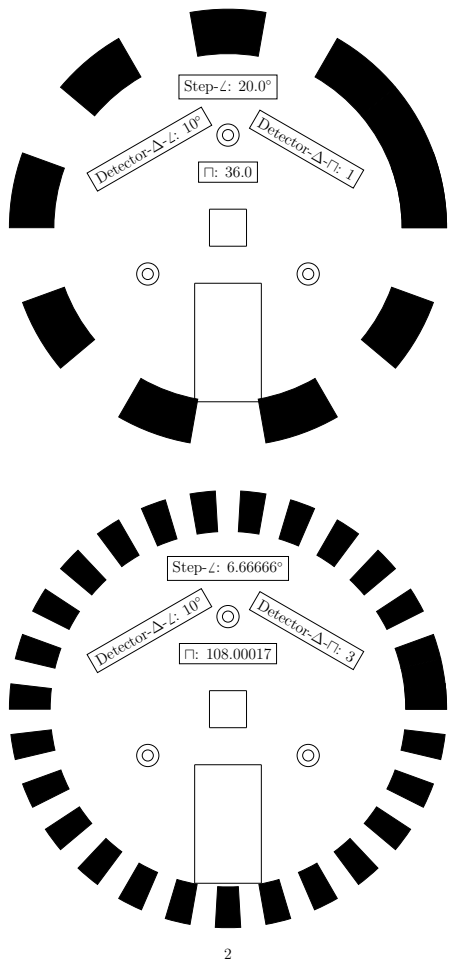
[picture p274: page 2]
Step-⁶ : 20.0◦; Detector-∆-6 : 10; Detector-∆-u: 1; Step-⁶ : 6.66666◦; Detector-∆-u: 3
