MrPerfekt/Maya/eagle/maya00/circuitPendulum4TIA01 screenShot.brd

## EAGLE design eagle/maya00/circuitPendulum4TIA01 screenShot.brd (2017-01-21)

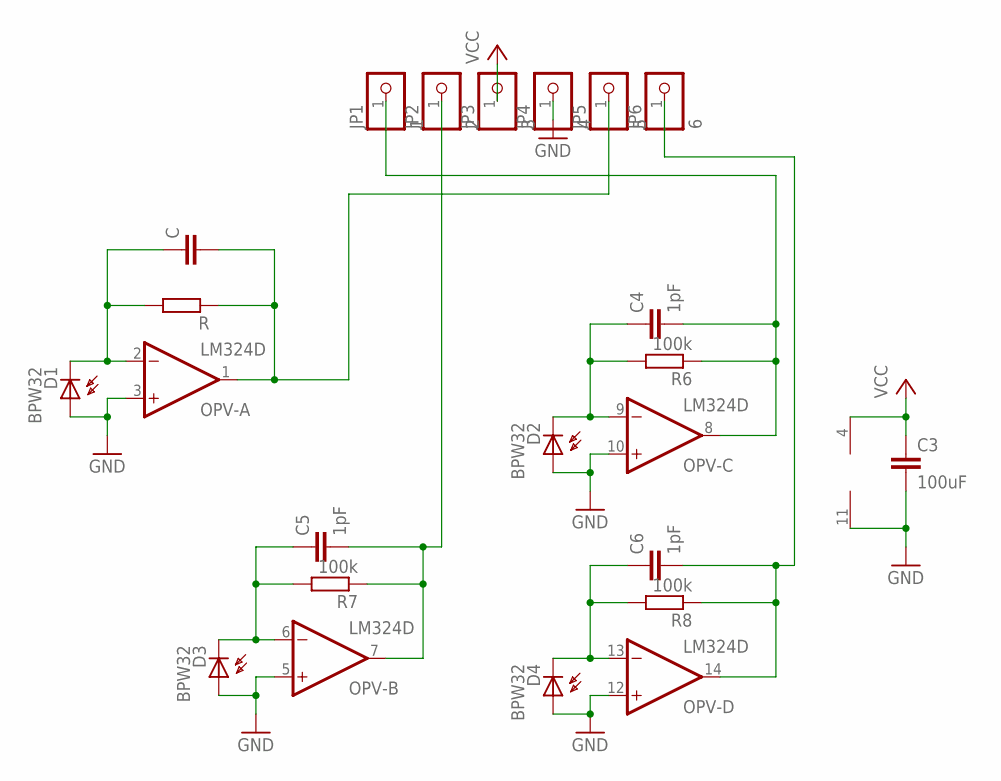
[picture p275: schematic circuitPendulum4TIA01 screenShot.sch]

Parts:
C: C-EUC0603; C0603
C3: 100uF; C0603
C4, C5, C6: 1pF; C0603
D1, D2, D3, D4: BPW32
JP1: 1; 1X01SMD
JP2: 2; 1X01SMD
JP3: 3; 1X01SMD
JP4: 4; 1X01SMD
JP5: 5; 1X01SMD
JP6: 6; 1X01SMD
OPV-: LM324D; SO14
R: R-EU_R0603; R0603
R6, R7, R8: 100k; R0603

Connections:
GND: C3.2, D1.A, D2.A, D3.A, D4.A, JP4.1, OPV-.3 (+IN), OPV-.5 (+IN), OPV-.10 (+IN), OPV-.11 (V-), OPV-.12 (+IN)
unnamed: C.2, JP5.1, OPV-.1 (OUT), R.1
unnamed: C4.2, JP1.1, OPV-.8 (OUT), R6.1
unnamed: C.1, D1.K (C), OPV-.2 (-IN), R.2
unnamed: C5.1, D3.K (C), OPV-.6 (-IN), R7.2
unnamed: C5.2, JP2.1, OPV-.7 (OUT), R7.1
unnamed: C6.2, JP6.1, OPV-.14 (OUT), R8.1
unnamed: C6.1, D4.K (C), OPV-.13 (-IN), R8.2
unnamed: C4.1, D2.K (C), OPV-.9 (-IN), R6.2
VCC: C3.1, JP3.1, OPV-.4 (V+)

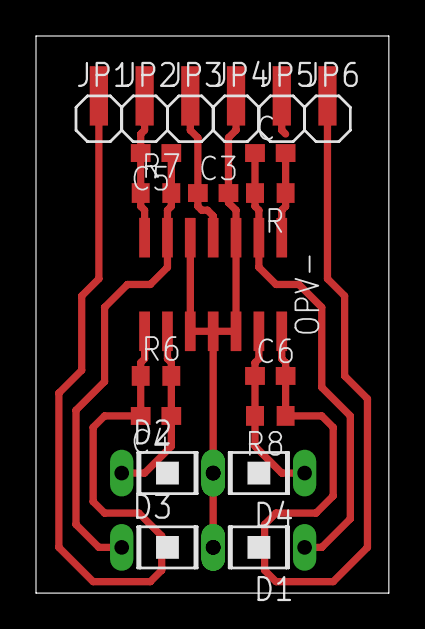
[picture p276: board circuitPendulum4TIA01 screenShot.brd from above]

Board: 2 copper layers, 19.6 x 30.9 mm, 20 parts (0 on the bottom side), 10 nets.
