MrPerfekt/Maya/eagle/pendulum00/circuitPendulumLEDs.brd

## EAGLE design eagle/pendulum00/circuitPendulumLEDs.brd (2017-01-21)

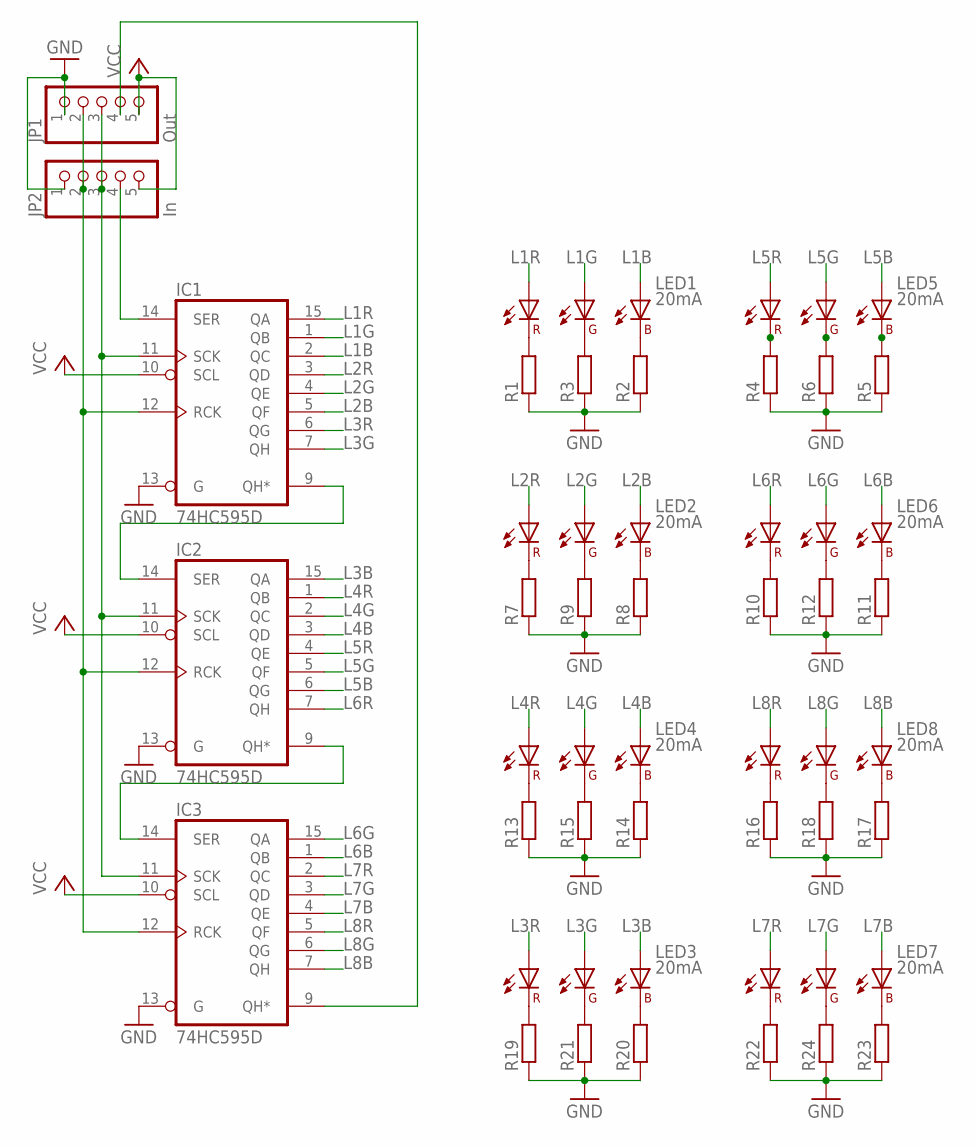
[picture p277: schematic circuitPendulumLEDs.sch]

Parts:
IC1, IC2, IC3: 74HC595D; SO16
JP1: Out; 1_05X2MM
JP2: In; 1_05X2MM
LED1, LED2, LED3, LED4, LED5, LED6, LED7, LED8: 20mA; PLCC-6_SAMSUNG
R1, R2, R3, R4, R5, R6, R7, R8, R9, R10, R11, R12, R13, R14, R15, R16, R17, R18, R19, R20, R21, R22, R23, R24: R-EU_R0603; R0603

Connections:
GND: IC1.8 (GND), IC1.13 (G), IC2.8 (GND), IC2.13 (G), IC3.8 (GND), IC3.13 (G), JP1.1, JP2.1, R1.1, R2.1, R3.1, R4.1, R5.1, R6.1, R7.1, R8.1, R9.1, R10.1, R11.1, R12.1, R13.1, R14.1, R15.1, R16.1, R17.1, R18.1, R19.1, R20.1, R21.1, R22.1, R23.1, R24.1
L1B: IC1.2 (QC), LED1.3 (AB)
L1G: IC1.1 (QB), LED1.2 (AG)
L1R: IC1.15 (QA), LED1.1 (AR)
L2B: IC1.5 (QF), LED2.3 (AB)
L2G: IC1.4 (QE), LED2.2 (AG)
L2R: IC1.3 (QD), LED2.1 (AR)
L3B: IC2.15 (QA), LED3.3 (AB)
L3G: IC1.7 (QH), LED3.2 (AG)
L3R: IC1.6 (QG), LED3.1 (AR)
L4B: IC2.3 (QD), LED4.3 (AB)
L4G: IC2.2 (QC), LED4.2 (AG)
L4R: IC2.1 (QB), LED4.1 (AR)
L5B: IC2.6 (QG), LED5.3 (AB)
L5G: IC2.5 (QF), LED5.2 (AG)
L5R: IC2.4 (QE), LED5.1 (AR)
L6B: IC3.1 (QB), LED6.3 (AB)
L6G: IC3.15 (QA), LED6.2 (AG)
L6R: IC2.7 (QH), LED6.1 (AR)
L7B: IC3.4 (QE), LED7.3 (AB)
L7G: IC3.3 (QD), LED7.2 (AG)
L7R: IC3.2 (QC), LED7.1 (AR)
L8B: IC3.7 (QH), LED8.3 (AB)
L8G: IC3.6 (QG), LED8.2 (AG)
L8R: IC3.5 (QF), LED8.1 (AR)
unnamed: LED1.4 (CR), R1.2
unnamed: LED1.6 (CB), R2.2
unnamed: LED1.5 (CG), R3.2
unnamed: LED5.4 (CR), R4.2
unnamed: LED5.6 (CB), R5.2
unnamed: LED5.5 (CG), R6.2
unnamed: LED4.4 (CR), R13.2
unnamed: IC1.9 (QH*), IC2.14 (SER)
unnamed: LED4.6 (CB), R14.2
unnamed: LED4.5 (CG), R15.2
unnamed: LED8.4 (CR), R16.2
unnamed: LED8.6 (CB), R17.2
unnamed: IC1.14 (SER), JP2.4
unnamed: IC2.9 (QH*), IC3.14 (SER)
unnamed: LED8.5 (CG), R18.2
unnamed: LED6.4 (CR), R10.2
unnamed: LED6.6 (CB), R11.2
unnamed: LED6.5 (CG), R12.2
unnamed: LED2.4 (CR), R7.2
unnamed: IC3.9 (QH*), JP1.4
unnamed: LED2.6 (CB), R8.2
unnamed: IC1.12 (RCK), IC2.12 (RCK), IC3.12 (RCK), JP1.2, JP2.2
unnamed: LED2.5 (CG), R9.2
unnamed: IC1.11 (SCK), IC2.11 (SCK), IC3.11 (SCK), JP1.3, JP2.3
unnamed: LED3.4 (CR), R19.2
unnamed: LED3.6 (CB), R20.2
unnamed: LED3.5 (CG), R21.2
unnamed: LED7.4 (CR), R22.2
unnamed: LED7.6 (CB), R23.2
unnamed: LED7.5 (CG), R24.2
VCC: IC1.10 (SCL), IC1.16 (VCC), IC2.10 (SCL), IC2.16 (VCC), IC3.10 (SCL), IC3.16 (VCC), JP1.5, JP2.5

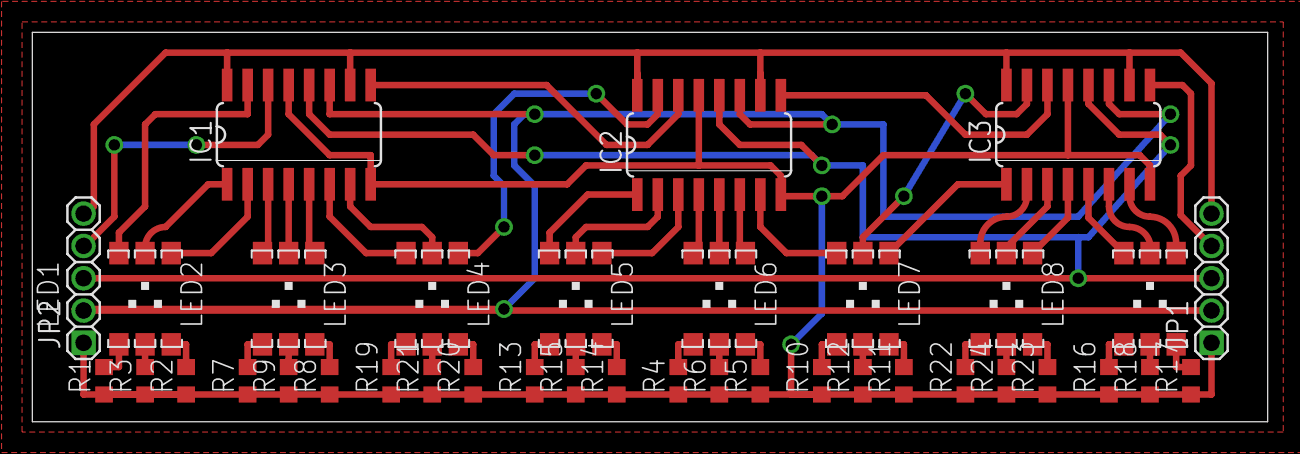
[picture p278: board circuitPendulumLEDs.brd from above]

Board: 2 copper layers, 76.5 x 24.1 mm, 37 parts (0 on the bottom side), 56 nets.
