MrPerfekt/Maya/eagle/pendulum00/circuitPendulumBrushes.brd

## EAGLE design eagle/pendulum00/circuitPendulumBrushes.brd (2017-01-21)

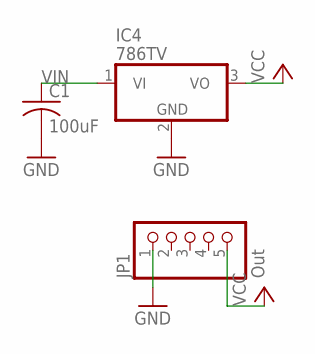
[picture p279: schematic circuitPendulumBrushes.sch]

Parts:
C1: 100uF; C050-045X075
IC4: 786TV; TO220V
JP1: Out; 1_05X2MM

Connections:
GND: C1.2, IC4.2 (GND), JP1.1
VCC: IC4.3 (VO), JP1.5
VIN: C1.1, IC4.1 (VI)

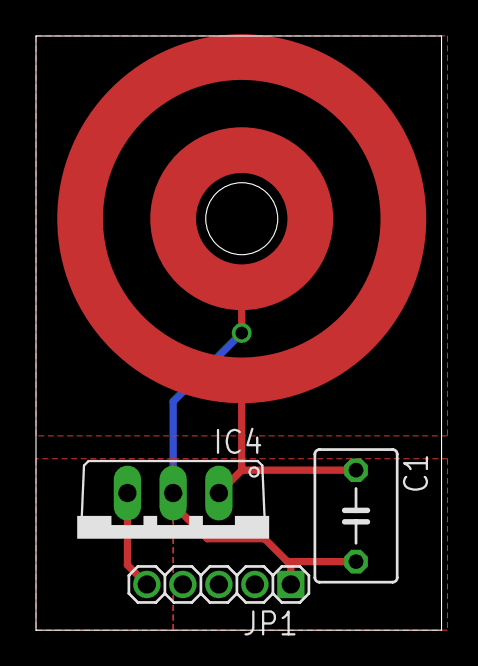
[picture p280: board circuitPendulumBrushes.brd from above]

Board: 2 copper layers, 22.5 x 33.0 mm, 3 parts (0 on the bottom side), 3 nets.
