MrPerfekt/Maya/eagle/pendulum00/circuitPendulumController01.brd

## EAGLE design eagle/pendulum00/circuitPendulumController01.brd (2017-01-21)

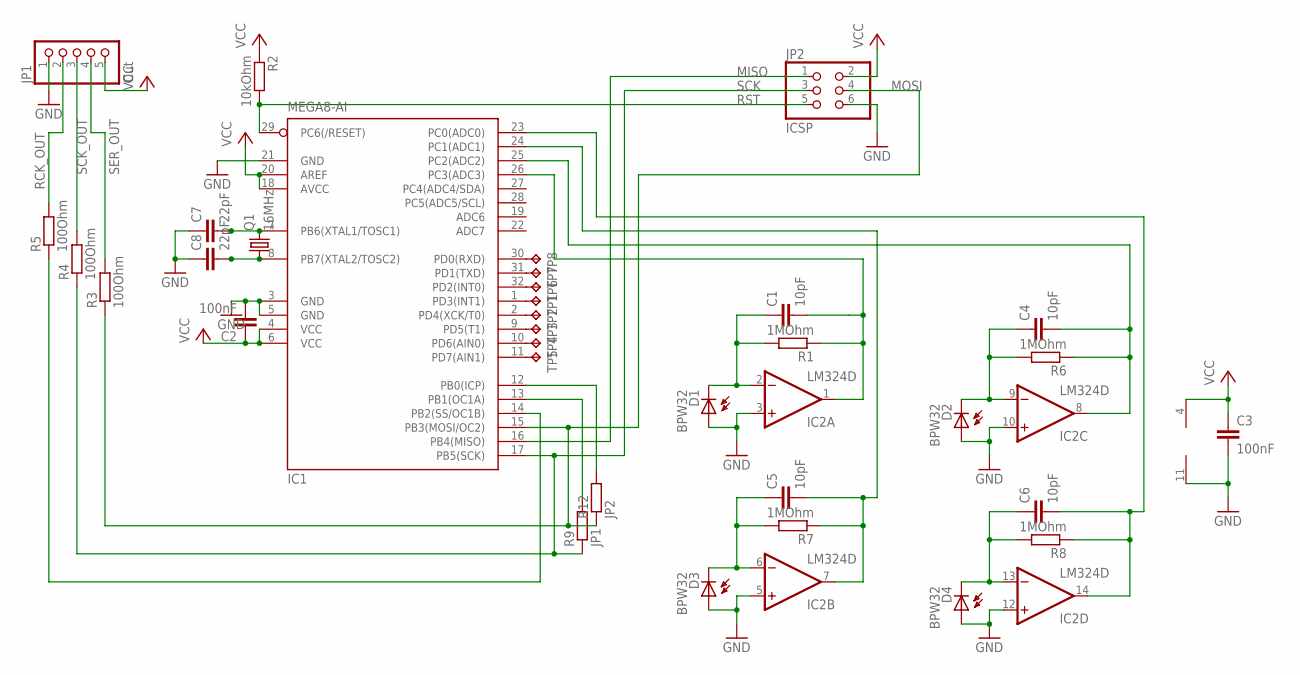
[picture p281: schematic circuitPendulumController01.sch]

Parts:
C1, C4, C5, C6: 10pF; C0603
C2, C3: 100nF; C0603
C7, C8: 22pF; C0603
D1, D2, D3, D4: BPW32
IC1: MEGA8-AI; TQFP32-08
IC2: LM324D; SO14
JP1: Out; 1_05X2MM
JP2: ICSP; 2X03
Q1: 16MHz; HC49/S
R1, R6, R7, R8: 1MOhm; R0603
R2: 10kOhm; R0603
R3, R4, R5: 100Ohm; R0603
R9: JP1; R0402
R12: JP2; R0402
TP1, TP2, TP3, TP4, TP5, TP6, TP7, TP8: TPTP11R; TP11R

Connections:
GND: C2.2, C3.2, C7.1, C8.1, D1.A, D2.A, D3.A, D4.A, IC1.3 (GND), IC1.5 (GND), IC1.21 (GND), IC2.3 (+IN), IC2.5 (+IN), IC2.10 (+IN), IC2.11 (V-), IC2.12 (+IN), JP1.1, JP2.6
MISO: IC1.16 (PB4(MISO)), JP2.1
MOSI: IC1.15 (PB3(MOSI/OC2)), JP2.4, R3.1, R12.1
unnamed: IC1.12 (PB0(ICP)), R12.2
unnamed: IC1.13 (PB1(OC1A)), R9.2
unnamed: IC1.14 (PB2(SS/OC1B)), R5.1
unnamed: C4.2, IC1.25 (PC2(ADC2)), IC2.8 (OUT), R6.1
unnamed: C1.1, D1.K (C), IC2.2 (-IN), R1.2
unnamed: C5.1, D3.K (C), IC2.6 (-IN), R7.2
unnamed: C5.2, IC1.24 (PC1(ADC1)), IC2.7 (OUT), R7.1
unnamed: C1.2, IC1.26 (PC3(ADC3)), IC2.1 (OUT), R1.1
unnamed: C6.2, IC1.23 (PC0(ADC0)), IC2.14 (OUT), R8.1
unnamed: C6.1, D4.K (C), IC2.13 (-IN), R8.2
unnamed: C4.1, D2.K (C), IC2.9 (-IN), R6.2
unnamed: C7.2, IC1.7 (PB6(XTAL1/TOSC1)), Q1.2
unnamed: C8.2, IC1.8 (PB7(XTAL2/TOSC2)), Q1.1
unnamed: IC1.1 (PD3(INT1)), TP1.TP
unnamed: IC1.2 (PD4(XCK/T0)), TP2.TP
unnamed: IC1.9 (PD5(T1)), TP3.TP
unnamed: IC1.10 (PD6(AIN0)), TP4.TP
unnamed: IC1.11 (PD7(AIN1)), TP5.TP
unnamed: IC1.32 (PD2(INT0)), TP6.TP
unnamed: IC1.31 (PD1(TXD)), TP7.TP
unnamed: IC1.30 (PD0(RXD)), TP8.TP
RCK_OUT: JP1.2, R5.2
RST: IC1.29 (PC6(/RESET)), JP2.5, R2.2
SCK: IC1.17 (PB5(SCK)), JP2.3, R4.1, R9.1
SCK_OUT: JP1.3, R4.2
SER_OUT: JP1.4, R3.2
VCC: C2.1, C3.1, IC1.4 (VCC), IC1.6 (VCC), IC1.18 (AVCC), IC1.20 (AREF), IC2.4 (V+), JP1.5, JP2.2, R2.1

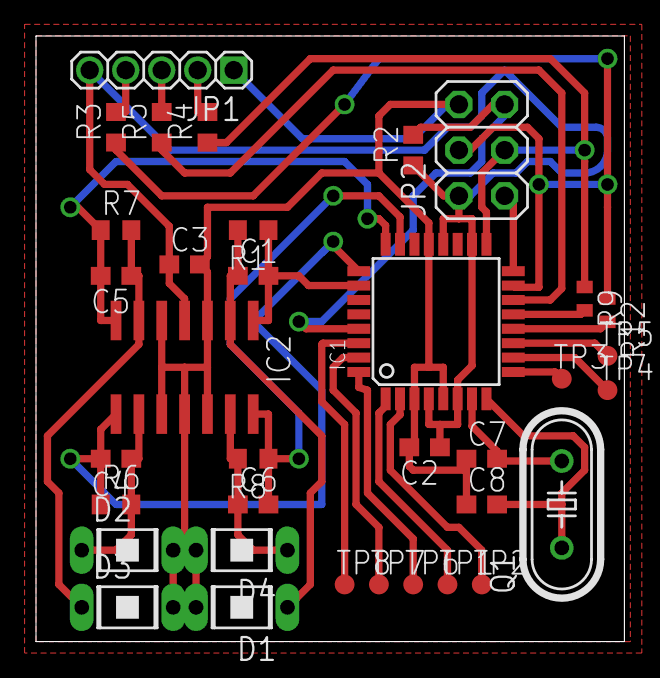
[picture p282: board circuitPendulumController01.brd from above]

Board: 2 copper layers, 32.7 x 33.6 mm, 35 parts (0 on the bottom side), 30 nets.
