MrPerfekt/Maya/eagle/pendulum02/circuitPendulumTIA00.brd

## EAGLE design eagle/pendulum02/circuitPendulumTIA00.brd (2017-01-21)

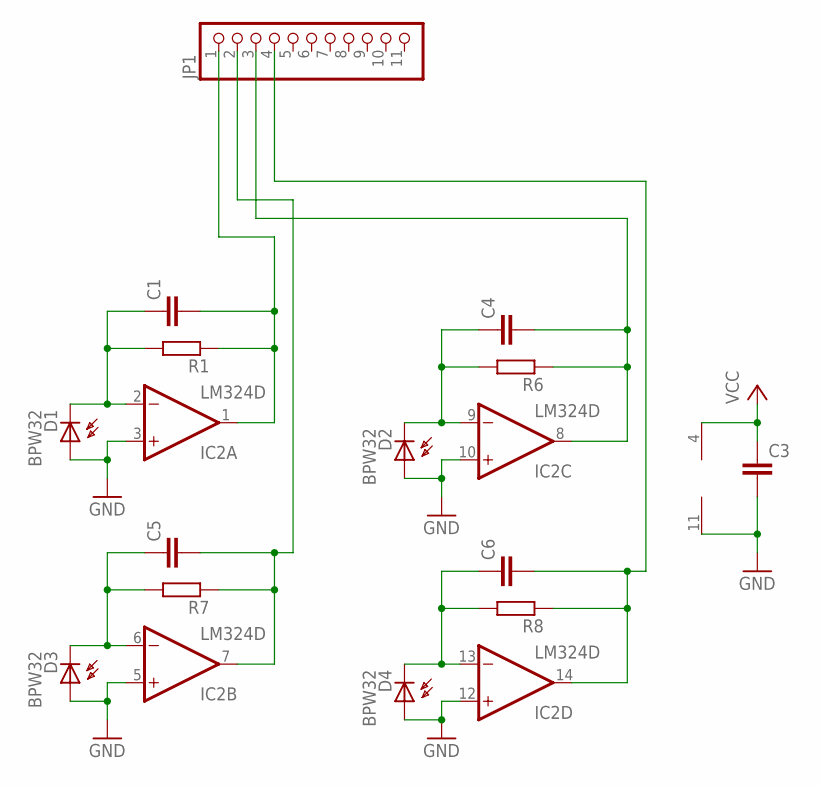
[picture p283: schematic circuitPendulumTIA00.sch]

Parts:
C1, C3, C4, C5, C6: C-EUC0603; C0603
D1, D2, D3, D4: BPW32
IC2: LM324D; SO14
JP1: PINHD-1X11_2.00; 1X11M
R1, R6, R7, R8: R-EU_R0603; R0603

Connections:
GND: C3.2, D1.A, D2.A, D3.A, D4.A, IC2.3 (+IN), IC2.5 (+IN), IC2.10 (+IN), IC2.11 (V-), IC2.12 (+IN)
unnamed: C4.2, IC2.8 (OUT), JP1.3, R6.1
unnamed: C1.1, D1.K (C), IC2.2 (-IN), R1.2
unnamed: C5.1, D3.K (C), IC2.6 (-IN), R7.2
unnamed: C5.2, IC2.7 (OUT), JP1.2, R7.1
unnamed: C1.2, IC2.1 (OUT), JP1.1, R1.1
unnamed: C6.2, IC2.14 (OUT), JP1.4, R8.1
unnamed: C6.1, D4.K (C), IC2.13 (-IN), R8.2
unnamed: C4.1, D2.K (C), IC2.9 (-IN), R6.2
VCC: C3.1, IC2.4 (V+)

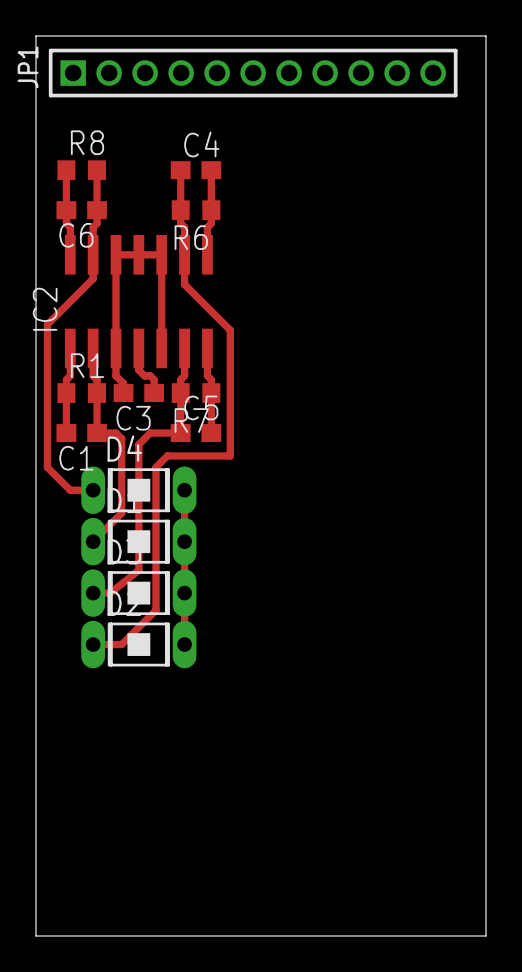
[picture p284: board circuitPendulumTIA00.brd from above]

Board: 2 copper layers, 25.0 x 50.0 mm, 15 parts (0 on the bottom side), 10 nets.
