MrPerfekt/Maya/eagle/pendulum02/circuitPendulumTIA.brd

## EAGLE design eagle/pendulum02/circuitPendulumTIA.brd (2017-01-21)

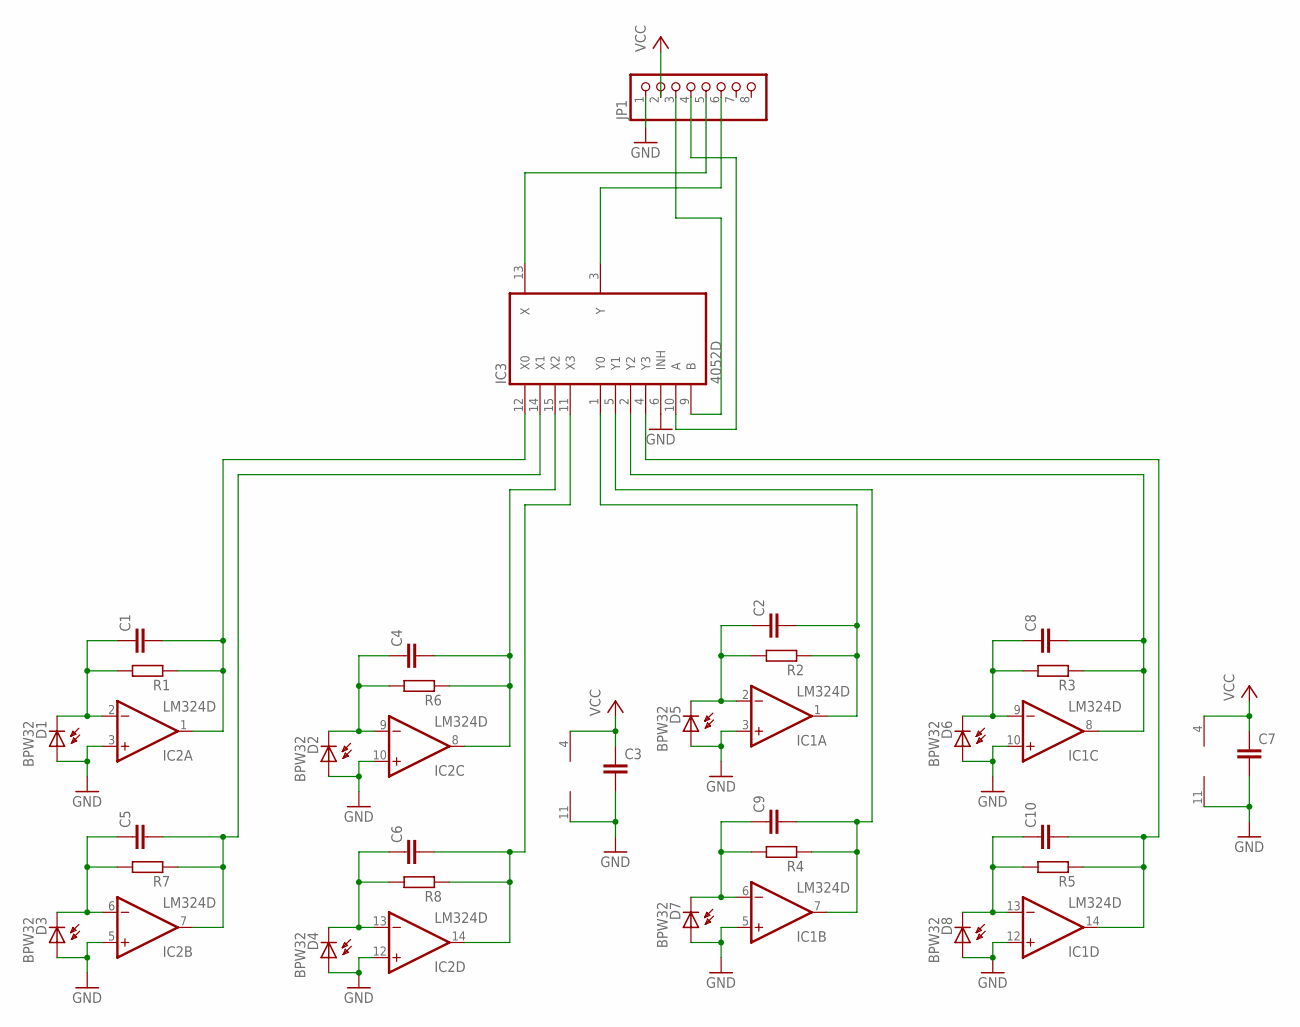
[picture p285: schematic circuitPendulumTIA.sch]

Parts:
C1, C2, C3, C4, C5, C6, C7, C8, C9, C10: C-EUC0603; C0603
D1, D2, D3, D4, D5, D6, D7, D8: BPW32
IC1, IC2: LM324D; SO14
IC3: 4052D; SO16
JP1: PINHD-1X8_2.54; 1X08
R1, R2, R3, R4, R5, R6, R7, R8: R-EU_R0603; R0603

Connections:
GND: C3.2, C7.2, D1.A, D2.A, D3.A, D4.A, D5.A, D6.A, D7.A, D8.A, IC1.3 (+IN), IC1.5 (+IN), IC1.10 (+IN), IC1.11 (V-), IC1.12 (+IN), IC2.3 (+IN), IC2.5 (+IN), IC2.10 (+IN), IC2.11 (V-), IC2.12 (+IN), IC3.6 (INH), IC3.8 (GND), JP1.1
unnamed: C2.1, D5.K (C), IC1.2 (-IN), R2.2
unnamed: C2.2, IC1.1 (OUT), IC3.1 (Y0), R2.1
unnamed: C8.2, IC1.8 (OUT), IC3.2 (Y2), R3.1
unnamed: C9.1, D7.K (C), IC1.6 (-IN), R4.2
unnamed: C9.2, IC1.7 (OUT), IC3.5 (Y1), R4.1
unnamed: C10.2, IC1.14 (OUT), IC3.4 (Y3), R5.1
unnamed: C4.2, IC2.8 (OUT), IC3.15 (X2), R6.1
unnamed: C1.1, D1.K (C), IC2.2 (-IN), R1.2
unnamed: C5.1, D3.K (C), IC2.6 (-IN), R7.2
unnamed: C5.2, IC2.7 (OUT), IC3.14 (X1), R7.1
unnamed: C1.2, IC2.1 (OUT), IC3.12 (X0), R1.1
unnamed: C6.2, IC2.14 (OUT), IC3.11 (X3), R8.1
unnamed: C6.1, D4.K (C), IC2.13 (-IN), R8.2
unnamed: C4.1, D2.K (C), IC2.9 (-IN), R6.2
unnamed: C10.1, D8.K (C), IC1.13 (-IN), R5.2
unnamed: C8.1, D6.K (C), IC1.9 (-IN), R3.2
unnamed: IC3.13 (X), JP1.5
unnamed: IC3.3 (Y), JP1.6
unnamed: IC3.10 (A), JP1.4
unnamed: IC3.9 (B), JP1.3
VCC: C3.1, C7.1, IC1.4 (V+), IC2.4 (V+), IC3.16 (VCC), JP1.2
VEE: IC3.7 (VEE)

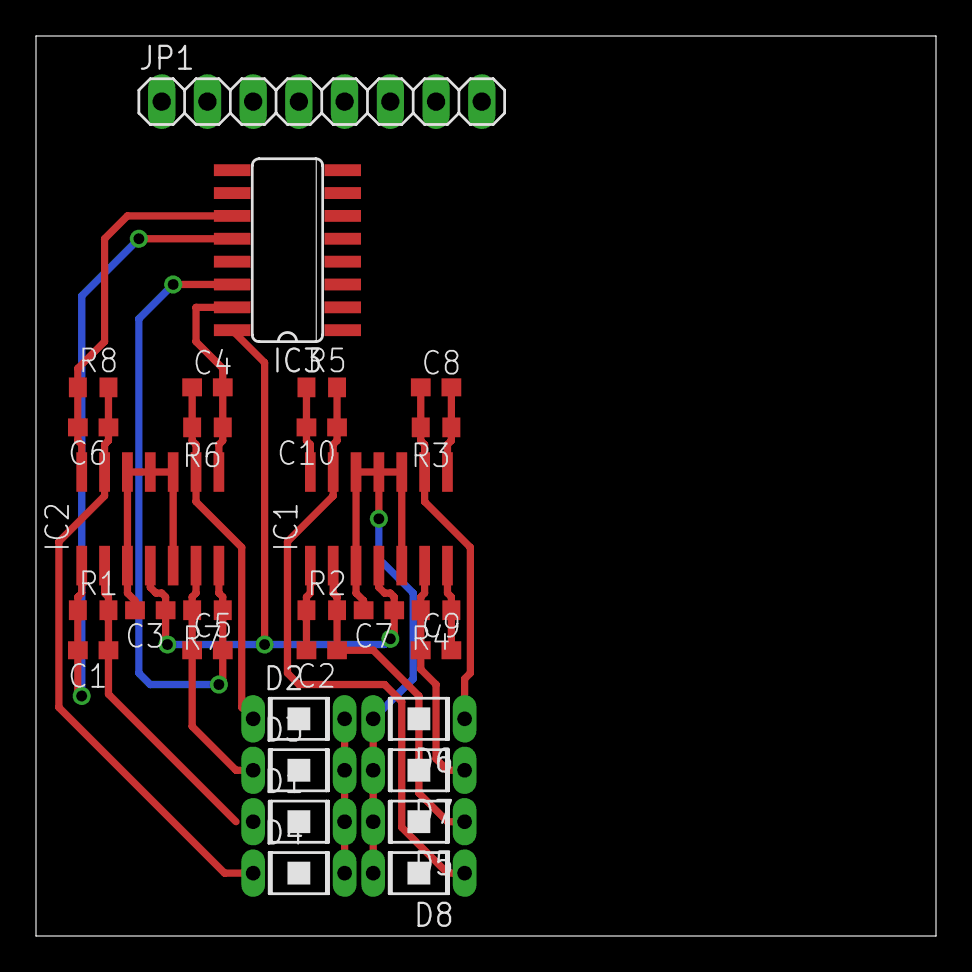
[picture p286: board circuitPendulumTIA.brd from above]

Board: 2 copper layers, 50.0 x 50.0 mm, 30 parts (0 on the bottom side), 22 nets.
