MrPerfekt/Maya/arduino/version08/maya/maya.ino

#include "config.h"
#include "encoder.h"
#include "stepper.h"
#include "timer.h"
#include "differenceIntensityLaserDetector.h"
#include "interruptLaserDetector.h"
#include "encoder.h"
#include "simpleLowPassFilter.h"
#include "counter.h"
#include "fakeCounter.h"
#include "debug.h"
#include "diodePositionController.h"
#include "mathematicPositionController.h"
#include "approximationPositionController.h"
#include "remotePositionController.h"
#include "stepperWatcher.h"


//
// 5-Way-Switch
//
volatile bool switchAction[switchCnt] = { false };
void switch0() {
	switchAction[0] = true;
}
void switch1() {
	switchAction[1] = true;
}
void switch2() {
	switchAction[2] = true;
}
void switch3() {
	switchAction[3] = true;
}
void switch4() {
	switchAction[4] = true;
}
void(*switchFP[switchCnt])() = { switch0 ,switch1, switch2,switch3,switch4 };

//
// LightBarrier
//
//void lightBarrierStepperUpdate();
volatile bool lightBarrierAction[lightBarrierCount] = { false };
void lightBarrier0() {
	lightBarrierAction[0] = true;
}
void lightBarrier1() {
	lightBarrierAction[1] = true;
}
void lightBarrier2() {
	lightBarrierAction[2] = true;
	//lightBarrierStepperUpdate();
}
void lightBarrier3() {
	lightBarrierAction[3] = true;
	//lightBarrierStepperUpdate();
}
void(*lightBarrierFP[lightBarrierCount])() = { lightBarrier0 ,lightBarrier1, lightBarrier2,lightBarrier3 };

//
// Encoder
//
#if FAKE_ENCODER != 1
PositionerCounter* encoderPositionCounter = new Encoder(pinEncoder, { 0 });
#else
PositionerCounter* encoderPositionCounter = new FakeCounter(encoderFP);
void TC0_Handler() {
	TIMER_INTERRUPT_TIMING_WRITE_F(HIGH);
	TC_GetStatus(TC0, 0);
	encoderPositionCounter->update();
	TIMER_INTERRUPT_TIMING_WRITE_F(LOW);
}
#endif

//
// KnobEncoder
//
volatile bool buttonPressed[knobCount] = { false };
volatile bool knobEncoderChanged[knobCount] = { false };
void knobEncoderPos0() {
	knobEncoderChanged[0] = true;
}
void knobEncoderButton0() {
	buttonPressed[0] = true;
}
void knobEncoderPos1() {
	knobEncoderChanged[1] = true;
}
void knobEncoderButton1() {
	buttonPressed[1] = true;
}
void knobEncoderPos2() {
	knobEncoderChanged[2] = true;
}
void knobEncoderButton2() {
	buttonPressed[2] = true;
}
void(*knobEncoderFP[knobCount])() = { knobEncoderPos0, knobEncoderPos1, knobEncoderPos2 };
void(*knobEncoderButtonFP[knobCount])() = { knobEncoderButton0, knobEncoderButton1, knobEncoderButton2 };
PositionerCounter* knobEncoder[knobCount] = { new Encoder(pinKnobEncoder[0], knobEncoderFP[0]), new Encoder(pinKnobEncoder[1], knobEncoderFP[1]), new Encoder(pinKnobEncoder[2], knobEncoderFP[2]) };

//
// Stepper
//
int16_t driveStepperCurrentFrequency = 0;
int16_t driveStepperTargetFrequency = 0;
int16_t driveStepperStepTimeChangeLoopCount = 0;
int8_t driveStepperTargetDirection = 1;

Stepper* stepper[stepperCount] = { new Stepper(Stepper::unipolar, stepperPins[stepperNrH]), new Stepper(Stepper::unipolar, stepperPins[stepperNrV]), new Stepper(Stepper::bipolar, stepperPins[stepperNrS]) };
StepperWatcher* stepperWatcher[stepperWatcherCount] = { new StepperWatcher(stepper[stepperNrH],stepperWatcherInputPins[stepperNrH],stepperWatcherMinStepTime), new StepperWatcher(stepper[stepperNrV],stepperWatcherInputPins[stepperNrV],stepperWatcherMinStepTime) };

void TC3_Handler() { //3.63us, 0.29%
	TIMER_INTERRUPT_TIMING_WRITE_A(HIGH);
	TC_GetStatus(TC1, 0);
	stepper[stepperNrV]->stepAndUpdate();
	stepper[stepperNrH]->stepAndUpdate();
	TIMER_INTERRUPT_TIMING_WRITE_A(LOW);
}
void TC4_Handler() {//3.047us, 0.06%
	TIMER_INTERRUPT_TIMING_WRITE_B(HIGH);
	TC_GetStatus(TC1, 1);
	TIMER_INTERRUPT_TIMING_WRITE_B(LOW);
	stepper[2]->stepAndUpdate();
}

//
// Laser
//
DifferenceIntensityLaserDetector* laserDetector = new DifferenceIntensityLaserDetector(photoDiodeCount, laserPin, photoDiodePin);
Filter<double> *filter[photoDiodeCount] = { new SimpleLowPassFilter<double>(photoDiodeFilterTimeConstant), new SimpleLowPassFilter<double>(photoDiodeFilterTimeConstant), new SimpleLowPassFilter<double>(photoDiodeFilterTimeConstant), new SimpleLowPassFilter<double>(photoDiodeFilterTimeConstant) };
InterruptLaserDetector* interruptLaserDetector = InterruptLaserDetector::initInstance(laserDetector, filter, laserFrequency, laserWaitTime, 0, photoDiodeFilterTimeConstant == 1 ? false : true);

//
// PositionController
//
DiscPositioner* discPositioner = DiscPositioner::initInstance(encoderPositionCounter, encoderSteppsPerRevolution, encoderBigMarkSize, encoderSteppDistance, encoderUseTimeCorrection);
PositionController* positionController;

//
// ==== SETUP ====
//
void setup() {
	//==Serial==
	Serial.begin(460800);

	//==Stepper==
	setupStepper();

	//==Knob Encoder==
	for (int i = 0; i < knobCount; i++) {
		knobEncoder[i]->init();
		//attachInterrupt(pinKnobEncoder[i], knobEncoderFP[i], FALLING);
		attachInterrupt(pinKnobEncoderButton[i], knobEncoderButtonFP[i], FALLING);
	}

	//==LightBarrier==
	for (int i = 0; i < lightBarrierCount; i++) {
		pinMode(lightBarrierPins[i], INPUT);
		attachInterrupt(lightBarrierPins[i], lightBarrierFP[i], CHANGE);
	}

	//==5-Way-Switch==
	for (int i = 0; i < switchCnt; i++) {
		pinMode(pinSwitch[i], INPUT);
		attachInterrupt(pinSwitch[i], switchFP[i], FALLING);
	}

	//==Laser==
	interruptLaserDetector->init();

	//==DebugPin==
	pinMode(debugPin, OUTPUT);
	digitalWrite(debugPin, LOW);

	//==Encoder==
	encoderPositionCounter->init();
	discPositioner->init();
#if FAKE_ENCODER == 1
	startTimer(TC0, 0, TC0_IRQn, fakeEncoderCounterFrequency);
#endif

	//==PositionController==
	if (positionControllerType == POSITION_CONTROLLER_DIODE) {
		positionController = DiodePositionController::initInstance(stepper[stepperNrH], stepper[stepperNrV], discPositioner, interruptLaserDetector);
	} else if (positionControllerType == POSITION_CONTROLLER_MATHEMATIC) {
		positionController = MathematicPositionController::initInstance(stepper[stepperNrH], stepper[stepperNrV], discPositioner);
	} else if (positionControllerType == POSITION_CONTROLLER_APPROXIMATION) {
		positionController = ApproximationPositionController::initInstance(stepper[stepperNrH], stepper[stepperNrV], discPositioner);
	} else if (positionControllerType == POSITION_CONTROLLER_REMOTE) {
		positionController = RemotePositionController::initInstance(stepperWatcher[stepperNrH], stepperWatcher[stepperNrV], discPositioner, interruptLaserDetector, lightBarrierCount, lightBarrierPins, lightBarrierOutputPins);
	}
	positionController->init();

	Serial.println("init finish");
}
void setupStepper() {
	for (int i = 0; i < stepperCount; i++) {
		stepper[i]->init();
	}
	startTimer(TC1, 0, TC3_IRQn, (uint32_t)stepperFrequency01);

	stepperWatcher[stepperNrH]->init();
	stepperWatcher[stepperNrV]->init();
}

bool lateInitDone = false;
void lateInit() {
	lateInitDone = true;

#if DO_INIT_STEPPER_POS == 1
	bool finishedH;
	bool finishedV;
	do {
		int inH = digitalRead(lightBarrierPins[lightBarrierStepperNrH]);
		int inV = digitalRead(lightBarrierPins[lightBarrierStepperNrV]);
		finishedH = stepper[stepperNrH]->initPosUpdate(inH);
		finishedV = stepper[stepperNrV]->initPosUpdate(inV);
	} while (!finishedH || !finishedV);
	stepper[stepperNrH]->posDelta = stepperStartPosH;
	stepper[stepperNrV]->posDelta = stepperStartPosV;
#endif

#if DISC_STEPPER_RUNNING == 1
	stepper[stepperNrS]->pos = Stepper::posInfinity;
	startTimer(TC1, 1, TC4_IRQn, (uint32_t)stepperStartFrequency2);
#endif
}

//
// ==== LOOP ====
//
uint32_t lastMainTime = 0;
void loop() {
	if (!lateInitDone) {
		lateInit();
		//validatePhotodiodes();
	}

	for (int i = 0; i < knobCount; i++) {
		if (buttonPressed[i]) {
			buttonPressed[i] = false;
			Serial.print("but ");
			Serial.println(i);
			if (i == 0) {
				stepper[2]->posDelta += 200;
			}
			if (i == 1) {
				Serial.print(stepper[0]->posDelta);
				Serial.print("\t");
				Serial.print(stepper[1]->posDelta);
				Serial.print("\t");
				Serial.print(stepper[0]->pos);
				Serial.print("\t");
				Serial.print(stepper[1]->pos);
				Serial.print("\t");
				volatile uint16_t* photoDiodeIntensity = interruptLaserDetector->measuredValues;
				Serial.print(photoDiodeIntensity[0]);
				Serial.print("\t");
				Serial.print(photoDiodeIntensity[1]);
				Serial.print("\t");
				Serial.print(photoDiodeIntensity[2]);
				Serial.print("\t");
				Serial.println(photoDiodeIntensity[3]);
			}
			if (i == 2) {
				driveStepperTargetDirection *= -1;
				driveStepperTargetFrequency *= -1;
			}
		}
		if (knobEncoderChanged[i]) {
			knobEncoderChanged[i] = false;
			Serial.print("enc ");
			Serial.println(i);
			if (i == 0 || i == 1) {
				//stepper[stepperNrH]->posDelta = stepperStartPosH + knobEncoder[0]->pos * 10;
				//stepper[stepperNrV]->posDelta = stepperStartPosV + knobEncoder[1]->pos * 10;
				Serial.print("\t");
				Serial.print(knobEncoder[0]->pos);
				Serial.print("\t");
				Serial.println(knobEncoder[1]->pos);
			} else if (i == 2) {
				Serial.println(knobEncoder[2]->pos);
				if (knobEncoder[2]->pos < 0) {
					knobEncoder[2]->pos = 0;
				} else if (knobEncoder[2]->pos * 2 > stepperMaxFrequency2) {
					knobEncoder[2]->pos = stepperMaxFrequency2 / 2;
				} else {
					driveStepperTargetFrequency = knobEncoder[2]->pos * 2 * driveStepperTargetDirection;
				}
			}
		}
	}
	for (uint8_t i = 0; i < lightBarrierCount; i++) {
		if (lightBarrierAction[i]) {
			lightBarrierAction[i] = false;
			Serial.print("light ");
			Serial.println(i);
		}
	}
	for (uint8_t i = 0; i < switchCnt; i++) {
		if (switchAction[i]) {
			switchAction[i] = false;
			Serial.print("switch ");
			Serial.println(i);
			if (i == switchUp) {
				stepper[stepperNrV]->posDelta += 10;
			}
			if (i == switchDown) {
				stepper[stepperNrV]->posDelta -= 10;
			}
			if (i == switchMiddle) {
			}
			if (i == switchRight) {
				stepper[stepperNrH]->posDelta += 10;
			}
			if (i == switchLeft) {
				stepper[stepperNrH]->posDelta -= 10;
			}
		}
	}
	MAIN_LOOP_TIMING_WRITE_A(HIGH);
	while (micros() - lastMainTime < mainTimeDiff);
	MAIN_LOOP_TIMING_WRITE_A(LOW);
	lastMainTime = micros();
	positionController->update();
	//Set stepper speed
	if (driveStepperCurrentFrequency != driveStepperTargetFrequency) {
		driveStepperStepTimeChangeLoopCount++;
		if (driveStepperStepTimeChangeLoopCount >= driveStepperStepTimeChangeDivider) {
			driveStepperStepTimeChangeLoopCount = 0;
			if (driveStepperCurrentFrequency > driveStepperTargetFrequency) {
				driveStepperCurrentFrequency = max(driveStepperCurrentFrequency - stepperSoftSpeedStep, driveStepperTargetFrequency);
			} else {
				driveStepperCurrentFrequency = min(driveStepperCurrentFrequency + stepperSoftSpeedStep, driveStepperTargetFrequency);
			}
			if (driveStepperCurrentFrequency != 0) {
				Serial.println(driveStepperCurrentFrequency);
				Serial.println(driveStepperTargetFrequency);
				Serial.println(stepperSoftSpeedStep);
				Serial.flush();
				stepper[stepperNrS]->pos = (Stepper::posInfinity-1) * (driveStepperCurrentFrequency > 0 ? 1 : -1);
				startTimer(TC1, 1, TC4_IRQn, (uint32_t)abs(driveStepperCurrentFrequency));
			} else {
				stepper[stepperNrS]->pos = stepper[stepperNrS]->posReal = 0;
			}
		}
	}
}


void validatePhotodiodes() {
	const int16_t sizeH = 40;
	const int16_t sizeV = 30;
	const int16_t startH = -sizeH / 2;
	const int16_t startV = -sizeV / 2;
	const int16_t endH = sizeH / 2;
	const int16_t endV = sizeV / 2;
	const int16_t stepSizeH = 1;
	const int16_t stepSizeV = 1;
	const int16_t stepCountH = (endH - startH) / stepSizeH;
	const int16_t stepCountV = (endV - startV) / stepSizeV;
	const uint16_t waitAfterStepForMotor = 100;
	const uint16_t waitAfterStepForLaser = photoDiodeFilterTimeConstant * 10.0 * 1000.0 / laserFrequency;
	const uint16_t waitAfterStep = waitAfterStepForMotor;// +waitAfterStepForLaser;
	const uint8_t photodiodeCnt = 4;
	const uint16_t meanValues = 100;

	
	
	stepper[stepperNrH]->pos = 0;
	stepper[stepperNrV]->pos = 0;
	while (!stepper[stepperNrH]->reachedTarget());
	while (!stepper[stepperNrV]->reachedTarget());
	delay(2000);
	/*
	stepper[stepperNrH]->pos = startH;
	stepper[stepperNrV]->pos = startV;
	delay(3000);
	stepper[stepperNrH]->pos = startH + stepCountH*stepSizeH;
	stepper[stepperNrV]->pos = startV + stepCountV*stepSizeV;
	while (1);
	*/
	

	for (int16_t v = 0; v <= stepCountV; v++) {
	for (int16_t h = 0; h <= stepCountH; h++) {
			stepper[stepperNrH]->pos = startH + h*stepSizeH;
			stepper[stepperNrV]->pos = startV + v*stepSizeV;
			while (!stepper[stepperNrH]->reachedTarget());
			while (!stepper[stepperNrV]->reachedTarget());
			delay(waitAfterStep);

			double averageValues[photodiodeCnt] = { 0,0,0,0 };
			for (size_t valCnt = 0; valCnt < meanValues; valCnt++) {
				interruptLaserDetector->measurementFinished = false;
				while (!interruptLaserDetector->measurementFinished);
				for (uint8_t i = 0; i < photodiodeCnt; i++) {
					averageValues[i] += interruptLaserDetector->measuredValues[i];
				}
			}
			for (size_t i = 0; i < photoDiodeCount; i++) {
				averageValues[i] /= meanValues;
			}

			Serial.print(h);
			Serial.print("\t");
			Serial.print(v);
			Serial.print("\t");
			for (uint8_t i = 0; i < 4; i++) {
				Serial.print(averageValues[i]);
				if (i != 3) {
					Serial.print("\t");
				}
			}
			Serial.println();
			Serial.flush();
		}
	}
	while (1);
}
